eSpark-Backup/grantkros-coopmonitor/Deliverable/Main_Board/Renderings/2D_C_View.PNG

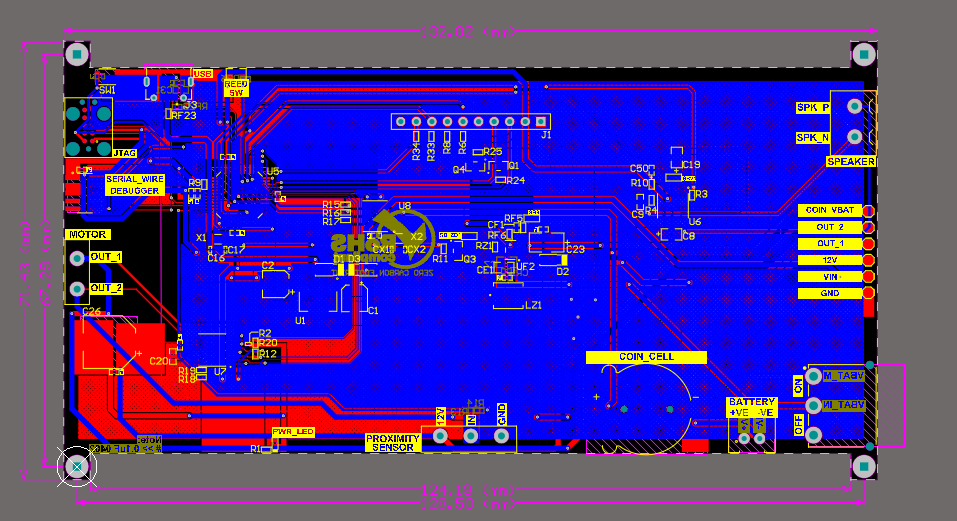
Deliverable/Main_Board/Renderings/2D_C_View.PNG
