eSpark-Backup/grantkros-coopmonitor/README.md

# GrantKros-CoopMonitor
To develop / modify existing hardware for a product that monitors and controls opening and closing of a Chicken Coop thus eliminating the need for manual operations. The product is battery powered and utilizes RTC (Real Time Clock) in order to keep track of time and open / close the door automatically at set time. The firmware Logic development is also scope of product.

# Hardware Development Document
https://docs.google.com/document/d/1zBJtBbxTIhBSu4QpVf2IS5n5_eFdffxUGF-tXFF0SV0/edit

# Firmware Development Document
https://docs.google.com/document/d/1wYKQdFfrymjJKDasLPa5_Pwm-jOFM6-b_R_Tf0VFCMQ/edit
