eSpark-Backup/grantkros-coopmonitor/Design-Files/Grant..PcbDoc.htm

Reporting Options

# File in Previous Format

Date | : | 3/16/2022
Time | : | 1:12:25 PM
Filename | : | D:\Github\GrantKros-CoopMonitor\Design-Files\Grant..PcbDoc

Version | Warning

This file was generated by an earlier version of the software
