eSpark-Backup/grantkros-coopmonitor/Deliverable/Interface_Board/Renderings/2D_Top_View.PNG

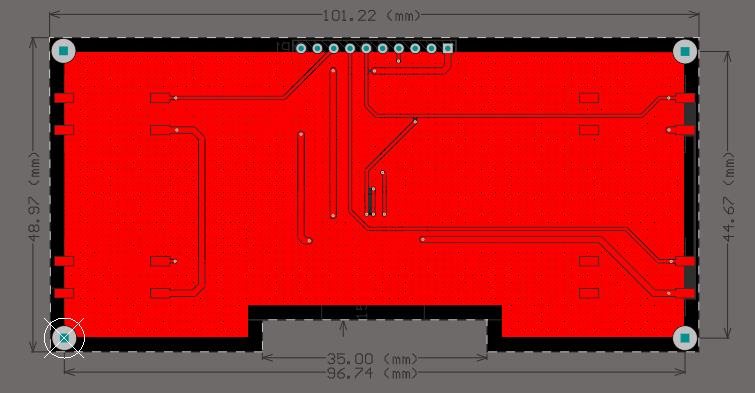
Deliverable/Interface_Board/Renderings/2D_Top_View.PNG
