eSpark-Backup/grantkros-coopmonitor/Deliverable/Interface_Board/Renderings/3D_Top_View.PNG

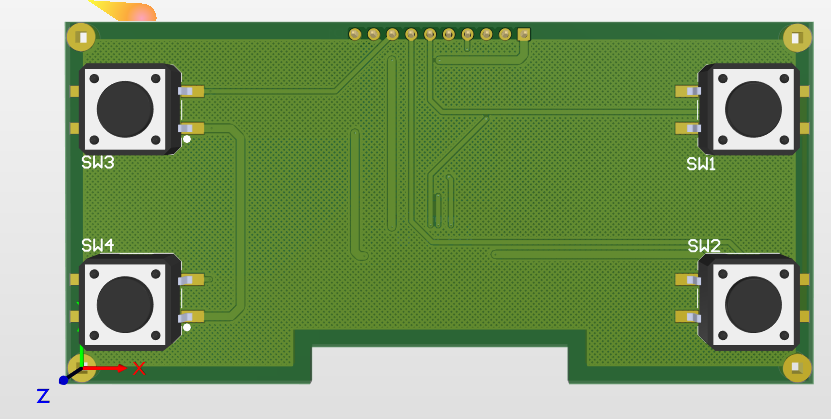
Deliverable/Interface_Board/Renderings/3D_Top_View.PNG
