eSpark-Backup/grantkros-coopmonitor/Deliverable/Interface_Board/Renderings/Isometric_View.PNG

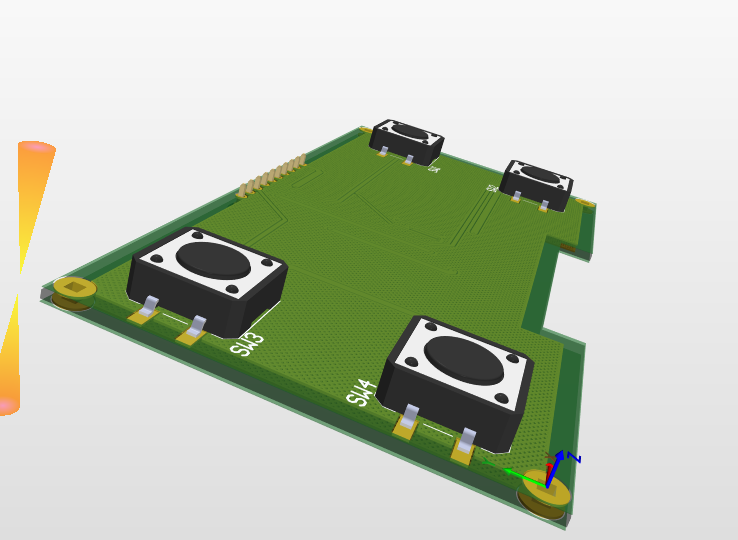
Deliverable/Interface_Board/Renderings/Isometric_View.PNG
