eSpark-Backup/grantkros-coopmonitor/Deliverable/Main_Board/Renderings/2D_Top_View.PNG

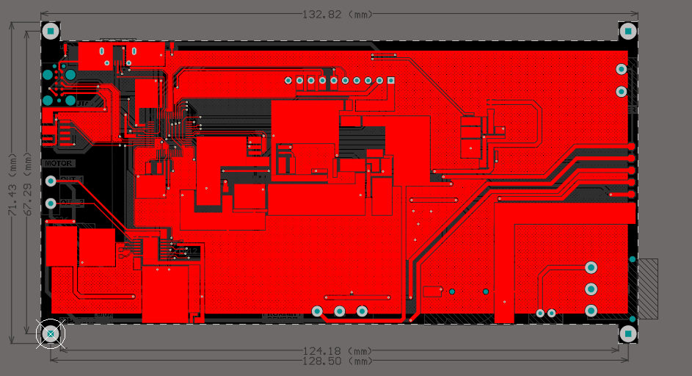
Deliverable/Main_Board/Renderings/2D_Top_View.PNG
