eSpark-Backup/grantkros-coopmonitor/Deliverable/Main_Board/Renderings/Isometric_View.PNG

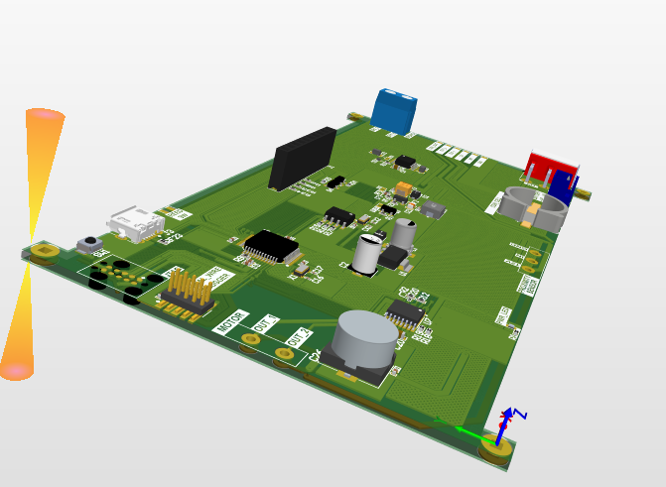
Deliverable/Main_Board/Renderings/Isometric_View.PNG
