eSpark-Backup/grantkros-coopmonitor/PCB Review/1.PNG

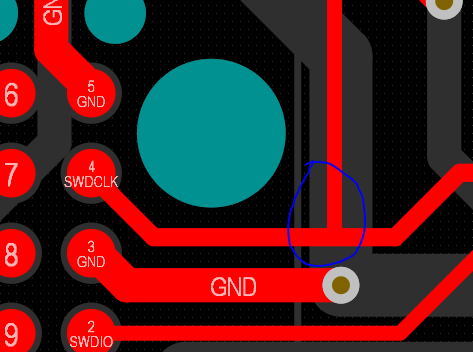
PCB Review/1.PNG
