eSpark-Backup/grantkros-coopmonitor/Deliverable/BOM/BOM - Grant LCSC.xlsx

Bill of Material (BOM) for Grant
S. No. | Comment Type | Description | Designator | Footprint (Package) | Manufacturer Part Number | LCSC Part Number | Manufacturer | Value | Quantity | Total Quantity | LCSC /MOQ | Link | Unit Price | Total Price | Remarks
1 | Capacitor | CAP CER 0.1UF 16V X7R 0402 | C1, C3, C10, C11, C12, C13, C14, C15, C18, C20, C24, C29, C30, C32, C36, CD, CF, CF1 | Cap0402 | CC0402KRX7R7BB104 | C60474 | Yageo | 0.1uF | 20 | 80 | 100 | LCSC (https://lcsc.com/product-detail/Multilayer-Ceramic-Capacitors-MLCC-SMD-SMT_YAGEO-CC0402KRX7R7BB104_C60474.html) | $0.002 | $0.24
2 |  | CAP CER 1UF 25V X5R 0402 | C2, C4 | Cap0402 | GRM155R61E105KA12D | C77009 | Murata | 1uF | 2 | 8 | 50 | LCSC (https://lcsc.com/product-detail/Multilayer-Ceramic-Capacitors-MLCC-SMD-SMT_muRata_GRM155R61E105KA12D_1uF-105-10-25V_C77009.html) | $0.007 | $0.35
3 |  | CAP CER 10000PF 25V X7R 0402 | C5, C27, CF6, CF7 | Cap0402 | CC0402KRX7R8BB103 | C327025 | Yageo | 10nF | 4 | 16 | 100 | LCSC (https://lcsc.com/product-detail/Multilayer-Ceramic-Capacitors-MLCC-SMD-SMT_YAGEO-CC0402KRX7R8BB103_C327025.html) | $0.002 | $0.22
4 |  | CAP CER 10UF 16V X5R 0603 | CF2 | Cap0603 | EMK107BBJ106MA-T | C90058 | Taiyo Yuden | 10uF | 1 | 4 | 10 | LCSC (https://lcsc.com/product-detail/Multilayer-Ceramic-Capacitors-MLCC-SMD-SMT_TAIYO-YUDEN_EMK107BBJ106MA-T_10uF-106-20-16V_C90058.html) | $0.050 | $0.50
5 |  | CAP CER 20PF 25V C0H 0201 | C16, C17, CX1, CX2 | Cap 0201 | GJM0336C1E200JB01D | C161300 | Murata | 20pF | 4 | 16 | 20 | LCSC (https://lcsc.com/product-detail/Multilayer-Ceramic-Capacitors-MLCC-SMD-SMT_Murata-Electronics-GJM0336C1E200JB01D_C161300.html) | $0.013 | $0.27
6 |  | CAP TANT POLY 100UF 16V 2917 | C19, C23 | Cap 2917 | 16TQC100MYF | C109085 | Panasonic | 100uF | 2 | 8 | 10 | LCSC (https://lcsc.com/product-detail/Tantalum-Capacitors_PANASONIC-16TQC100MYF_C109085.html) | $0.465 | $4.65
7 |  | 10pF ±5% 50V NP0 0402 | C21, C25 | Cap0402 | CC0402JRNPO9BN100 | C106199 | Yageo | 10pF | 2 | 8 | 100 | LCSC (https://lcsc.com/product-detail/Multilayer-Ceramic-Capacitors-MLCC-SMD-SMT_10pF-100-5-50V_C106199.html) | $0.002 | $0.22
8 |  | 33pF ±10% 25V NP0(C0G) 0402 Multilayer Ceramic Capacitors MLCC - SMD/SMT RoHS | C22, C26, C33, C34, C35 | Cap0402 | 0402N330K250CT | C387979 | Walsin Tech Corp | 33pF | 5 | 20 | 100 | LCSC (https://lcsc.com/product-detail/Multilayer-Ceramic-Capacitors-MLCC-SMD-SMT_Walsin-Tech-Corp-0402N330K250CT_C387979.html) | $0.003 | $0.25
9 |  | CAP CER 4.7UF 25V X5R 0603 | C31 | Cap0603 | CL10A475KA8NQNC | C69335 | Samsung | 4.7UF | 1 | 4 | 20 | LCSC (https://lcsc.com/product-detail/Multilayer-Ceramic-Capacitors-MLCC-SMD-SMT_Samsung-Electro-Mechanics-CL10A475KA8NQNC_C69335.html) | $0.027 | $0.54
10 |  | CAP CER 22UF 25V X5R 0805 | C3Z, C37, C40, CC, CE | Cap0805 | GRM21BR61E226ME44L | C86816 | Murata | 22uF | 5 | 20 | 25 | LCSC (https://lcsc.com/product-detail/Multilayer-Ceramic-Capacitors-MLCC-SMD-SMT_Murata-Electronics-GRM21BR61E226ME44L_C86816.html) | $0.095 | $2.37
11 |  | CAP TANT 4.7UF 20% 35V 1411 | C4Z, C38 | Cap 1411 | TC211B475M035Y | C128334 | Sunlord | 4.7UF | 2 | 8 | 10 | LCSC (https://lcsc.com/product-detail/Tantalum-Capacitors_Sunlord-TC211B475M035Y_C128334.html) | $0.133 | $1.33
12 |  | CAP TANT 220UF 20% 16V 2917 | CF3 | CAP2917 | T491X227M016AT | C117040 | KEMET | 220uF | 1 | 4 | 5 | LCSC (https://lcsc.com/product-detail/Tantalum-Capacitors_KEMET-T491X227M016AT_C117040.html) | $1.340 | $6.70
13 |  | CAP CER 2.2UF 16V X5R 0402 | CR1 | Cap0402 | CL05A225KO5NQNC | C170151 | Samsung | 2.2uF | 1 | 4 | 50 | LCSC (https://lcsc.com/product-detail/Multilayer-Ceramic-Capacitors-MLCC-SMD-SMT_SAMSUNG_CL05A225KO5NQNC_2-2uF-225-10-16V_C170151.html) | $0.012 | $0.58
14 |  | CAP CER 100nF 25V X7R 0402 | C6 | Cap0402 | CC0402KRX7R8BB104 | C105883 | Yageo | 100nF | 1 | 4 | 50 | LCSC (https://lcsc.com/product-detail/Multilayer-Ceramic-Capacitors-MLCC-SMD-SMT_100nF-104-10-25V_C105883.html) | $0.004 | $0.19
15 |  | CAP CER 220PF 50V C0G/NPO 0402 | CF17 | Cap0402 | CC0402JRNPO9BN221 | C107001 | Yageo | 220pF | 1 | 4 | 50 | LCSC (https://lcsc.com/product-detail/Multilayer-Ceramic-Capacitors-MLCC-SMD-SMT_YAGEO-CC0402JRNPO9BN221_C107001.html) | $0.005 | $0.23
16 | Diode | DIODE SCHOTTKY 30V 1A SOD123W | D1, D3, D3Z | SOD123W | PMEG3010ER,115 | C456106 | Nexperia | ----- | 3 | 12 | 13 | LCSC (https://lcsc.com/product-detail/Schottky-Barrier-Diodes-SBD_Nexperia-PMEG3010ER-115_C456106.html) | $0.113 | $1.47
17 |  | 5.1V 800mW 5uA @ 1V SOD-123FL Zener Diodes RoHS | D2 | Custom | BZD27C5V1P_R1_00001 | C313479 | PANJIT International | ----- | 1 | 4 | 10 | LCSC (https://lcsc.com/product-detail/Zener-Diodes_PANJIT-International-BZD27C5V1P-R1-00001_C313479.html) | $0.062 | $0.62
18 |  | TVS Diode Bidirectional 3.3V Standoff | D4 | Custom | ESD9B3.3ST5G-N | C316039 | Bourne Semicon | ----- | 1 | 4 | 20 | LCSC (https://lcsc.com/product-detail/TVS_Bourne-Semicon-Shenzhen-ESD9B3-3ST5G-N_C316039.html) | $0.018 | $0.37
19 |  | DIODE SCHOTTKY 40V 3A SMA | DF1 | Custom | B340A-13-F | C85098 | Diodes | ----- | 1 | 4 | 5 | LCSC (https://lcsc.com/product-detail/Schottky-Barrier-Diodes-SBD_DIODES_B340A-13-F_B340A-13-F_C85098.html) | $0.069 | $0.35
20 | LED | Red 615-635nm 0402 LED | LED1, LED2 | LED 0402 | 2SA0402S11A0JT01 | C233194 | Brightek Optoelectronics | ----- | 2 | 8 | 10 | LCSC (https://lcsc.com/product-detail/Light-Emitting-Diodes-LED_Brightek-Optoelectronics-2SA0402S11A0JT01_C233194.html) | $0.044 | $0.44
21 |  | Blue 465nm 0402 Light Emitting Diodes (LED) RoHS | LED3 | LED 0402 | TJ-S1005SW4TGLC6B-A5 | C273603 | TOGIALED | ----- | 1 | 4 | 10 | LCSC (https://lcsc.com/product-detail/Light-Emitting-Diodes-LED_TOGIALED-TJ-S1005SW4TGLC6B-A5_C273603.html) | $0.040 | $0.40
22 |  | Green 573nm 0402 Light Emitting Diodes (LED) RoHS | LED4, LEDF1 | LED 0402 | TJ-S1005SW4TGLC7K-A5 | C273601 | TOGIALED | ----- | 2 | 8 | 10 | LCSC (https://lcsc.com/product-detail/Light-Emitting-Diodes-LED_TOGIALED-TJ-S1005SW4TGLC7K-A5_C273601.html) | $0.040 | $0.40
23 | Mosfet | MOSFET P-CHAN 24V SOT23 | Q1 | SOT23-3 | DMP2045U-7 | C459541 | Diodes | ----- | 1 | 4 | 5 | LCSC (https://lcsc.com/product-detail/MOSFET_Diodes-Incorporated-DMP2045U-7_C459541.html) | $0.110 | $0.55
24 |  | MOSFET P-CH 20V 2.8A SOT-23 | Q2 | SOT23-3 | PMV65XP,215 | C75561 | Nexperia | ----- | 1 | 4 | 10 | LCSC (https://lcsc.com/product-detail/MOSFET_Nexperia-PMV65XP-215_C75561.html) | $0.053 | $0.53
25 |  | MOSFET N-CH 50V 200MA SOT-23 | Q4, Q5, Q6, QF3, QF4, QF7 | SOT23-3 | BSS138LT1G | C8490 | ON Semiconductor | ----- | 6 | 24 | 40 | LCSC (https://lcsc.com/product-detail/MOSFET_Leshan-Radio-LBSS138LT1G_C8490.html) | $0.018 | $0.74
26 |  | MOSFET N-CH 100V 100mA SOT23 | Q7 | SOT23-3 | ZVN3310FTA | C110533 | Diodes | ----- | 1 | 4 | 5 | LCSC (https://lcsc.com/product-detail/MOSFET_Diodes-Incorporated_ZVN3310FTA_Diodes-Incorporated-ZVN3310FTA_C110533.html) | $0.110 | $0.55
27 |  | MOSFET 2N-CH 60V 0.32A 6TSSOP | Q8 | SOT-363 | BSS138PS,115 | C193381 | Nexperia | ----- | 1 | 4 | 10 | LCSC (https://lcsc.com/product-detail/MOSFET_Nexperia-BSS138PS-115_C193381.html) | $0.063 | $0.63
28 |  | TRANS PNP 60V 3A SOT-223 | QF1 | SOT-223 | NZT660 | C274629 | ON Semiconductor | ----- | 1 | 4 | 5 | LCSC (https://lcsc.com/product-detail/Transistors-NPN-PNP_ON-Semiconductor-ON-NZT660_C274629.html) | $0.231 | $1.15
29 | Inductor | 10uH ±20% 1.6A 230mΩ SMD,4.75x4.2x2mm Inductors (SMD) RoHS | L1, LZ | Custom | MS0420-100M | C380158 | COILMX | ----- | 2 | 8 | 10 | LCSC (https://lcsc.com/product-detail/Inductors-SMD_COILMX-MS0420-100M_C380158.html) | $0.172 | $1.72
30 |  | 15uH ±20% 2.5A 56mΩ SMD,8.0x8.0mm Inductors (SMD) RoHS | L2 | Custom | SNR8040K-150M | C326353 | 3L COILS | ----- | 1 | 4 | 5 | LCSC (https://lcsc.com/product-detail/Inductors-SMD_3L-COILS-SNR8040K-150M_C326353.html) | $0.163 | $0.81
31 | Switch | SPDT 5A 120V On-On DIP Toggle Switches RoHS | S1 | Custom | SS-12D11L5 | C319010 | XKB Enterprise | ----- | 1 | 4 | 5 | LCSC (https://lcsc.com/product-detail/Toggle-Switches_XKB-Enterprise-SS-12D11L5_C319010.html) | $0.312 | $1.56
32 |  | SWITCH TACTILE SPST-NO 0.05A 12V | SW1 | Custom | B3U-1000P | C231329 | Omron | ----- | 1 | 4 | 5 | LCSC (https://lcsc.com/product-detail/Others_Omron-Electronics_B3U-1000P_Omron-Electronics-B3U-1000P_C231329.html) | $0.326 | $1.63
33 | Resistor | 470 ±5% 1/16W ±100ppm/°C 0402 Chip Resistor - Surface Mount RoHS | R1 | Res0402 | RTT02471JTH | C103058 | RALEC | 470R | 1 | 4 | 100 | LCSC (https://lcsc.com/product-detail/Chip-Resistor-Surface-Mount_RALEC-RTT02471JTH_C103058.html) | $0.002 | $0.18
34 |  | RES SMD 100K OHM 1% 1/5W 0402 | R2 | Res0402 | ERJPA2F1003X | C427253 | Panasonic | 100K | 1 | 4 | 10 | LCSC (https://lcsc.com/product-detail/Chip-Resistor-Surface-Mount_PANASONIC-ERJPA2F1003X_C427253.html) | $0.038 | $0.38
35 |  | RES SMD 2K OHM 1% 1/16W 0402 | R5 | Res0402 | RC0402FR-072KL | C60488 | Yageo | 2K | 1 | 4 | 100 | LCSC (https://lcsc.com/product-detail/Chip-Resistor-Surface-Mount_2KR-2001-1_C60488.html) | $0.001 | $0.11
36 |  | RES SMD 80.6K OHM 1% 1/16W 0402 | R6 | Res0402 | AC0402FR-0780K6L | C227238 | Yageo | 80.6K | 1 | 4 | 100 | LCSC (https://lcsc.com/product-detail/Chip-Resistor-Surface-Mount_YAGEO-AC0402FR-0780K6L_C227238.html) | $0.001 | $0.13
37 |  | RES SMD 30.9K OHM 1% 1/16W 0402 | R7 | Res0402 | AC0402FR-0730K9L | C226983 | Yageo | 30.9K | 1 | 4 | 100 | LCSC (https://lcsc.com/product-detail/Chip-Resistor-Surface-Mount_YAGEO-AC0402FR-0730K9L_C226983.html) | $0.002 | $0.17
38 |  | RES SMD 20K OHM 5% 1/16W 0402 | R8, R9, RP2 | Res0402 | RC0402JR-0720KL | C137902 | Yageo | 20K | 3 | 12 | 100 | LCSC (https://lcsc.com/product-detail/Chip-Resistor-Surface-Mount_20KR-203-5_C137902.html) | $0.002 | $0.19
39 |  | RES SMD 2.2K OHM 1% 1/16W 0402 | R10, R11, R31 | Res0402 | RC0402FR-072K2L | C114762 | Yageo | 2.2K | 3 | 12 | 100 | LCSC (https://lcsc.com/product-detail/Chip-Resistor-Surface-Mount_2-2KR-2201-1_C114762.html) | $0.001 | $0.11
40 |  | 4.7K ±5% 1/16W ±200ppm/°C 0402 Chip Resistor - Surface Mount RoHS | R12, R13, R14, R18, RF6, RF7, RF10, RF13 | Res0402 | CR0402JF0472G | C100658 | LIZ Elec | 4.7K | 8 | 32 | 50 | LCSC (https://lcsc.com/product-detail/Chip-Resistor-Surface-Mount_LIZ-Elec-CR0402JF0472G_C100658.html) | $0.003 | $0.15
41 |  | RES SMD 47K OHM 1% 1/16W 0402 | R16, R17, R19, RB1, RF8, RF11, RF14, RZ | Res0402 | RC0402FR-0747KL | C93943 | Yageo | 47K | 8 | 32 | 100 | LCSC (https://lcsc.com/product-detail/Chip-Resistor-Surface-Mount_YAGEO-RC0402FR-0747KL_C93943.html) | $0.002 | $0.24
42 |  | 15K ±5% 1/10W ±200ppm/℃ 0402 Chip Resistor - Surface Mount RoHS | R20 | Res0402 | RMC10-153JTH | C323744 | KAMAYA | 15K | 1 | 4 | 100 | LCSC (https://lcsc.com/product-detail/Chip-Resistor-Surface-Mount_KAMAYA-RMC10-153JTH_C323744.html) | $0.002 | $0.20
43 |  | 1.4M ±1% ±100ppm/°C 0603 Chip Resistor - Surface Mount RoHS | R21 | Res0603 | AC0603FR-071M4L | C227673 | Yageo | 1.4M | 1 | 4 | 100 | LCSC (https://lcsc.com/product-detail/Chip-Resistor-Surface-Mount_YAGEO-AC0603FR-071M4L_C227673.html) | $0.002 | $0.22
44 |  | RES SMD 71.5K OHM 1% 1/16W 0402 | R22 | Res0402 | AC0402FR-0771K5L | C227214 | Yageo | 71.5K | 1 | 4 | 100 | LCSC (https://lcsc.com/product-detail/Chip-Resistor-Surface-Mount_YAGEO-AC0402FR-0771K5L_C227214.html) | $0.001 | $0.14
45 |  | RES 10K OHM 5% 1/10W 0402 | R23, R24, R25, R26, RF5, RR1, RS1, RS2, RS3, RS4 | Res0402 | RK73B1ETTP103J | C159873 | KOA Speer | 10K | 10 | 40 | 100 | LCSC (https://lcsc.com/product-detail/Chip-Resistor-Surface-Mount_10KR-103-5_C159873.html) | $0.002 | $0.20
46 |  | RES SMD 133K OHM 1% 1/16W 0402 | R27 | Res0402 | RC0402FR-07133KL | C327374 | Yageo | 133K | 1 | 4 | 100 | LCSC (https://lcsc.com/product-detail/Chip-Resistor-Surface-Mount_YAGEO-RC0402FR-07133KL_C327374.html) | $0.001 | $0.11
47 |  | RES 49.9K OHM 1% 1/10W 0402 | R28 | Res0402 | RK73H1ETTP4992F | C173335 | KOA Speer | 49.9K | 1 | 4 | 100 | LCSC (https://lcsc.com/product-detail/Chip-Resistor-Surface-Mount_49-9KR-4992-1_C173335.html) | $0.002 | $0.25
48 |  | 0.068 ±1% 1/4W ±800ppm/°C 0805 Chip Resistor - Surface Mount RoHS | RF1 | Res0805 | 0805W4F680MT5E | C52472 | UNI-ROYAL(Uniroyal Elec) | 0.068R | 1 | 4 | 50 | LCSC (https://lcsc.com/product-detail/Chip-Resistor-Surface-Mount_UNI-ROYAL-Uniroyal-Elec-0805W4F680MT5E_C52472.html) | $0.009 | $0.46
49 |  | RES SMD 1K OHM 5% 1/10W 0402 | RF2 | Res0402 | ERJ-2GEJ102X | C105637 | Panasonic | 1K | 1 | 4 | 100 | LCSC (https://lcsc.com/product-detail/Chip-Resistor-Surface-Mount_1KR-102-5_C105637.html) | $0.001 | $0.10
50 |  | RES SMD 1M OHM 1% 1/16W 0402 | RF3, RF4 | Res0402 | RC0402FR-071ML | C138033 | Yageo | 1M | 2 | 8 | 100 | LCSC (https://lcsc.com/product-detail/Chip-Resistor-Surface-Mount_1MR-1004-1_C138033.html) | $0.001 | $0.11
51 |  | RES SMD 13.3K OHM 1% 1/16W 0402 | RF16 | Res0402 | RC0402FR-0713K3L | C274352 | Yageo | 13.3K | 1 | 4 | 100 | LCSC (https://lcsc.com/product-detail/Others_YAGEO-RC0402FR-0713K3L_C274352.html) | $0.001 | $0.13
52 |  | RES SMD 0 OHM JUMPER 1/16W 0402 | RF21, RF22, RF23, RF24 | Res0402 | RC0402JR-070RL | C60485 | Yageo | 0R | 4 | 16 | 100 | LCSC (https://lcsc.com/product-detail/Chip-Resistor-Surface-Mount_YAGEO-RC0402JR-070RL_C60485.html) | $0.001 | $0.07
53 |  | RES SMD 118K OHM 1% 1/16W 0402 | RF31 | Res0402 | 0402WGF1183TCE | C25748 | UNI-ROYAL(Uniroyal Elec) | 118K | 1 | 4 | 100 | LCSC (https://lcsc.com/product-detail/Chip-Resistor-Surface-Mount_UNI-ROYAL-Uniroyal-Elec-0402WGF1183TCE_C25748.html) | $0.001 | $0.08
54 |  | RES SMD 60.4K OHM 1% 1/16W 0402 | RP1 | Res0402 | RC0402FR-0760K4L | C327333 | Yageo | 60.4K | 1 | 4 | 100 | LCSC (https://lcsc.com/product-detail/Chip-Resistor-Surface-Mount_YAGEO-RC0402FR-0760K4L_C327333.html) | $0.001 | $0.10
55 |  | RES SMD 62K OHM 1% 1/16W 0402 | RP3 | Res0402 | AC0402FR-0762KL | C144742 | Yageo | 62K | 1 | 4 | 100 | LCSC (https://lcsc.com/product-detail/Chip-Resistor-Surface-Mount_62KR-6202-1_C144742.html) | $0.002 | $0.21
56 |  | 40.2K ±1% 1/16W ±100ppm/°C 0402 Chip Resistor - Surface Mount RoHS | R101, RP4 | Res0402 | RTT024022FTH | C103027 | RALEC | 40.2K | 2 | 8 | 100 | LCSC (https://lcsc.com/product-detail/Chip-Resistor-Surface-Mount_RALEC-RTT024022FTH_C103027.html) | $0.001 | $0.09
57 | IC | IC REG LINEAR 3.3V 500MA MICRO8 | U1 | MICRO8 | NCP3335ADM330R2G | C154793 | ON Semiconductor | ----- | 1 | 4 | 5 | LCSC (https://lcsc.com/product-detail/Linear-Voltage-Regulators_ON-Semiconductor-NCP3335ADM330R2G_C154793.html) | $0.970 | $4.85
58 |  | TVS DIODE 5V 6.8V 6UDFN | U2 | UDFN-6 | SP3014-02UTG | C207282 | Littlefuse | ----- | 1 | 4 | 5 | LCSC (https://lcsc.com/product-detail/Others_Littelfuse_SP3014-02UTG_Littelfuse-SP3014-02UTG_C207282.html) | $0.210 | $1.05
59 |  | IC VREF SHUNT 18V 0.5% SOT23 | U3 | SOT23-3 | TLV431BFTA | C189220 | Diodes Zetex | ----- | 1 | 4 | 5 | LCSC (https://lcsc.com/product-detail/Voltage-References_Diodes-Incorporated-TLV431BFTA_C189220.html) | $0.188 | $0.94
60 |  | IC COMPARATOR LP DUAL 8-SOIC | U4 | 8-SOIC | LM393DT | C32901 | STMicroelectronics | ----- | 1 | 4 | 10 | LCSC (https://lcsc.com/product-detail/Analog-Comparators_STMicroelectronics_LM393DT_LM393DT_C32901.html) | $0.058 | $0.58
61 |  | IC MCU 32BIT 256KB FLASH 48TQFP | U5 | TQFP-48 | SAMD21G18A-AUT | C78624 | Microchip | ----- | 1 | 4 | 4 | LCSC (https://lcsc.com/product-detail/ATMEL-AVR_Microchip-Tech-ATSAMD21G18A-AU_C78624.html) | $4.669 | $18.68 | out of stock
62 |  | UMTS/HSPA+ Module | U6 | Custom | UC200T |  | Quectel | ----- | 1 | 4 | 4 | ----- | ----- | ----- | Will be sourced from external supplier
63 |  | GLOBAL IOT EMBEDDED SIM CHIP | U8 | Custom | SIM-ST-MFF2 |  | Hologram | ----- | 1 | 4 | 4 | ----- | ----- | ----- | Will be sourced from external supplier
64 |  | Step-Up Positive Adjustable 1 2A 1.2MHz SOT-23-6 DC-DC Converters RoHS | U9 | SOT-23-6 | AX5523CA | C157694 | Axelite Tech | ----- | 1 | 4 | 5 | LCSC (https://lcsc.com/product-detail/Others_Axelite-Tech-AX5523CA_C157694.html) | $0.239 | $1.19
65 |  | IC MOTOR DRVR UNIPLR 8SO PWRPAD | U10 | 8SO | DRV8871DDAR | C75864 | Texas Instruments | ----- | 1 | 4 | 4 | LCSC (https://lcsc.com/product-detail/Motor-Drivers_Texas-Instruments_DRV8871DDAR_Texas-Instruments-Texas-Instruments-DRV8871DDAR_C75864.html) | $1.766 | $7.06
66 |  | IC RTC CLK/CALENDAR I2C 8-SOIC | U11 | 8-SOIC | MCP7940N-I/SN | C51106 | Microchip | ----- | 1 | 4 | 4 | LCSC (https://lcsc.com/product-detail/Real-time-Clocks_MICROCHIP_MCP7940N-I-SN_MCP7940N-I-SN_C51106.html) | $0.939 | $3.75
67 |  | IC LI-ION LDO CHARGE MGMT 8SOIC | UF1 | 8-SOIC | BQ2057WSNTR | C32756 | Texas Instruments | ----- | 1 | 4 | 4 | LCSC (https://lcsc.com/product-detail/PMIC-Battery-Management_Texas-Instruments_BQ2057WSNTR_Texas-Instruments-Texas-Instruments-BQ2057WSNTR_C32756.html) | $1.244 | $4.98
68 |  | IC REG BOOST ADJ 2A SOT23-5 | UF2 | SOT23-5 | LMR62014XMFX/NOPB | C468235 | Texas Instruments | ----- | 1 | 4 | 4 | LCSC (https://lcsc.com/product-detail/DC-DC-Converters_Texas-Instruments-Texas-Instruments-LMR62014XMFX-NOPB_C468235.html) | $0.585 | $2.34
69 |  | IC REG BUCK ADJUSTABLE 3A 8SOPWR | UF5 | 8SOPWR | TPS5430QDDARQ1 | C388178 | Texas Instruments | ----- | 1 | 4 | 4 | LCSC (https://lcsc.com/product-detail/DC-DC-Converters_Texas-Instruments_TPS5430QDDARQ1_Texas-Instruments-Texas-Instruments-TPS5430QDDARQ1_C388178.html) | $1.521 | $6.08
70 | Crystal | CRYSTAL 32.7680KHZ 12.5PF SMD | X3, X1 | Custom | NX3215SA-32.768K-STD-MUA-8 | C156245 | NDK | ----- | 2 | 8 | 10 | LCSC (https://lcsc.com/product-detail/SMD-Crystal-Resonators_Nihon-Dempa-Kogyo-NX3215SA-32-768KHZ-STD-MUA-8_C156245.html) | $0.184 | $1.84
71 | Connector | CONN U.FL RCPT STR 50 OHM SMD | J1 | Custom | U.FL-R-SMT-1(80) |  | Hirose | ----- | 1 | 4 | 5 | LCSC (https://lcsc.com/product-detail/RF-Connectors-Coaxial-Connectors_HRS-Hirose_U-FL-R-SMT-1-80_HRS-Hirose-HRS-U-FL-R-SMT-1-80_C88374.html) | ----- | ----- | Will be sourced from external supplier
72 |  | USB - Micro B Female USB 2 5 SMD USB Connectors RoHS | J3 | Custom | C10418 | C10418 | Jing Extension of the Electronic Co. | ----- | 1 | 4 | 5 | LCSC (https://lcsc.com/product-detail/USB-Connectors_Jing-Extension-of-the-Electronic-Co-C10418_C10418.html) | $0.060 | $0.30
73 |  | CONN HEADER SMD 10POS 1.27MM | J4 | Custom | 20021121-00010C4LF | C150517 | Amphenol ICC' | ----- | 1 | 4 | 4 | LCSC (https://lcsc.com/product-detail/Pin-Header-Female-Header_Amphenol-ICC-20021121-00010C4LF_C150517.html) | $0.743 | $2.97
74 |  | CBL PLUG-OF-NAILS 10-PIN W/LEGS | J5 | Custom | TC2050-IDC |  | Tag-Connect | ----- | 1 | 1 | 1 | ----- | ----- | ----- | Will be sourced from external supplier
75 |  | SMD Battery Holders, Clips & Contacts RoHS | J6 | Custom | CR1220-2 | C70381 | Q&J | ----- | 1 | 4 | 4 | LCSC (https://lcsc.com/product-detail/Battery-Holders-Clips-Contacts_Q-J-CR1220-2_C70381.html) | $0.200 | $0.80
76 |  | P=5.0mm Screw terminal RoHS | J7 | Custom | WJ301V-5.0-3P | C8483 | Ningbo Kangnex Elec | ----- | 1 | 4 | 5 | LCSC (https://lcsc.com/product-detail/Pluggable-System-Terminal-Block_Ningbo-Kangnex-Elec-WJ301V-5-0-3P_C8483.html) | $0.092 | $0.46
77 |  | P=5.0mm Screw terminal RoHS | J8 | Custom | WJ301V-5.0-2P | C8475 | Ningbo Kangnex Elec | ----- | 1 | 4 | 5 | LCSC (https://lcsc.com/product-detail/Pluggable-System-Terminal-Block_Ningbo-Kangnex-Elec-WJ301V-5-0-2P_C8475.html) | $0.062 | $0.31
78 |  | CONN PWR JACK 2.1X5.5MM SOLDER | J2 | Custom | DC-005-5A-2.5-SMT | C319133 | XKB Enterprise | ----- | 1 | 4 | 4 | LCSC (https://lcsc.com/product-detail/Power-Connectors_XKB-Enterprise-DC-005-5A-2-5-SMT_C319133.html) | $0.175 | $0.70
79 |  | CONN HEADER VERT 2POS 2.54MM | P1 | Custom | Header 1x2 | C390678 | Wurth Electronics | ----- | 1 | 4 | 50 | LCSC (https://lcsc.com/product-detail/Pin-Header-Female-Header_PINREX-210-91-02GB01_C390678.html) | $0.007 | $0.35
80 |  | Test Point ON | P2, P3, P12, P13, P14, P15, P16 | TEST POINT | TEST POINT |  | ----- | ----- | 7 | 28 | ----- | ----- | ----- | ----- | DO NOT MOUNT
81 |  | Solder Bridge ON | SB1, SB2, SB4, SB5, SB6, SB11, SB11x, SB12, SB13, SB14, SB15, SB16, SB17, SB18, SB19, SB20, SB_AD, SB_ZD | Solder Bridge | Solder Bridge |  | ----- | ----- | 18 | 72 | ----- | ----- | ----- | ----- | DO NOT MOUNT
82 |  | 2 PIN JST Connector Mating Part | - |  |  |  | ----- |  | 1 | 4 |  |  |  |  | Will be sourced from external supplier
83 |  | 2 PIN JST Connector | P17 |  |  |  | ----- |  | 1 | 4 |  |  |  |  | Will be sourced from external supplier
 |  |  |  |  |  |  |  |  | Total Component Cost |  |  |  |  | $95.92
 |  |  |  |  |  |  |  |  | Custom Charges |  |  |  |  | $35
 |  | Notes: |  |  |  |  |  |  | Shipping Charges |  |  |  |  | $70
 |  | 1- The costing is done for Four (4) boards. All components will be calculated with multiplication factor Four (4). |  |  |  |  |  |  | Total |  |  |  |  | $200.920291
 |  | 2- Supplier costing and custom charges are added in the final cost.
