eSpark-Backup/grantkros-coopmonitor/Deliverable/Interface_Board/BOM/(5 Boards)Digikey-Interface-Board-BOM.xlsx

Bill of Material (BOM) for Grant Interface Board
S. No. | Components | Description | Designator | Footprint (Package) | Manufacturer Part Number | Manufacturer | Alternate | Value | Quantity (Per Board) | Quantity 5 | Link | Unit Cost(5) | Total Cost(5) | Remarks
1 | Capacitor | CAP CER 0.1UF 16V X7R 0402 | C1, C2, C3, C4, C35 | Cap 0402 | CC0402KRX7R7BB104 | Yageo | ------- | 0.1uF | 5 | 25 | Digikey (https://www.digikey.com/en/products/detail/yageo/CC0402KRX7R7BB104/2103076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) | $0.0290 | $0.7250
2 |  | CAP CER 1UF 25V X5R 0402 | C28, C32 | Cap 0402 | GRM155R61E105KA12D | Murata | ------- | 1uF | 2 | 10 | Digikey (https://www.digikey.com/en/products/detail/murata-electronics/GRM155R61E105KA12D/4905139) | $0.0800 | $0.8000
3 |  | CAP CER 2.2UF 16V X5R 0402 | C33 | Cap 0402 | EMK105ABJ225KV-F | Taiyo Yuden | ------- | 2.2uF | 1 | 5 | Digikey (https://www.digikey.com/en/products/detail/taiyo-yuden/EMK105ABJ225KV-F/7403764) | $0.1560 | $0.7800
4 |  | CAP CER 4.7UF 25V X5R 0603 | C34 | Cap 0603 | CL10A475KA8NQNC | Samsung | ------- | 4.7uF | 1 | 5 | Digikey (https://www.digikey.com/en/products/detail/samsung-electro-mechanics/CL10A475KA8NQNC/3887558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) | $0.3800 | $1.9000
5 | Switch | No NO 50mA 12mm 100mΩ 200000 260gf 12V -30℃~+85℃ 12mm 5mm Black Round Button Brick nogging SPST SMD Tactile Switches ROHS | SW1, SW2, SW3, SW4 | Custom | TS-1103S-C-C | XKB | ------- | ------- | 4 | 20 | Digikey (https://www.digikey.com/en/products/detail/w%C3%BCrth-elektronik/430162043826/9950802) | $0.4860 | $9.7200
6 | Resistor | 4.7K ±5% 1/16W ±200ppm/°C 0402 Chip Resistor - Surface Mount RoHS | R21, R22, R27 | Res0402 | ~~CR0402JF0472G~~ | LIZ Elec | RC0402FR-074K7L | 4.7K | 3 | 15 | Digikey (https://www.digikey.com/en/products/detail/yageo/RC0402FR-074K7L/2827563) | $0.0160 | $0.2400
7 |  | ±1% 1/10W Thick Film Resistors 75V ±100ppm/℃ -55℃~+155℃ 910kΩ 0603 Chip Resistor - Surface Mount ROHS | R23 | Res0603 | ~~0603WAF9103T5E~~ | UNI-ROYAL | RC0603JR-07910KL | 910K | 1 | 5 | Digikey (https://www.digikey.com/en/products/detail/yageo/RC0603JR-07910KL/726839) | $0.1000 | $0.5000
8 | Connector | CONN HEADER VERT 10POS 2.54MM | P1 | Custom | M20-9991045 | Harwin | ------- | ------- | 1 | 5 | Digikey (https://www.digikey.com/en/products/detail/harwin-inc/M20-9991045/3727809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) | $0.4600 | $2.3000
9 |  | FPC Connector 0.5mm pitch 24pin 30pin TOP&bottom conduction Zif Smt Lcd/epaper Fpc Ffc Connector | J1 | Custom | 8.02A0.024200 | ------- | ------- | ------- | 1 | 5 | Custom Supplier | $1.1500 | $5.7500
 |  |  |  |  |  | Total Component Cost |  |  |  |  |  |  | $22.7150
 |  |  |  |  |  | Single Board Cost |  |  |  |  |  |  | $4.5430
