eSpark-Backup/grantkros-coopmonitor/Deliverable/Interface_Board/BOM/LCSC_BOM.xlsx

Bill of Material (BOM) for Grant
S. No. | Comment Type | Description | Designator | Footprint (Package) | Manufacturer Part Number | Manufacturer | LCSC Part Number | Alternate | Value | Unit Quantity | Quantity(5) | Quantity(50) | Quantity(100) | MOQ(5) | MOQ(50) | MOQ(100) | Link | Unit Price(5) | Total Price | Unit Price(50) | Total Price | Unit Price(100) | Total Price | Remarks
1 | Capacitor | CAP ALUM 6.8UF 20% 25V SMD | C1 | Custom | EEEHB1E6R8R | Panasonic | C336258 | -------- | 6.8uF | 1 | 5 | 50 | 100 | 10 | 60 | 110 | LCSC (https://lcsc.com/product-detail/Aluminum-Electrolytic-Capacitors-SMD_PANASONIC-EEEHB1E6R8R_C336258.html) | $0.0713 | $0.7130 | $0.0602 | $3.6120 | $0.0509 | $5.5990
2 |  | CAP ALUM 10uF 25V SMD | C2 | Custom | RVT1E100M0405 | ROQANG | C72484 | -------- | 10uF | 1 | 5 | 50 | 100 | 20 | 60 | 120 | LCSC (https://lcsc.com/product-detail/Aluminum-Electrolytic-Capacitors-SMD_ROQANG-RVT1E100M0405_C72484.html) | $0.0388 | $0.7760 | $0.0388 | $2.3280 | $0.0388 | $4.6560
3 |  | CAP CER 0.1UF 50V X7R 0402 | C6, C10, C11, C12, C13, C14, C15, C18, C21, C24, C29, C30, CF2,C22, C25, C27, C35 | Cap 0402 | ~~CC0402KRX7R7BB104~~ | Yageo | C361198 | C1005X7R1H104KT000F | 0.1uF | 17 | 85 | 850 | 1700 | 100 | 900 | 1750 | LCSC (https://lcsc.com/product-detail/Multilayer-Ceramic-Capacitors-MLCC-SMD-SMT_TDK-C1005X7R1H104KT000F_C361198.html) | $0.0187 | $1.8700 | $0.0160 | $14.4000 | $0.0140 | $24.5000 | Ye part change kia ha voltage rating ki waja se design me 16V ka part use ho raha ha or 'C22, C25, C27, C35 ye designator merge kiye han humne iska footprint 0603 ha ye design me b change krne han hume
4 |  | CAP CER 22UF 25V X5R 0805 | C7, CE1 | Cap0805 | GRM21BR61E226ME44L | Murata | C86816 | -------- | 22uF | 2 | 10 | 100 | 200 | 15 | 110 | 210 | LCSC (https://lcsc.com/product-detail/Multilayer-Ceramic-Capacitors-MLCC-SMD-SMT_Murata-Electronics-GRM21BR61E226ME44L_C86816.html) | $0.0889 | $1.3335 | $0.0746 | $8.2060 | $0.0629 | $13.2090
5 |  | 1uF 10V ±20% 0805 Tantalum Capacitors ROHS | C8, C19 | Cap0805 | TCP1A105M8R | ROHM | C1952948 | -------- | 1UF | 2 | 10 | 100 | 200 | 15 | 110 | 210 | LCSC (https://lcsc.com/product-detail/Tantalum-Capacitors_ROHM-Semicon-TCP1A105M8R_C1952948.html) | $0.2525 | $3.7875 | $0.1828 | $20.1080 | $0.1828 | $38.3880
6 |  | CAP CER 25PF 50V C0G/NPO 0603 | C9 | Cap 0603 | CC0603JRNPO9BN250 | YAGEO | C282067 | -------- | 25pF | 1 | 5 | 50 | 100 | 50 | 100 | 150 | LCSC (https://lcsc.com/product-detail/Multilayer-Ceramic-Capacitors-MLCC-SMD-SMT_YAGEO-CC0603JRNPO9BN250_C282067.html) | $0.0058 | $0.2900 | $0.0058 | $0.5800 | $0.0058 | $0.8700
7 |  | CAP CER 20PF 25V C0H 0201 | C16, C17, CX1, CX2 | Cap 0201 | ~~GJM0336C1E200JB01D~~ | Murata | C426116 | GJM0335C1E200GB01D | 20pF | 4 | 20 | 200 | 400 | 50 | 250 | 450 | LCSC (https://lcsc.com/product-detail/Multilayer-Ceramic-Capacitors-MLCC-SMD-SMT_Murata-Electronics-GJM0335C1E200GB01D_C426116.html) | $0.0193 | $0.9650 | $0.0193 | $4.8250 | $0.0163 | $7.3350
8 |  | CAP CER 0.022UF 100V X7R 0603 | C20 | Cap 0603 | ~~CGA3E2X7R2A223K080AA~~ | TDK | C313105 | CC0603KRX7R0BB223 | 22nF | 1 | 5 | 50 | 100 | 50 | 100 | 150 | LCSC (https://lcsc.com/product-detail/Multilayer-Ceramic-Capacitors-MLCC-SMD-SMT_YAGEO-CC0603KRX7R0BB223_C313105.html) | $0.0103 | $0.5150 | $0.0103 | $1.0300 | $0.0103 | $1.5450
9 |  | CAP TANT 4.7UF 10% 35V 1411 | C23 | Cap 1411 | TAJB475K035RNJ | Kyocera AVX | C7206 | -------- | 4.7UF | 1 | 5 | 50 | 100 | 7 | 60 | 110 | LCSC (https://lcsc.com/product-detail/Tantalum-Capacitors_AVX-TAJB475K035RNJ_C7206.html) | $0.2453 | $1.7171 | $0.1695 | $10.1700 | $0.1433 | $15.7630
10 |  | CAP ALUM 100UF 20% 25V SMD | C26 | Custom | ~~UWX1E101MCL1GB~~ | Nichicon | C134725 | VE-101M1ETR-0806 | 100uF | 1 | 5 | 50 | 100 | 20 | 150 | 300 | LCSC (https://lcsc.com/product-detail/Aluminum-Electrolytic-Capacitors-SMD_Lelon-VE-101M1ETR-0806_C134725.html) | $0.1245 | $2.4900 | $0.0879 | $13.1850 | $0.1033 | $30.9900 | footprint is slightly different
11 |  | CAP CER 1UF 25V X5R 0402 | C28, C32 | Cap 0402 | GRM155R61E105KA12D | Murata | C77009 | -------- | 1uF | 2 | 10 | 100 | 200 | 50 | 150 | 250 | LCSC (https://lcsc.com/product-detail/Multilayer-Ceramic-Capacitors-MLCC-SMD-SMT_Murata-Electronics-GRM155R61E105KA12D_C77009.html) | $0.0076 | $0.3800 | $0.0076 | $1.1400 | $0.0076 | $1.9000
12 |  | CAP CER 4.7UF 25V X5R 0603 | C31, C34 | Cap 0603 | CL10A475KA8NQNC | Samsung | C69335 | -------- | 4.7uF | 2 | 10 | 100 | 200 | 20 | 120 | 220 | LCSC (https://lcsc.com/product-detail/Multilayer-Ceramic-Capacitors-MLCC-SMD-SMT_Samsung-Electro-Mechanics-CL10A475KA8NQNC_C69335.html) | $0.0212 | $0.4240 | $0.0212 | $2.5440 | $0.0174 | $3.8280
13 |  | CAP CER 2.2UF 16V X5R 0402 | C33, CR1 | Cap 0402 | EMK105ABJ225KV-F | Taiyo Yuden | C385887 | -------- | 2.2uF | 2 | 10 | 100 | 200 | 50 | 150 | 250 | LCSC (https://lcsc.com/product-detail/Multilayer-Ceramic-Capacitors-MLCC-SMD-SMT_Taiyo-Yuden-EMK105ABJ225KV-F_C385887.html) | $0.0099 | $0.4950 | $0.0099 | $1.4850 | $0.0099 | $2.4750
14 |  | CAP TANT 0.33 uF 20 V ±20% 0402 | C50 | Cap 0402 | TCTU1D334M8R | Rohm | C209647 | -------- | 330nF | 1 | 5 | 50 | 100 | 7 | 60 | 110 | LCSC (https://lcsc.com/product-detail/Tantalum-Capacitors_ROHM-Semicon-TCTU1D334M8R_C209647.html) | $0.1906 | $1.3342 | $0.1366 | $8.1960 | $0.1178 | $12.9580
15 |  | CAP CER 220PF 50V C0G/NPO 0402 | CF1 | Cap 0402 | CC0402JRNPO9BN221 | Yageo | C107001 | -------- | 220pF | 1 | 5 | 50 | 100 | 100 | 100 | 200 | LCSC (https://lcsc.com/product-detail/Multilayer-Ceramic-Capacitors-MLCC-SMD-SMT_YAGEO-CC0402JRNPO9BN221_C107001.html) | $0.0039 | $0.3900 | $0.0039 | $0.3900 | $0.0039 | $0.7800
 | Diode | DIODE SCHOTTKY 30V 2A PMDU | D2 | SOD123F | RB060M-30TR | Rohm Semiconductor | C559324 | -------- | ---- | 1 | 5 | 50 | 100 | 7 | 55 | 105 | LCSC (https://lcsc.com/product-detail/Schottky-Barrier-Diodes-SBD_ROHM-Semicon-RB060M-30TR_C559324.html) | $0.1951 | $1.3657 | $0.1401 | $7.7055 | $0.1784 | $18.7320
16 |  | DIODE SCHOTTKY 30V 1A SOD123W | D1, D3 | SOD123W | ~~PMEG3010ER,115~~ | Nexperia | C146292 | CRS01(TE85L,Q,M) | ---- | 2 | 10 | 100 | 200 | 20 | 170 | 320 | LCSC (https://lcsc.com/product-detail/Schottky-Barrier-Diodes-SBD_TOSHIBA-CRS01-TE85L-Q-M_C146292.html) | $0.1712 | $3.4240 | $0.1290 | $21.9300 | $0.1290 | $41.2800 | footprint is different
17 | LED | Red 625nm 0402 Light Emitting Diodes (LED) RoHS | LED1, LED2 | LED 0402 | TJ-S1005SW4TGLC2R-A5 | TOGIALED | C273598 | -------- | ---- | 2 | 10 | 100 | 200 | 20 | 110 | 210 | LCSC (https://lcsc.com/product-detail/Light-Emitting-Diodes-LED_TOGIALED-TJ-S1005SW4TGLC2R-A5_C273598.html) | $0.0498 | $0.9960 | $0.0412 | $4.5320 | $0.0412 | $8.6520
18 | Mosfet | 20V 1.6A 500mW 115mΩ@4.5V,1.6A 1.5V@250μA P Channel SOT-23 MOSFETs ROHS | Q1 | SOT23-3 | FDN338P | UMW | C347511 | -------- | ---- | 1 | 5 | 50 | 100 | 10 | 60 | 110 | LCSC (https://lcsc.com/product-detail/MOSFETs_UMW-Youtai-Semiconductor-Co-Ltd-FDN338P_C347511.html) | $0.0564 | $0.5640 | $0.0564 | $3.3840 | $0.0458 | $5.0380
19 |  | MOSFET P-CH 20V 2.8A SOT-23 | Q2 | SOT23-3 | PMV65XP,215 | Nexperia | C75561 | -------- | ---- | 1 | 5 | 50 | 100 | 7 | 60 | 110 | LCSC (https://lcsc.com/product-detail/MOSFETs_Nexperia-PMV65XP-215_C75561.html) | $0.1870 | $1.3090 | $0.1306 | $7.8360 | $0.1109 | $12.1990
20 |  | MOSFET N-CH 100V .1A SOT23-3 | Q3 | SOT23-3 | ZVN3310FTA | Diodes Zetex | C110533 | -------- | ---- | 1 | 5 | 50 | 100 | 7 | 60 | 110 | LCSC (https://lcsc.com/product-detail/MOSFETs_Diodes-Incorporated-ZVN3310FTA_C110533.html) | $0.2015 | $1.4105 | $0.1373 | $8.2380 | $0.1150 | $12.6500
21 |  | SOT-23 MOSFETs ROHS | Q4 | SOT23-3 | FDN335N | UMW | C347512 | -------- | ---- | 1 | 5 | 50 | 100 | 10 | 60 | 110 | LCSC (https://lcsc.com/product-detail/MOSFETs_UMW-Youtai-Semiconductor-Co-Ltd-FDN335N_C347512.html) | $0.0555 | $0.5550 | $0.0555 | $3.3300 | $0.0451 | $4.9610
22 |  | TRANS PNP 60V 3A SOT223 | QF1 | SOT223 | NZT660A | ON Semiconductor / Fairchild | -------- | -------- | ---- | 1 | 5 | 50 | 100 | 7 | 60 | 110 | Utsource (https://www.utsource.net/itm/p/11294386.html) | $0.6950 | $4.8651 | $0.6950 | $41.7012 | $0.5560 | $61.1611
23 | Switch | SPDT 5A 120V On-On DIP Toggle Switches RoHS | S1 | Custom | SS-12D11L5 | XKB Enterprise | C319010 | -------- | ---- | 1 | 5 | 50 | 100 | 7 | 60 | 110 | LCSC (https://lcsc.com/product-detail/Slide-Switches_XKB-Connectivity-SS-12D11L5_C319010.html) | $0.3778 | $2.6446 | $0.2558 | $15.3480 | $0.2093 | $23.0230
24 |  | SWITCH TACTILE SPST-NO 0.05A 12V | SW1 | Custom | B3U-1000P | Omron | C231329 | -------- | ---- | 1 | 5 | 50 | 100 | 7 | 60 | 110 | LCSC (https://lcsc.com/product-detail/Tactile-Switches_Omron-Electronics-B3U-1000P_C231329.html) | $0.8223 | $5.7561 | $0.5951 | $35.7060 | $0.5176 | $56.9360
25 | Inductor | 10uH ±20% 1.6A 230mΩ SMD,4.75x4.2x2mm Inductors (SMD) RoHS | LZ1 | Custom | MS0420-100M | COILMX | C380158 | -------- | ---- | 1 | 5 | 50 | 100 | 7 | 55 | 110 | LCSC (https://lcsc.com/product-detail/Power-Inductors_COILMX-MS0420-100M_C380158.html) | $0.3391 | $2.3737 | $0.2395 | $13.1725 | $0.2050 | $22.5500
26 | Crystal | CRYSTAL 32.7680KHZ 12.5PF SMD | X1, X2 | Custom | NX3215SA-32.768K-STD-MUA-8 | NDK | -------- | -------- | ---- | 2 | 10 | 100 | 200 | 55 | 130 | 250 | winsource (https://www.win-source.net/crystals-nx3215sa-32.768k-std-mua-8.html) | $0.9290 | $51.0950 | $0.7740 | $100.6200 | $0.7520 | $188.0000
27 | Resistor | 470 ±5% 1/16W ±100ppm/°C 0402 Chip Resistor - Surface Mount RoHS | R1 | Res0402 | RTT02471JTH | RALEC | C103058 | -------- | 470R | 1 | 5 | 50 | 100 | 100 | 100 | 200 | LCSC (https://lcsc.com/product-detail/Chip-Resistor-Surface-Mount_RALEC-RTT02471JTH_C103058.html) | $0.0007 | $0.0700 | $0.0007 | $0.0700 | $0.0007 | $0.1400
28 |  | RES SMD 1.5K OHM 1% 1/20W 0201 | R2 | Res-0201 | ~~RMCF0201FT1K50~~ | Stackpole Electronics | C100153 | CR0201JH0152G | 1.5K | 1 | 5 | 50 | 100 | 100 | 100 | 200 | LCSC (https://lcsc.com/product-detail/Chip-Resistor-Surface-Mount_LIZ-Elec-CR0201JH0152G_C100153.html) | $0.0010 | $0.1000 | $0.0010 | $0.1000 | $0.0010 | $0.2000
29 |  | RES SMD 20K OHM 5% 1/16W 0402 | R3, R4, R8, R9, R10, R20, RP2 | Res0402 | RC0402JR-0720KL | Yageo | C137902 | -------- | 20K | 7 | 35 | 350 | 700 | 100 | 400 | 800 | LCSC (https://lcsc.com/product-detail/Chip-Resistor-Surface-Mount_YAGEO-RC0402JR-0720KL_C137902.html) | $0.0023 | $0.2300 | $0.0023 | $0.9200 | $0.0023 | $1.8400
30 |  | RES SMD 2K OHM 1% 1/16W 0402 | R5 | Res0402 | RC0402FR-072KL | Yageo | C60488 | -------- | 2K | 1 | 5 | 50 | 100 | 100 | 100 | 200 | LCSC (https://lcsc.com/product-detail/Chip-Resistor-Surface-Mount_YAGEO-RC0402FR-072KL_C60488.html) | $0.0008 | $0.0800 | $0.0008 | $0.0800 | $0.0008 | $0.1600
31 |  | RES SMD 80.6K OHM 1% 1/16W 0402 | R6 | Res0402 | AC0402FR-0780K6L | Yageo | C227238 | -------- | 80.6K | 1 | 5 | 50 | 100 | 100 | 100 | 200 | LCSC (https://lcsc.com/product-detail/Chip-Resistor-Surface-Mount_YAGEO-AC0402FR-0780K6L_C227238.html) | $0.0011 | $0.1100 | $0.0011 | $0.1100 | $0.0011 | $0.2200
32 |  | RES SMD 30.9K OHM 1% 1/16W 0402 | R7 | Res0402 | AC0402FR-0730K9L | Yageo | C226983 | -------- | 30.9K | 1 | 5 | 50 | 100 | 100 | 100 | 200 | LCSC (https://lcsc.com/product-detail/Chip-Resistor-Surface-Mount_YAGEO-AC0402FR-0730K9L_C226983.html) | $0.0013 | $0.1300 | $0.0013 | $0.1300 | $0.0013 | $0.2600
33 |  | RES 10K OHM 5% 1/10W 0402 | R11, R12, R15, R16, R17 | Res0402 | RK73B1ETTP103J | KOA Speer | C140214 | RC-02W103JT | 10K | 5 | 25 | 250 | 500 | 100 | 300 | 600 | LCSC (https://lcsc.com/product-detail/Chip-Resistor-Surface-Mount_FH-Guangdong-Fenghua-Advanced-Tech-RC-02W103JT_C140214.html) | $0.0005 | $0.0500 | $0.0005 | $0.1500 | $0.0005 | $0.3000
34 |  | RES SMD 133K OHM 1% 1/16W 0402 | R13 | Res0402 | RC0402FR-07133KL | Yageo | C327374 | -------- | 133K | 1 | 5 | 50 | 100 | 100 | 100 | 200 | LCSC (https://lcsc.com/product-detail/Chip-Resistor-Surface-Mount_YAGEO-RC0402FR-07133KL_C327374.html) | $0.0009 | $0.0900 | $0.0009 | $0.0900 | $0.0009 | $0.1800
35 |  | RES 49.9K OHM 1% 1/10W 0402 | R14 | Res0402 | ~~RK73H1ETTP4992F~~ | KOA Speer | C2692736 | PTFR0402B49K9P9 | 49.9K | 1 | 5 | 50 | 100 | 10 | 60 | 110 | LCSC (https://lcsc.com/product-detail/Chip-Resistor-Surface-Mount_Resistor-Today-PTFR0402B49K9P9_C2692736.html) | $0.0560 | $0.5600 | $0.0560 | $3.3600 | $0.0463 | $5.0930
36 |  | RES SMD 0 OHM JUMPER 1/16W 0402 | R18, R19, RF22, RF23 | Res0402 | RC0402JR-070RL | Yageo | C60485 | -------- | 0R | 4 | 20 | 200 | 400 | 100 | 300 | 500 | LCSC (https://lcsc.com/product-detail/Chip-Resistor-Surface-Mount_YAGEO-RC0402JR-070RL_C60485.html) | $0.0007 | $0.0700 | $0.0007 | $0.2100 | $0.0007 | $0.3500
37 |  | 4.7K ±5% 1/16W ±200ppm/°C 0402 Chip Resistor - Surface Mount RoHS | R21, R22, R27 | Res0402 | CR0402JF0472G | LIZ Elec | C100658 | -------- | 4.7K | 3 | 15 | 150 | 300 | 100 | 200 | 400 | LCSC (https://lcsc.com/product-detail/Chip-Resistor-Surface-Mount_LIZ-Elec-CR0402JF0472G_C100658.html) | $0.0009 | $0.0900 | $0.0009 | $0.1800 | $0.0009 | $0.3600
38 |  | ±1% 1/10W Thick Film Resistors 75V ±100ppm/℃ -55℃~+155℃ 910kΩ 0603 Chip Resistor - Surface Mount ROHS | R23 | Res0603 | 0603WAF9103T5E | UNI-ROYAL | C23263 | -------- | 910K | 1 | 5 | 50 | 100 | 100 | 100 | 200 | LCSC (https://lcsc.com/product-detail/Chip-Resistor-Surface-Mount_UNI-ROYAL-Uniroyal-Elec-0603WAF9103T5E_C23263.html) | $0.0017 | $0.1700 | $0.0017 | $0.1700 | $0.0017 | $0.3400
39 |  | RES SMD 47K OHM 1% 1/16W 0402 | R24, R25, RZ1 | Res0402 | RC0402FR-0747KL | Yageo | C93943 | -------- | 47K | 3 | 15 | 150 | 300 | 100 | 200 | 400 | LCSC (https://lcsc.com/product-detail/Chip-Resistor-Surface-Mount_YAGEO-RC0402FR-0747KL_C93943.html) | $0.0032 | $0.3200 | $0.0032 | $0.6400 | $0.0032 | $1.2800
40 |  | RES SMD 1K OHM 5% 1/10W 0402 | R26, RF2 | Res0402 | ~~ERJ-2GEJ102X~~ | Panasonic | C2759467 | HP02WAJ0102TCE | 1K | 2 | 10 | 100 | 200 | 100 | 200 | 300 | LCSC (https://lcsc.com/product-detail/Chip-Resistor-Surface-Mount_UNI-ROYAL-Uniroyal-Elec-HP02WAJ0102TCE_C2759467.html) | $0.0044 | $0.4400 | $0.0044 | $0.8800 | $0.0044 | $1.3200
41 |  | 0.068 ±1% 1/4W ±800ppm/°C 0805 Chip Resistor - Surface Mount RoHS | RF1 | RES 0805 | ~~0805W4F680MT5E~~ | UNI-ROYAL(Uniroyal Elec) | C270861 | CS05W4F680MT5E | 0.068R | 1 | 5 | 50 | 100 | 20 | 60 | 120 | LCSC (https://lcsc.com/product-detail/Current-Sense-Resistors-Shunt-Resistors_UNI-ROYAL-Uniroyal-Elec-CS05W4F680MT5E_C270861.html) | $0.0281 | $0.5620 | $0.0281 | $1.6860 | $0.0232 | $2.7840 | Temp coefficient is change
42 |  | RES SMD 1M OHM 1% 1/16W 0402 | RF3, RF4 | Res0402 | RC0402FR-071ML | Yageo | C138033 | -------- | 1M | 2 | 10 | 100 | 200 | 100 | 200 | 300 | LCSC (https://lcsc.com/product-detail/Chip-Resistor-Surface-Mount_YAGEO-RC0402FR-071ML_C138033.html) | $0.0008 | $0.0800 | $0.0008 | $0.1600 | $0.0008 | $0.2400
43 |  | RES SMD 118K OHM 1% 1/16W 0402 | RF5 | Res0402 | AC0402FR-07118KL | Yageo | C144804 | -------- | 118K | 1 | 5 | 50 | 100 | 100 | 100 | 200 | LCSC (https://lcsc.com/product-detail/Chip-Resistor-Surface-Mount_YAGEO-AC0402FR-07118KL_C144804.html) | $0.0012 | $0.1200 | $0.0012 | $0.1200 | $0.0012 | $0.2400
44 |  | RES SMD 13.3K OHM 1% 1/16W 0402 | RF6 | Res0402 | RC0402FR-0713K3L | Yageo | C274352 | -------- | 13.3K | 1 | 5 | 50 | 100 | 100 | 100 | 200 | LCSC (https://lcsc.com/product-detail/Chip-Resistor-Surface-Mount_YAGEO-RC0402FR-0713K3L_C274352.html) | $0.0009 | $0.0900 | $0.0009 | $0.0900 | $0.0009 | $0.1800
45 |  | RES SMD 60.4K OHM 1% 1/16W 0402 | RP1 | Res0402 | RC0402FR-0760K4L | Yageo | C327333 | -------- | 60.4K | 1 | 5 | 50 | 100 | 100 | 100 | 200 | LCSC (https://lcsc.com/product-detail/Chip-Resistor-Surface-Mount_YAGEO-RC0402FR-0760K4L_C327333.html) | $0.0009 | $0.0900 | $0.0009 | $0.0900 | $0.0009 | $0.1800
46 |  | RES SMD 62K OHM 1% 1/16W 0402 | RP3 | Res0402 | AC0402FR-0762KL | Yageo | C144742 | -------- | 62K | 1 | 5 | 50 | 100 | 100 | 100 | 200 | LCSC (https://lcsc.com/product-detail/Chip-Resistor-Surface-Mount_YAGEO-AC0402FR-0762KL_C144742.html) | $0.0012 | $0.1200 | $0.0012 | $0.1200 | $0.0012 | $0.2400
47 |  | 40.2K ±1% 1/16W ±100ppm/°C 0402 Chip Resistor - Surface Mount RoHS | RP4 | Res0402 | RTT024022FTH | RALEC | C103027 | -------- | 40.2K | 1 | 5 | 50 | 100 | 100 | 100 | 200 | LCSC (https://lcsc.com/product-detail/Chip-Resistor-Surface-Mount_RALEC-RTT024022FTH_C103027.html) | $0.0011 | $0.1100 | $0.0011 | $0.1100 | $0.0011 | $0.2200
48 | ICs | IC REG LDO 3.3V 1A SOT223 | U1 | SOT223 | SPX3940AM3-L-3-3/TR | Exar | C48252 | -------- | ---- | 1 | 5 | 50 | 100 | 7 | 53 | 105 | LCSC (https://lcsc.com/product-detail/Linear-Voltage-Regulators-LDO_MaxLinear-SPX3940AM3-L-3-3-TR_C48252.html) | $0.6005 | $4.2035 | $0.4076 | $21.6028 | $0.3391 | $35.6055
49 |  | TVS DIODE 5V 6.8V 6UDFN | U2 | 6UDFN | SP3014-02UTG | Littelfuse |  | -------- | ---- | 1 | 5 | 50 | 100 | 135 | 135 | 135 | winsource (https://www.win-source.net/littelfuse-inc.-sp3014-02utg.html) | $0.3800 | $51.3000 | $0.3800 | $51.3000 | $0.3800 | $51.3000 | in stock=1 at LCSC
50 |  | IC VREF SHUNT 18V 0.5% SOT23 | U3 | SOT23-3 | TLV431BFTA | Diodes Zetex |  | -------- | ---- | 1 | 5 | 50 | 100 | 10 | 55 | 120 | Aliexpress (https://pt.aliexpress.com/item/1005002675489873.html?pdp_pi=-) | $0.7900 | $7.9000 | $0.7900 | $43.4500 | $0.7900 | $94.8000
51 |  | IC COMPARATOR LP DUAL 8-SOIC | U4 | 8-SOIC | LM393DT | STMicroelectronics | C32901 | -------- | ---- | 1 | 5 | 50 | 100 | 10 | 53 | 105 | LCSC (https://lcsc.com/product-detail/Comparators_STMicroelectronics-LM393DT_C32901.html) | $0.1265 | $1.2650 | $0.1076 | $5.7028 | $0.1076 | $11.2980
52 |  | IC MCU 32BIT 256KB FLASH 48TQFP | U5 | 48TQFP | SAMD21G18A-AUT | Microchip |  | -------- | ---- | 1 | 5 | 50 | 100 |  |  |  |  |  | $0.0000 |  | $0.0000 |  | $0.0000 | Part not Available
53 |  | IC AMP CLASS AB MONO 1W 8SOIC | U6 | SOIC-8 | LM4890MX/NOPB | Texas Instruments | C117476 | -------- | ---- | 1 | 5 | 50 | 100 | 7 | 53 | 105 | LCSC (https://lcsc.com/product-detail/Audio-Power-OpAmps_Texas-Instruments-LM4890MX-NOPB_C117476.html) | $1.5292 | $10.7044 | $1.0514 | $55.7242 | $0.8855 | $92.9775
54 |  | IC MOTOR DRIVER DC 5.5V 16HTSSOP | U7 | 16HTSSOP | DRV8876PWPR | Texas Instruments |  | -------- | ---- | 1 | 5 | 50 | 100 | 10 | 60 | 120 | Aliexpress (https://pt.aliexpress.com/item/1005002673440755.html?pdp_pi=-) | $1.1500 | $11.5000 | $1.1500 | $69.0000 | $1.1500 | $138.0000
55 |  | IC RTC CLK/CALENDAR I2C 8-SOIC | U8 | SOIC-8 | MCP7940N-I/SN | Microchip | C51106 | -------- | ---- | 1 | 5 | 50 | 100 | 7 | 53 | 105 | LCSC (https://lcsc.com/product-detail/Real-time-Clocks-RTC_Microchip-Tech-MCP7940N-I-SN_C51106.html) | $10.4212 | $72.9484 | $9.5141 | $504.2473 | $9.3302 | $979.6710
56 |  | IC LI-ION LDO CHARGE MGMT 8SOIC | UF1 | SOIC-8 | BQ2057WSNTR | Texas Instruments | C32756 | -------- | ---- | 1 | 5 | 50 | 100 | 7 | 53 | 105 | LCSC (https://lcsc.com/product-detail/Battery-Management-ICs_Texas-Instruments-BQ2057WSNTR_C32756.html) | $3.9348 | $27.5436 | $2.6887 | $142.5011 | $2.2559 | $236.8695
57 |  | IC REG BOOST ADJ 2A SOT23-5 | UF2 | SOT23-5 | LMR62014XMF/NOPB | TI National Semiconductor | C55182 | -------- | ---- | 1 | 5 | 50 | 100 | 7 | 53 | 105 | LCSC (https://lcsc.com/product-detail/DC-DC-Converters_Texas-Instruments-LMR62014XMF-NOPB_C55182.html) | $0.8422 | $5.8954 | $0.5753 | $30.4909 | $0.4833 | $50.7465
58 | Connector | FPC Connector 0.5mm pitch 24pin 30pin TOP&bottom conduction Zif Smt Lcd/epaper Fpc Ffc Connector | J1 | Custom | 8.02A0.024200 | Custom |  | -------- | ---- | 1 | 5 | 50 | 100 | 10 | 60 | 120 | Alibaba (https://www.alibaba.com/product-detail/FPC-Connector-0-5mm-pitch-24pin_1600228276659.html) | $0.1500 | $1.5000 | $0.1500 | $9.0000 | $0.1500 | $18.0000
59 |  | DC Power Receptacle Jack 2.5A 2.5mm 6.5mm SMD Power Connectors RoHS | J2 | Custom | DC-005-5A-2.5-SMT | XKB Enterprise | C319133 | -------- | ---- | 1 | 5 | 50 | 100 | 7 | 53 | 105 | LCSC (https://lcsc.com/product-detail/AC-DC-Power-Connectors_XKB-Connectivity-DC-005-5A-2-5-SMT_C319133.html) | $0.2235 | $1.5645 | $0.1488 | $7.8864 | $0.1206 | $12.6630
60 |  | USB - Micro B Female USB 2 5 SMD USB Connectors RoHS | J3 | Custom | 920-E52A2021S10100 | Jing Extension of the Electronic | C10418 | -------- | ---- | 1 | 5 | 50 | 100 | 10 | 55 | 105 | LCSC (https://lcsc.com/product-detail/USB-Connectors_Jing-Extension-of-the-Electronic-Co-920-E52A2021S10100_C10418.html) | $0.0780 | $0.7800 | $0.0658 | $3.6190 | $0.0658 | $6.9090
61 |  | CONN HEADER SMD 10POS 1.27MM | J4 | Custom | 20021121-00010C4LF | Amphenol FCI | C150517 | -------- | ---- | 1 | 5 | 50 | 100 | 7 | 53 | 105 | LCSC (https://lcsc.com/product-detail/Pin-Headers_Amphenol-ICC-20021121-00010C4LF_C150517.html) | $0.9053 | $6.3371 | $0.6438 | $34.1214 | $0.4319 | $45.3495
62 |  | SMD Battery Holders, Clips & Contacts RoHS | J6 | Custom | CR1220-2 | Q&J | C70381 | -------- | ---- | 1 | 5 | 50 | 100 | 7 | 53 | 105 | LCSC (https://lcsc.com/product-detail/Battery-Connectors_Q-J-CR1220-2_C70381.html) | $0.3562 | $2.4934 | $0.2766 | $14.6598 | $0.2490 | $26.1450
63 |  | P=5.0mm Screw terminal RoHS | J7 | Custom | WJ301V-5.0-3P | Ningbo Kangnex Elec | C8483 | -------- | ---- | 1 | 5 | 50 | 100 | 10 | 55 | 105 | LCSC (https://lcsc.com/product-detail/Screw-terminal_Ningbo-Kangnex-Elec-WJ301V-5-0-3P_C8483.html) | $0.1358 | $1.3580 | $0.1106 | $6.0830 | $0.1106 | $11.6130
64 |  | P=5.0mm Screw terminal RoHS | J8, J#1 | Custom | WJ301V-5.0-2P | Ningbo Kangnex Elec | C8475 | -------- | ---- | 2 | 10 | 100 | 200 | 10 | 105 | 205 | LCSC (https://lcsc.com/product-detail/Screw-terminal_Ningbo-Kangnex-Elec-WJ301V-5-0-2P_C8475.html) | $0.0906 | $0.9060 | $0.0738 | $7.7490 | $0.0738 | $15.1290
65 |  | 2 PIN JST Connector | P17 | Custom | 2 Pin JST Connector | BOOMELE | C66603 | EH-2A | ---- | 1 | 5 | 50 | 100 | 50 | 100 | 150 | LCSC (https://lcsc.com/product-detail/Wire-To-Board-Wire-To-Wire-Connector_BOOMELE-Boom-Precision-Elec-EH-2A_C66603.html) | $0.0111 | $0.5550 | $0.0111 | $1.1100 | $0.0111 | $1.6650
66 |  | ~~CBL PLUG-OF-NAILS 10-PIN W/LEGS~~ | ~~J5~~ | ~~Custom~~ | ~~TC2050-IDC~~ | ~~Tag-Connect~~ | ~~-------------~~ | ~~-------------~~ | ~~----~~ | ~~1~~ | ~~5~~ | ~~50~~ | ~~100~~ |  |  |  | ~~-------------~~ |  | ~~-------------~~ |  | ~~-------------~~ |  | ~~-------------~~ | ~~DO NOT Mount~~
67 |  | ~~Wire Connecting Pad~~ | ~~P1~~ | ~~Custom~~ | ~~SMD PAD~~ | ~~-------------~~ | ~~-------------~~ | ~~-------------~~ | ~~----~~ | ~~1~~ | ~~5~~ | ~~50~~ | ~~100~~ |  |  |  | ~~-------------~~ |  | ~~-------------~~ |  | ~~-------------~~ |  | ~~-------------~~ | ~~DO NOT Mount~~
68 |  | ~~Solder Bridge ON~~ | ~~SB2, SB3, SB14, SB15, SB16, SB17, SB18, SB19, SB20,SB21, SB_ZD1~~ | ~~Custom~~ | ~~Solder Bridge~~ | ~~-------------~~ | ~~-------------~~ | ~~-------------~~ | ~~----~~ | ~~11~~ | ~~55~~ | ~~550~~ | ~~1100~~ |  |  |  | ~~-------------~~ |  | ~~-------------~~ |  | ~~-------------~~ |  | ~~-------------~~ | ~~DO NOT Mount~~
69 |  | ~~Test Point ON~~ | ~~P2, P12, P13, P14, P15, P16~~ | ~~Custom~~ | ~~TEST POINT~~ | ~~-------------~~ | ~~-------------~~ | ~~-------------~~ | ~~----~~ | ~~6~~ | ~~30~~ | ~~300~~ | ~~600~~ |  |  |  | ~~-------------~~ |  | ~~-------------~~ |  | ~~-------------~~ |  | ~~-------------~~ | ~~DO NOT Mount~~
70 | Peripheral | LS-SG555 37MM Dc Gear Motor | ------- | Custom | LS-SG555 | Ningbo Leison Motor | ------- | ------- | --- | 1 | 5 | 50 | 100 | ----- | ----- | ----- | Custom Supplier (https://www.nbleisonmotor.com/LS-SG555-37MM-Dc-Gear-Motor-pd6046204.html) | $14.0000 | $70.0000 | $14.0000 | $700.0000 | $14.0000 | $1400.0000 | Delivery time: 15 days after got the payment
 |  |  |  |  |  |  |  |  |  | Total Component Cost |  |  |  |  |  |  |  |  | $376.2753 |  | $2073.4159 |  | $3864.8466
 |  |  |  |  |  |  |  |  |  | Single Board Cost |  |  |  |  |  |  |  |  | $75.2551 |  | $41.4683 |  | $38.6485
 |  |  |  |  |  |  |  |  |  | Motor Shipping Cost |  |  |  |  |  |  |  | Pakistan | $88.0000 |  | $88.0000 |  | $88.0000
 |  |  |  |  |  |  |  |  |  |  |  |  |  |  |  |  |  | Total Cost | $163.2551 |  | $129.4683 |  | $126.6485
