eSpark-Backup/grantkros-coopmonitor/Deliverable/Main_Board/BOM/(5 Board)Digikey_Main_Board-BOM.xlsx

Bill of Material (BOM) for Grant Main Board
S. No. | Components | Description | Designator | Footprint (Package) | Manufacturer Part Number | Manufacturer | Alternate | Value | Quantity (Per Board) | Quantity 5 | Link | Unit Cost(5) | Total Cost(5) | Remarks
1 | Capacitor | CAP ALUM 6.8UF 20% 25V SMD | C1 | Custom | EEEHB1E6R8R | Panasonic | -------- | 6.8uF | 1 | 5 | Digikey (https://www.digikey.com/en/products/detail/panasonic-electronic-components/EEE-HB1E6R8R/817513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) | $0.43 | $2.1500
2 |  | CAP ALUM 10uF 25V SMD | C2 | Custom | ~~RVT1E100M0405~~ | ROQANG | 25SEV10M4X5.5 | 10uF | 1 | 5 | Digikey (https://www.digikey.com/en/products/detail/rubycon/25SEV10M4X5-5/3568461) | $0.47 | $2.3500
3 |  | CAP CER 0.1UF 50V X7R 0402 | C11, C12, C13, C14, C15, C18, C21, C22, C24, C25, C27, C29, C30, CF2 | Cap 0402 | C1005X7R1H104K050BB | TDK Corporation | -------- | 0.1uF | 14 | 70 | Digikey (https://www.digikey.com/en/products/detail/yageo/CC0402KRX7R7BB104/2103076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) | $0.02 | $1.1060
4 |  | CAP CER 22UF 25V X5R 0805 | C7, CE1 | Cap0805 | GRM21BR61E226ME44L | Murata | -------- | 22uF | 2 | 10 | Digikey (https://www.digikey.com/en/products/detail/murata-electronics/GRM21BR61E226ME44L/4905535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) | $0.3020 | $3.0200
5 |  | 1uF 10V ±20% 0805 Tantalum Capacitors ROHS | C8, C19 | Custom | TCP1A105M8R | ROHM | -------- | 1UF | 2 | 10 | Digikey (https://www.digikey.com/en/products/detail/rohm-semiconductor/TCP1A105M8R/923650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) | $0.3780 | $3.7800
6 |  | CAP CER 25PF 50V C0G/NPO 0603 | C9 | Cap 0603 | CC0603JRNPO9BN250 | YAGEO | -------- | 25pF | 1 | 5 | Digikey (https://www.digikey.com/en/products/detail/yageo/CC0603JRNPO9BN250/5883609) | $0.1100 | $0.5500
7 |  | CAP CER 20PF 25V C0H 0201 | C16, C17, CX1, CX2 | Cap 0201 | ~~GJM0336C1E200JB01D~~ | Murata | CC0201JRNPO8BN200 | 20pF | 4 | 20 | Digikey (https://www.digikey.com/en/products/detail/yageo/CC0201JRNPO8BN200/5883132) | $0.0260 | $0.5200
8 |  | CAP CER 0.022UF 100V X7R 0603 | C20 | Cap 0603 | CGA3E2X7R2A223K080AA | TDK | -------- | 22nF | 1 | 5 | Digikey (https://www.digikey.com/en/products/detail/tdk-corporation/CGA3E2X7R2A223K080AA/2443292) | $0.1100 | $0.5500
9 |  | CAP TANT 4.7UF 10% 35V 1411 | C23 | B Case | TAJB475K035RNJ | Kyocera AVX | -------- | 4.7UF | 1 | 5 | Mouser (https://eu.mouser.com/ProductDetail/Kyocera-AVX/TAJB475K035RNJ?qs=mgX5NEyWO4TjTiyDuj3Okg%3D%3D) | $0.4400 | $2.2000
10 |  | CAP ALUM 100UF 20% 25V SMD | C26 | Custom | UWX1E101MCL1GB | Nichicon | -------- | 100uF | 1 | 5 | Arrow (https://www.arrow.com/en/products/uwx1e101mcl1gb/nichicon) | $0.64 | $3.2055
11 |  | CAP CER 4.7UF 25V X5R 0603 | C31 | Cap 0603 | CL10A475KA8NQNC | Samsung | -------- | 4.7uF | 1 | 5 | Digikey (https://www.digikey.com/en/products/detail/samsung-electro-mechanics/CL10A475KA8NQNC/3887558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) | $0.2590 | $1.2950
12 |  | CAP CER 2.2UF 16V X5R 0402 | CR1 | Cap 0402 | EMK105ABJ225KV-F | Taiyo Yuden | -------- | 2.2uF | 1 | 5 | Digikey (https://www.digikey.com/en/products/detail/taiyo-yuden/EMK105ABJ225KV-F/7403764) | $0.1560 | $0.7800
13 |  | CAP TANT 0.33 uF 20 V ±20% 0402 | C50 | Cap 0402 | TCTU1D334M8R | Rohm | -------- | 330nF | 1 | 5 | Digikey (https://www.digikey.com/en/products/detail/rohm-semiconductor/TCTU1D334M8R/4340359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) | $0.5200 | $2.6000
14 |  | CAP CER 220PF 50V C0G/NPO 0402 | CF1 | Cap 0402 | CC0402JRNPO9BN221 | Yageo | ------- | 220pF | 1 | 5 | Digikey (https://www.digikey.com/en/products/detail/yageo/CC0402JRNPO9BN221/2833581) | $0.1000 | $0.5000
15 | Diode | DIODE SCHOTTKY 30V 2A PMDU | D2 | SOD123F | RB060M-30TR | Rohm Semiconductor | ------- | -------- | 1 | 5 | Quest (https://www.questcomp.com/part/rb060m-30tr/rohm-co-ltd/332009458/1620554) | $0.5000 | $2.5000
16 |  | DIODE SCHOTTKY 30V 1A SOD123W | D1, D3 | SOD123W | PMEG3010ER,115 | Nexperia | ------ | --- | 2 | 10 | Mouser (https://eu.mouser.com/ProductDetail/Nexperia/PMEG3010ER115?qs=LMSg3oBIm%2FjofezKw7ztsw%3D%3D) | $0.3220 | $3.2200
17 | LED | Red 625nm 0402 Light Emitting Diodes (LED) RoHS | LED1 | LED 0402 | ~~TJ-S1005SW4TGLC2R-A5~~ | TOGIALED | VLMS1500-GS08 | --- | 1 | 5 | Digikey (https://www.digikey.com/en/products/detail/vishay-semiconductor-opto-division/VLMS1500-GS08/3504681) | $0.3220 | $1.6100
18 | Mosfet | MOSFET P-CH 20V 1.6A SUPERSOT3 | Q1 | SOT23-3 | FDN338P | UMW | -------- | --- | 1 | 5 | Digikey (https://www.digikey.com/en/products/detail/onsemi/FDN338P/458848) | $0.5200 | $2.6000
19 |  | MOSFET N-CH 100V .1A SOT23-3 | Q3 | SOT23-3 | ZVN3310FTA | Diodes Zetex | -------- | --- | 1 | 5 | Digikey (https://www.digikey.com/en/products/detail/diodes-incorporated/ZVN3310FTA/92648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) | $0.6700 | $3.3500
20 |  | SOT-23 MOSFETs ROHS | Q4 | SOT23-3 | FDN335N | UMW | -------- | --- | 1 | 5 | Digikey (https://www.digikey.com/en/products/detail/onsemi/FDN335N/965301?s=N4IgTCBcDaIGIBEByBmFBWJIC6BfIA) | $0.5500 | $2.7500
21 | Switch | SPDT 5A 120V On-On DIP Toggle Switches RoHS | S1 | Custom | SS-12D11L5 | XKB Enterprise | -------- | --- | 1 | 5 | Custom Supplier (https://www.digikey.com/en/products/detail/nkk-switches/MS12ASG30/1058151) | $1.5000 | $7.5000
22 |  | SWITCH TACTILE SPST-NO 0.05A 12V | SW1 | Custom | B3U-1000P | Omron | -------- | --- | 1 | 5 | Digikey (https://www.digikey.com/en/products/detail/omron-electronics-inc-emc-div/B3U-1000P/1534338) | $1.0100 | $5.0500
23 | Inductor | 10uH ±20% 1.6A 230mΩ SMD,4.75x4.2x2mm Inductors (SMD) RoHS | LZ1 | Custom | ~~MS0420-100M~~ | COILMX | BMRA00040420100MA1 | --- | 1 | 5 | Digikey (https://www.digikey.com/en/products/detail/chilisin-electronics/BMRA00040420100MA1/12141016) | $0.6800 | $3.4000
24 | Crystal | CRYSTAL 32.7680KHZ 12.5PF SMD | X1, X2 | Custom | NX3215SA-32.768K-STD-MUA-8 | NDK | -------- | --- | 2 | 10 | Digikey (https://www.digikey.com/en/products/detail/ndk-america-inc/NX3215SA-32-768K-STD-MUA-8/2261469) | $0.6540 | $6.5400
25 | Resistor | RES 470 OHM 5% 1/16W 0402 | R1 | Res0402 | ~~RTT02471JTH~~ | RALEC | RMCF0402JT470R | 470R | 1 | 5 | Digikey (https://www.digikey.com/en/products/detail/stackpole-electronics-inc/RMCF0402JT470R/1712461) | $0.1000 | $0.5000
26 |  | RES SMD 1.5K OHM 1% 1/20W 0201 | R2 | Res-0201 | RMCF0201FT1K50 | Stackpole Electronics | -------- | 1.5K | 1 | 5 | Digikey (https://www.digikey.com/en/products/detail/stackpole-electronics-inc/RMCF0201FT1K50/1761885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) | $0.1000 | $0.5000
27 |  | RES SMD 20K OHM 5% 1/16W 0402 | R3, R4, R9, R10, R20 | Res0402 | RC0402JR-0720KL | Yageo | -------- | 20K | 5 | 25 | Digikey (https://www.digikey.com/en/products/detail/yageo/RC0402JR-0720KL/2827648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) | $0.0130 | $0.3250
28 |  | RES 10K OHM 5% 1/10W 0402 | R6, R8, R11, R12, R15, R16, R17, R33, R34 | Res0402 | ~~RK73B1ETTP103J~~ | KOA Speer | ESR01MZPJ103 | 10K | 9 | 45 | Digikey (https://www.digikey.com/en/products/detail/rohm-semiconductor/ESR01MZPJ103/4053677) | $0.2230 | $10.0350
29 |  | RES SMD 133K OHM 1% 1/16W 0402 | R13 | Res0402 | RC0402FR-07133KL | Yageo | -------- | 133K | 1 | 5 | Mouser (https://eu.mouser.com/ProductDetail/YAGEO/RC0402FR-07133KL?qs=UOUeRUa%252B8WmCOdu%2F2H3z4Q%3D%3D) | $0.1010 | $0.5050
30 |  | RES 49.9K OHM 1% 1/10W 0402 | R14 | Res0402 | ~~RK73H1ETTP4992F~~ | KOA Speer | RMCF0402FT49K9 | 49.9K | 1 | 5 | Digikey (https://www.digikey.com/en/products/detail/stackpole-electronics-inc/RMCF0402FT49K9/1942927) | $0.1000 | $0.5000
31 |  | RES SMD 0 OHM JUMPER 1/16W 0402 | R18, R19, RF22, RF23 | Res0402 | ~~RC0402JR-070RL~~ | Yageo | RC0402FR-070RL | 0R | 4 | 20 | Digikey (https://www.digikey.com/en/products/detail/yageo/RC0402FR-070RL/2827888) | $0.0130 | $0.2600
32 |  | RES SMD 47K OHM 1% 1/16W 0402 | R24, R25, RZ1 | Res0402 | RC0402FR-0747KL | Yageo | -------- | 47K | 3 | 15 | Digikey (https://www.digikey.com/en/products/detail/yageo/RC0402FR-0747KL/726616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) | $0.0160 | $0.2400
33 |  | RES SMD 1K OHM 5% 1/10W 0402 | R26 | Res0402 | ~~ERJ-2GEJ102X~~ | Panasonic | RC0402JR-071KL | 1K | 1 | 5 | Digikey (https://www.digikey.com/en/products/detail/yageo/RC0402JR-071KL/729355) | $0.1000 | $0.5000
34 |  | RES SMD 118K OHM 1% 1/16W 0402 | RF5 | Res0402 | AC0402FR-07118KL | Yageo | -------- | 118K | 1 | 5 | Digikey (https://www.digikey.com/en/products/detail/yageo/AC0402FR-07118KL/5895039) | $0.1000 | $0.5000
35 |  | RES SMD 13.3K OHM 1% 1/16W 0402 | RF6 | Res0402 | RC0402FR-0713K3L | Yageo | -------- | 13.3K | 1 | 5 | Digikey (https://www.digikey.com/en/products/detail/yageo/RC0402FR-0713K3L/5280834) | $0.1000 | $0.5000
36 | IC | IC REG LDO 3.3V 1A SOT223 | U1 | SOT223 | SPX3940AM3-L-3-3/TR | Exar | -------- | --- | 1 | 5 | Digikey (https://www.digikey.com/en/products/detail/maxlinear-inc/SPX3940AM3-L-3-3-TR/2472424) | $1.2000 | $6.0000
37 |  | IC MCU 32BIT 256KB FLASH 48TQFP | U5 | 48TQFP | SAMD21G18A-AUT | Microchip | -------- | --- | 1 | 5 | Digikey (https://www.digikey.com/en/products/detail/ATSAMD21G18A-AUT/ATSAMD21G18A-AUTDKR-ND/4878891?curr=usd) | $4.2300 | $21.1500
38 |  | IC AMP CLASS AB MONO 1W 8SOIC | U6 | SOIC-8 | LM4890MX/NOPB | Texas Instruments | -------- | --- | 1 | 5 | Arrow (https://www.arrow.com/en/products/lm4890mxnopb/texas-instruments?region=nac) | $1.3006 | $6.5030
39 |  | IC MOTOR DRIVER DC 5.5V 16HTSSOP | U7 | 16HTSSOP | DRV8876PWPR | Texas Instruments | -------- | --- | 1 | 5 | Digikey (https://www.digikey.com/en/products/detail/texas-instruments/DRV8876PWPR/10270191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) | $2.4000 | $12.0000
40 |  | IC RTC CLK/CALENDAR I2C 8-SOIC | U8 | 8-SOIC | MCP7940N-I/SN | Microchip | -------- | --- | 1 | 5 | Digikey (https://www.digikey.com/en/products/detail/microchip-technology/MCP7940N-I-SN/2651354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) | $0.8600 | $4.3000
41 |  | IC REG BOOST ADJ 2A SOT23-5 | UF2 | SOT23-5 | ~~LMR62014XMF/NOPB~~ | TI National Semiconductor | LMR62014XMFE/NOPB | --- | 1 | 5 | Digikey (https://www.digikey.com/en/products/detail/texas-instruments/LMR62014XMFE-NOPB/2754196) | $1.1500 | $5.7500
42 | Connector | 2.54mm Straight 1x10P 10 1 Plugin,P=2.54mm Female Headers ROHS | J1 | Custom | ~~C35445~~ | BOOMELE | PPTC051LFBN-RC | --- | 1 | 5 | Digikey (https://www.digikey.com/en/products/detail/sullins-connector-solutions/PPTC051LFBN-RC/807239) | $0.4700 | $2.3500
43 |  | USB - Micro B Female USB 2 5 SMD USB Connectors RoHS | J3 | Custom | ~~C10418~~ | Jing Extension of the Electronic | MCR-B-S-RA-SMT-CS5A-NF-T/R | --- | 1 | 5 | Digikey (https://www.digikey.com/en/products/detail/adam-tech/MCR-B-S-RA-SMT-CS5A-NF-T-R/9832094) | $0.3500 | $1.7500
44 |  | CONN HEADER SMD 10POS 1.27MM | J4 | Custom | 20021121-00010C4LF | Amphenol FCI | -------- | --- | 1 | 5 | Digikey (https://www.digikey.com/en/products/detail/amphenol-icc-fci/20021121-00010C4LF/2209057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) | $0.9600 | $4.8000
45 |  | 2 PIN JST Connector | P17 | Custom | ~~2 Pin JST Connector~~ | Custom | B2B-XH-A(LF)(SN) | --- | 1 | 5 | Digikey (https://www.digikey.com/en/products/detail/jst-sales-america-inc/B2B-XH-A-LF-SN/1651045) | $0.1500 | $0.7500
46 |  | SMD Battery Holders, Clips & Contacts RoHS | J6 | Custom | ~~CR1220-2~~ | Q&J | CH25 | --- | 1 | 5 | Digikey (https://www.digikey.com/en/products/detail/premium-batteries/CH25/13896129) | $0.4500 | $2.2500
47 |  | P=5.0mm Screw terminal RoHS | J7 | Custom | ~~WJ301V-5.0-3P~~ | Ningbo Kangnex Elec | 1715260000 | --- | 1 | 5 | Digikey (https://www.digikey.com/en/products/detail/weidm%C3%BCller/1715260000/269760) | $2.1300 | $10.6500
48 |  | P=5.0mm Screw terminal RoHS | J8, J#1 | Custom | ~~WJ301V-5.0-2P~~ | Ningbo Kangnex Elec | 1711725 | --- | 2 | 10 | Digikey (https://www.digikey.com/en/products/detail/phoenix-contact/1711725/260395) | $2.1120 | $21.1200
49 |  | ~~Wire Connecting Pad~~ | ~~P1~~ | ~~Custom~~ | ~~SMD PAD~~ | ~~Custom~~ | ~~--------~~ | ~~---~~ | ~~1~~ | ~~5~~ | ~~---~~ | ~~---~~ | ~~---~~
50 |  | ~~Test Point ON~~ | ~~P2, P12, P13, P14, P15, P16~~ | ~~Custom~~ | ~~TEST POINT~~ | ~~Custom~~ | ~~--------~~ | ~~---~~ | ~~6~~ | ~~30~~ | ~~---~~ | ~~---~~ | ~~---~~
51 |  | ~~CBL PLUG-OF-NAILS 10-PIN W/LEGS~~ | ~~J5~~ | ~~Custom~~ | ~~TC2050-IDC~~ | ~~Tag-Connect~~ |  | ~~---~~ | ~~1~~ | ~~5~~ | ~~---~~ | ~~---~~ | ~~---~~
52 |  | ~~Solder Bridge ON~~ | ~~SB3, SB21, SB_ZD1~~ | ~~Custom~~ | ~~Solder Bridge~~ | ~~Custom~~ | ~~--------~~ | ~~---~~ | ~~9~~ | ~~45~~ | ~~---~~ | ~~---~~ | ~~---~~
53 | Peripheral | LS-SG555 37MM Dc Gear Motor | ------- | Custom | LS-SG555 | Ningbo Leison Motor | ------- | ------- | 1 | 5 | Custom Supplier | $14.0000 | $70.0000
54 |  | Alkaline cell | ------- | Custom | AA LR6 | Energizer | ------- | ------- | 3 | 15 | Custom Supplier | $3.35 | $50.2500
55 |  | 128x64 green pixels OLED display | ------- | Custom | GDON242-2864KSWUG01-C24 | GooDisplay | ------- | ------- | 1 | 5 | Custom Supplier | $9.80 | $49.0000
56 |  | Capacitive proximity switch | ------- | Custom | CR18-8DN | ------- | LJC18A3-B-Z/BX | ------- | 1 | 5 | Custom Supplier | $4.58 | $22.9000 | IP65 rating
57 |  | Normally open reed switch | ------- | Custom | Adafruit | Adafruit | ------- | ------- | 1 | 5 | Adafruit (https://www.adafruit.com/product/375) | $3.950 | $19.7500
 |  |  |  |  |  |  |  | Total Component Cost |  |  |  |  | $388.76
 |  |  |  |  |  |  |  | Single Board Cost |  |  |  |  | $77.75
 |  |  |  |  |  |  |  | Motor Shipping Cost |  |  |  |  | $88.0000
