eSpark-Backup/grantkros-coopmonitor/Library-Files/Step Files/bcihp0730_asm.stp

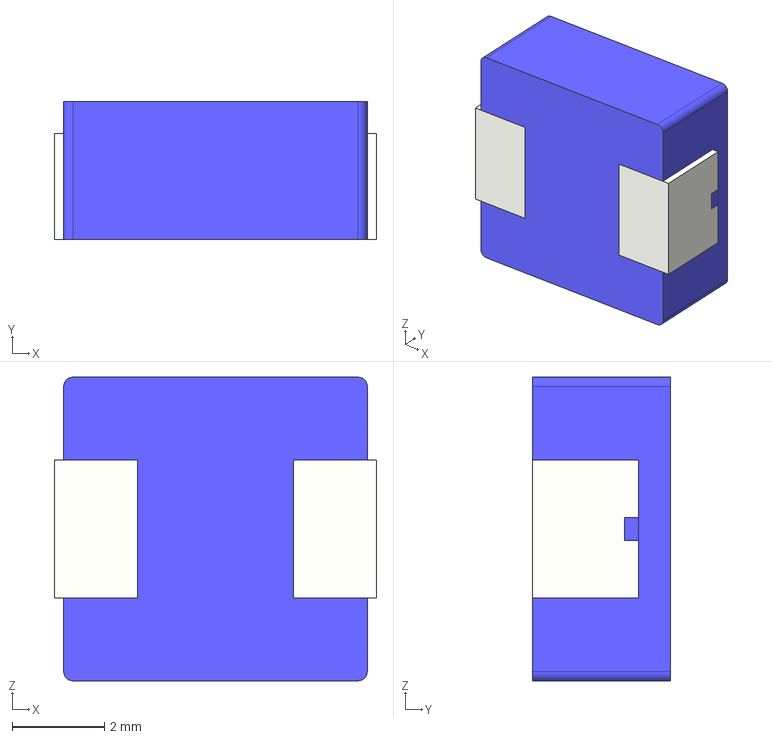
[picture p14: CAD file, 2022-01-30]
Library-Files/Step Files/bcihp0730_asm.stp
7.00 x 3.00 x 6.60 mm
BASE
PIN x 2
