eSpark-Backup/grantkros-coopmonitor/Deliverable/Interface_Board/Supporting_Files/Interface_PCB.step

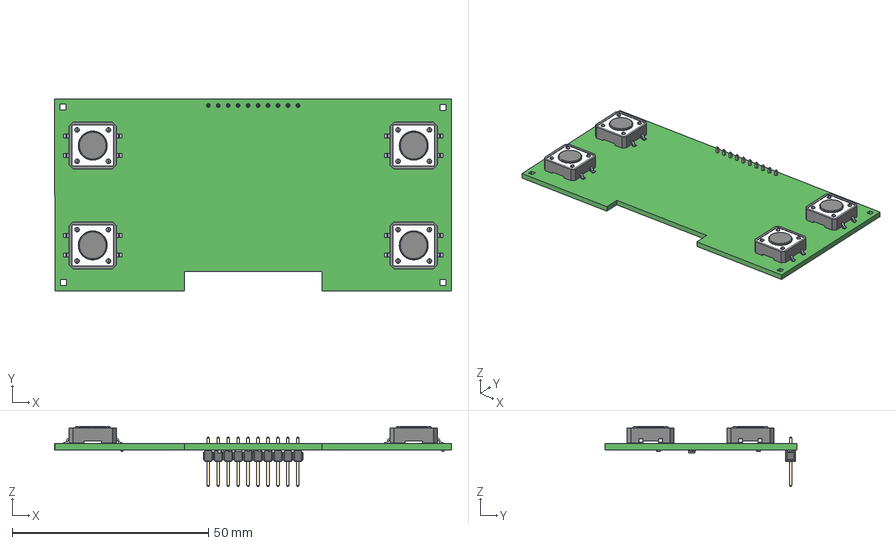
[picture p15: CAD file, 2022-05-25]
Deliverable/Interface_Board/Supporting_Files/Interface_PCB.step
101.2 x 49.0 x 15.4 mm
User_Library-Button_B3FS-4002P x 4
User_Library-RES_1005-0402 x 3
User_Library-RESC1608X05N
holder
pin x 10
User_Library-Capacitor_0402 x 8
User_Library-CAPC1608X09
