eSpark-Backup/grantkros-coopmonitor/Deliverable/Main_Board/Supporting_Files/Grantv3.step

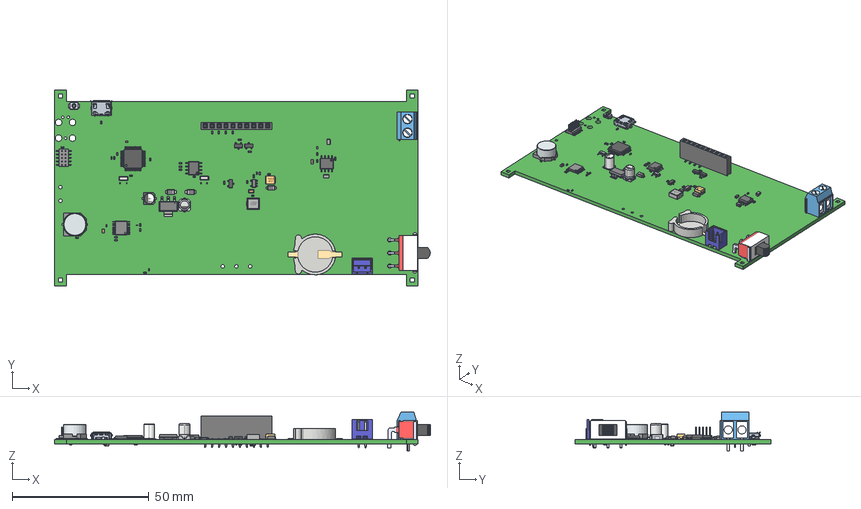
[picture p16: CAD file, 2022-05-25]
Deliverable/Main_Board/Supporting_Files/Grantv3.step
137.3 x 71.6 x 14.2 mm
10118194c
Base
Pin1Fillet
Pin2Fillet
User_Library-RES_1005-0402 x 27
User_Library-0201(0603M)_Res
CircuitWorks-SOT-23 x 3
DRV8876PWPR
User_Library-SOT-23-5-1
User_Library-Capacitor_0402 x 16
User_Library-CAPC1608X09 x 3
User_Library-AVX_BCASE
User_Library-SMD_Ceramic_Capacitors_0201_(0603)_AB x 4
COILMX_MS0420-4R7M
qj_cr1220-2
User_Library-RM127_10pin_Header
User_Library-SOD123W x 2
User_Library-NDK_NX3215SA x 2
User_Library-SOIC-8-1 x 2
User_Library-TQFP-48_pins_TQFP_pin_TQFP_022x07_1 x 48
User_Library-TQFP-48_body_10x1_TQFP_7x7_1
SOT-223-3_VAR-AA
User_Library-OMRON_B3U1000P
User_Library-1103M2S3ABE2
User_Library-PW10-XX-M_blue
User_Library-LED-0402
User_Library-0805_SMD_Capacitor x 2
TCseriesPcase_step_RGB6710886 x 2
User_Library-4x5_4
EEEHB1E6R8R
2-pin
User_Library-SOD123F
TCTseriesUcase_step_RGB6710886
