eSpark-Backup/grantkros-coopmonitor/Library-Files/Step Files/mcs0630.stp

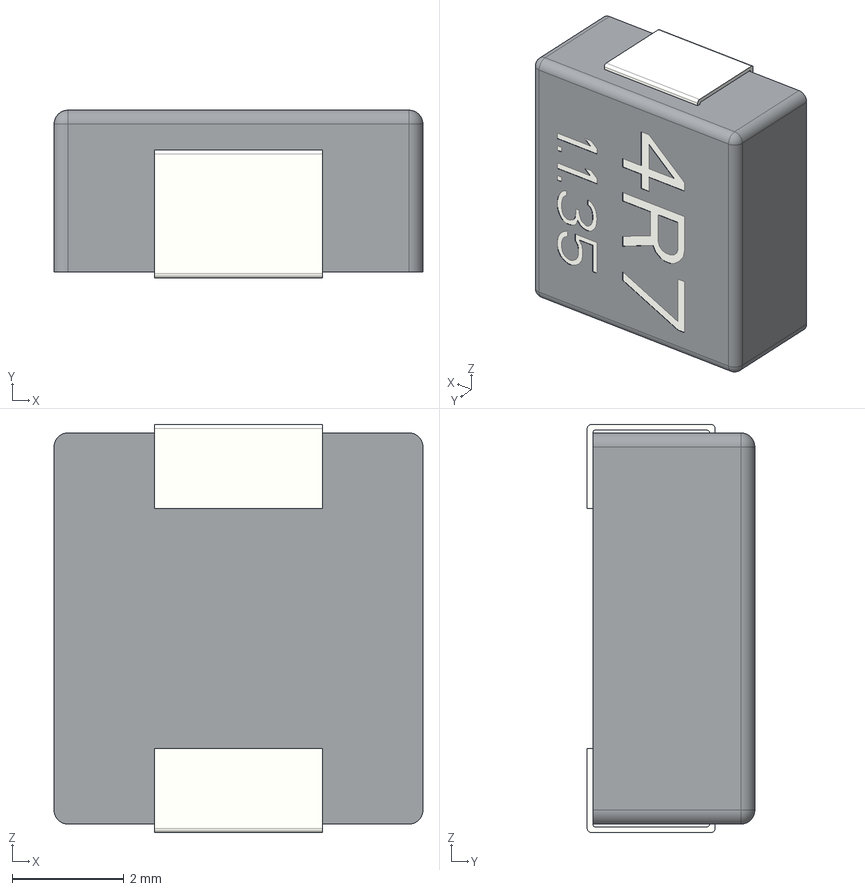
[picture p17: CAD file, 2022-01-30]
Library-Files/Step Files/mcs0630.stp
6.60 x 3.00 x 7.30 mm
