eSpark-Backup/grantkros-coopmonitor/Library-Files/Step Files/User Library-1103M2S3ABE2.step

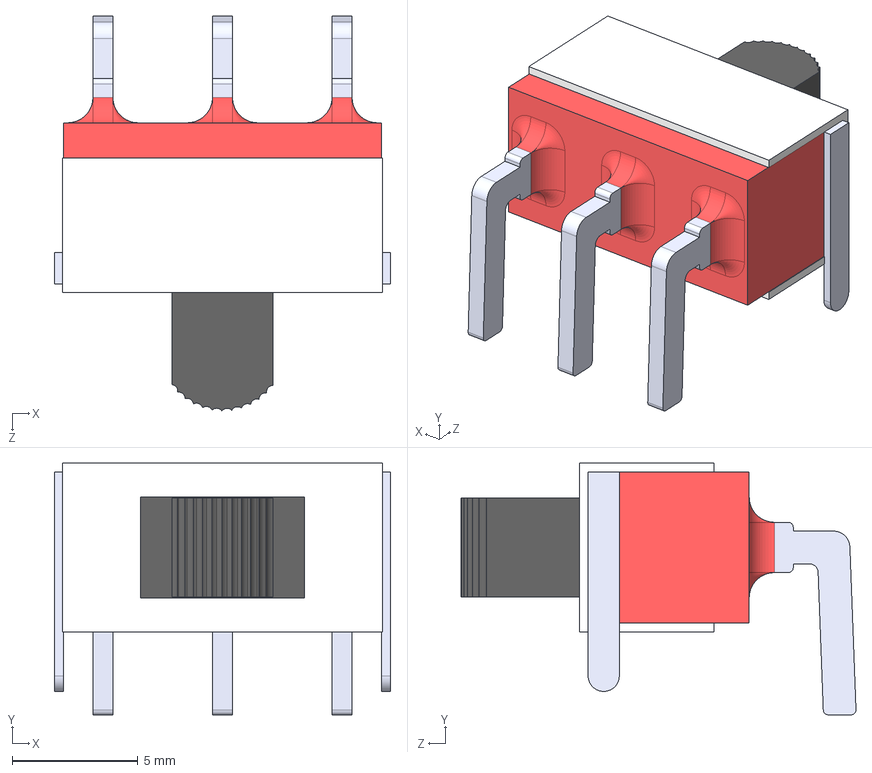
[picture p18: CAD file, 2022-01-30]
Library-Files/Step Files/User Library-1103M2S3ABE2.step
13.4 x 10.0 x 15.7 mm
