eSpark-Backup/grantkros-coopmonitor/Library-Files/Step Files/User Library-RM127_10pin_Header.step

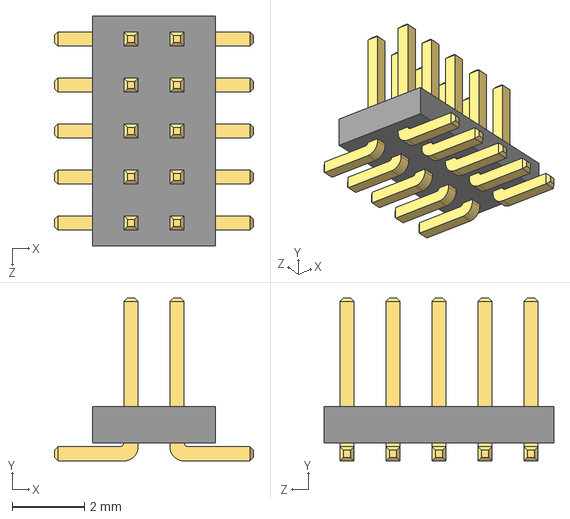
[picture p19: CAD file, 2022-01-30]
Library-Files/Step Files/User Library-RM127_10pin_Header.step
5.50 x 4.50 x 6.35 mm
