eSpark-Backup/grantkros-coopmonitor/Library-Files/Step Files/CUI-PJ-002A-SMT.step

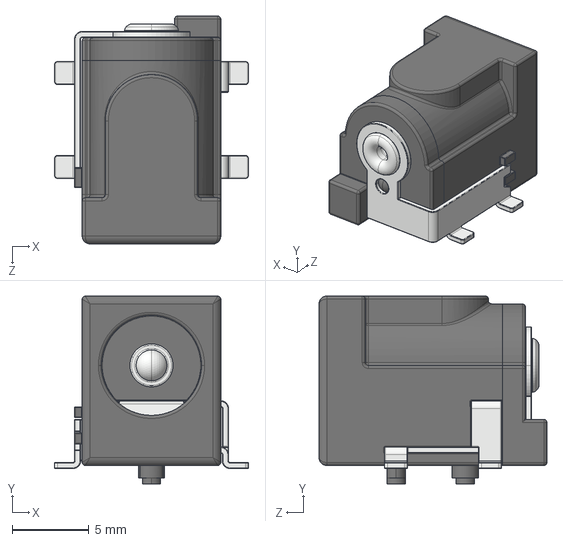
[picture p20: CAD file, 2022-01-30]
Library-Files/Step Files/CUI-PJ-002A-SMT.step
12.6 x 12.2 x 14.8 mm
