eSpark-Backup/grantkros-coopmonitor/Library-Files/Step Files/User Library-MSOP-8 MSOP-8L.step

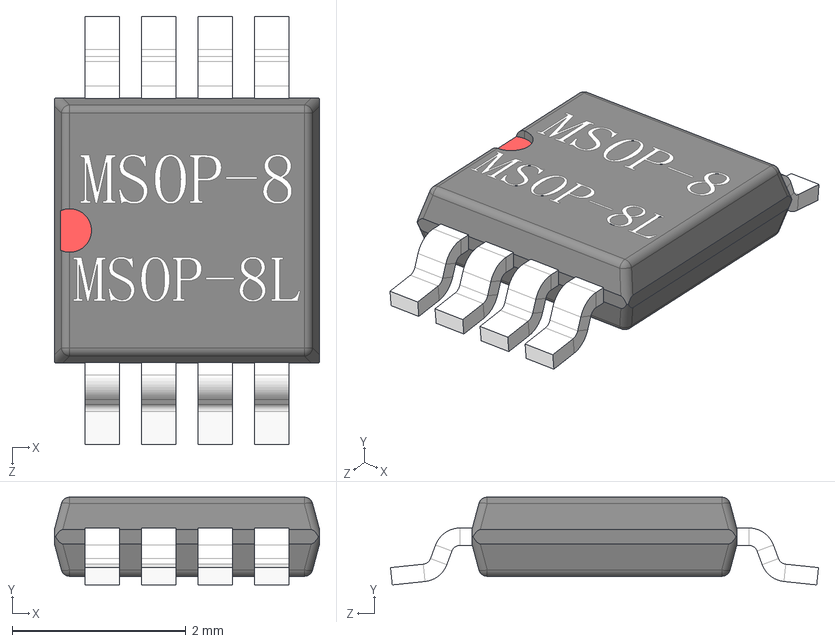
[picture p21: CAD file, 2022-01-30]
Library-Files/Step Files/User Library-MSOP-8 MSOP-8L.step
3.05 x 1.01 x 4.92 mm
