eSpark-Backup/grantkros-coopmonitor/Library-Files/Step Files/switch.stp

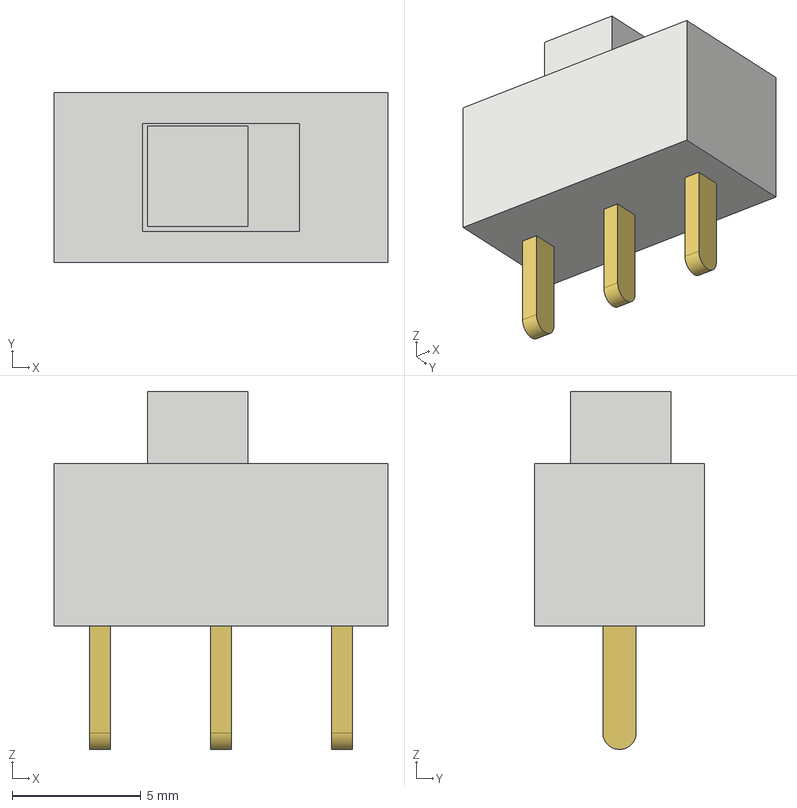
[picture p22: CAD file, 2022-01-30]
Library-Files/Step Files/switch.stp
12.9 x 6.60 x 13.9 mm
