eSpark-Backup/grantkros-coopmonitor/Library-Files/Step Files/User Library-SOP-4-1.step

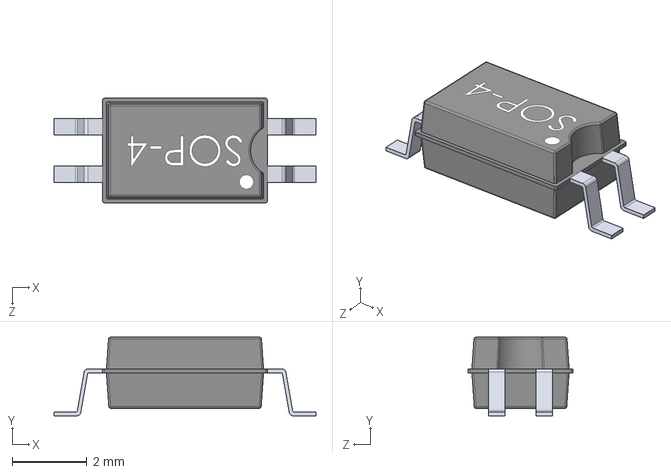
[picture p23: CAD file, 2022-01-30]
Library-Files/Step Files/User Library-SOP-4-1.step
7.00 x 2.10 x 2.80 mm
