eSpark-Backup/grantkros-coopmonitor/Library-Files/Step Files/User Library-SOD-882D.step

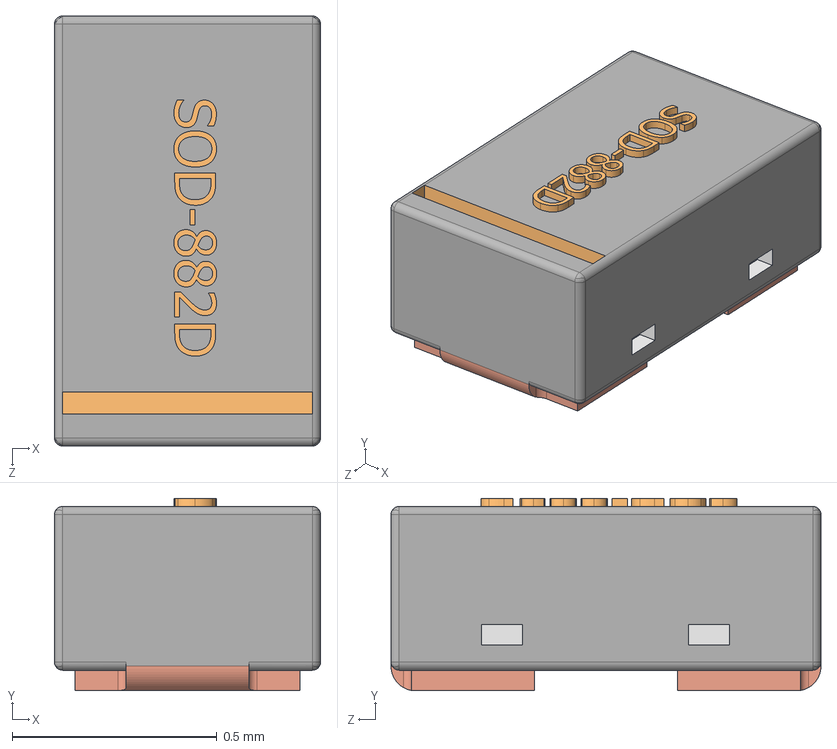
[picture p24: CAD file, 2022-01-30]
Library-Files/Step Files/User Library-SOD-882D.step
0.65 x 0.47 x 1.05 mm
