eSpark-Backup/grantkros-coopmonitor/Library-Files/Step Files/User Library-DO-214AD.step

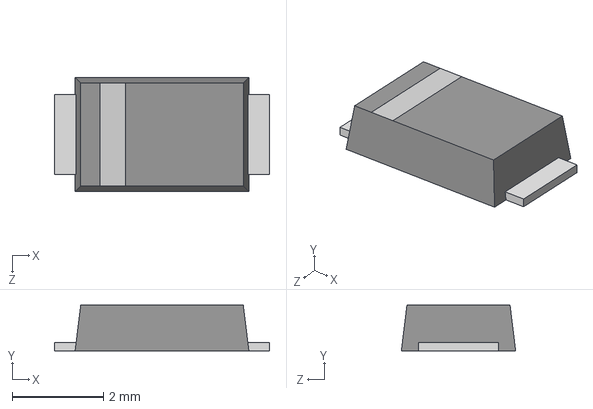
[picture p25: CAD file, 2022-01-30]
Library-Files/Step Files/User Library-DO-214AD.step
4.70 x 1.00 x 2.50 mm
