eSpark-Backup/grantkros-coopmonitor/Library-Files/Step Files/User Library-SOT363-2.step

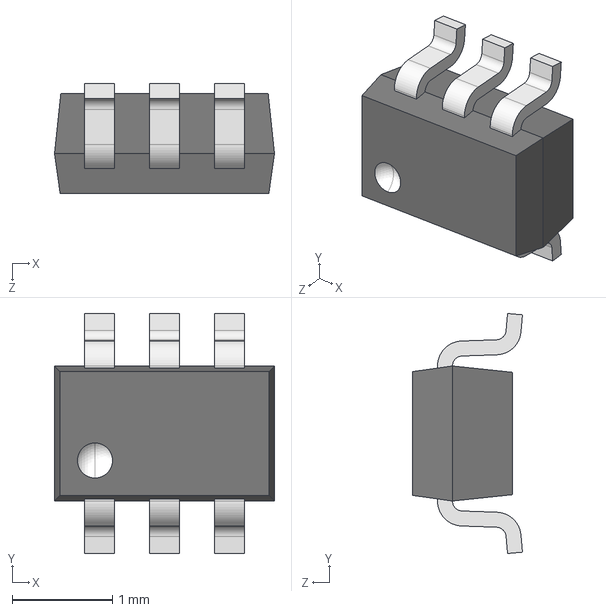
[picture p26: CAD file, 2022-01-30]
Library-Files/Step Files/User Library-SOT363-2.step
2.20 x 2.40 x 1.10 mm
