eSpark-Backup/grantkros-coopmonitor/Library-Files/Step Files/SIM-ST-MFF2--3DModel-STEP-56544.STEP

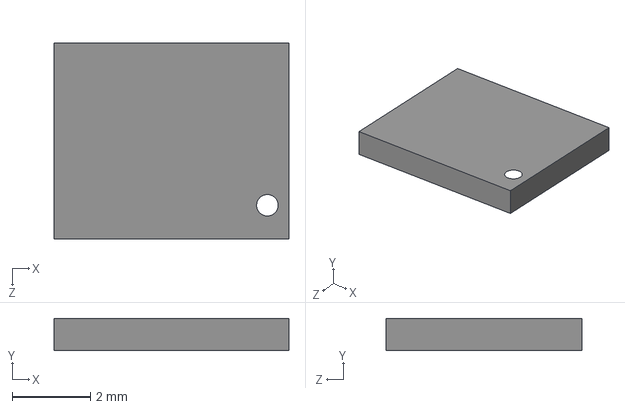
[picture p27: CAD file, 2022-01-30]
Library-Files/Step Files/SIM-ST-MFF2--3DModel-STEP-56544.STEP
6.00 x 0.82 x 5.00 mm
