eSpark-Backup/grantkros-coopmonitor/Library-Files/Step Files/tps63020_asm.stp

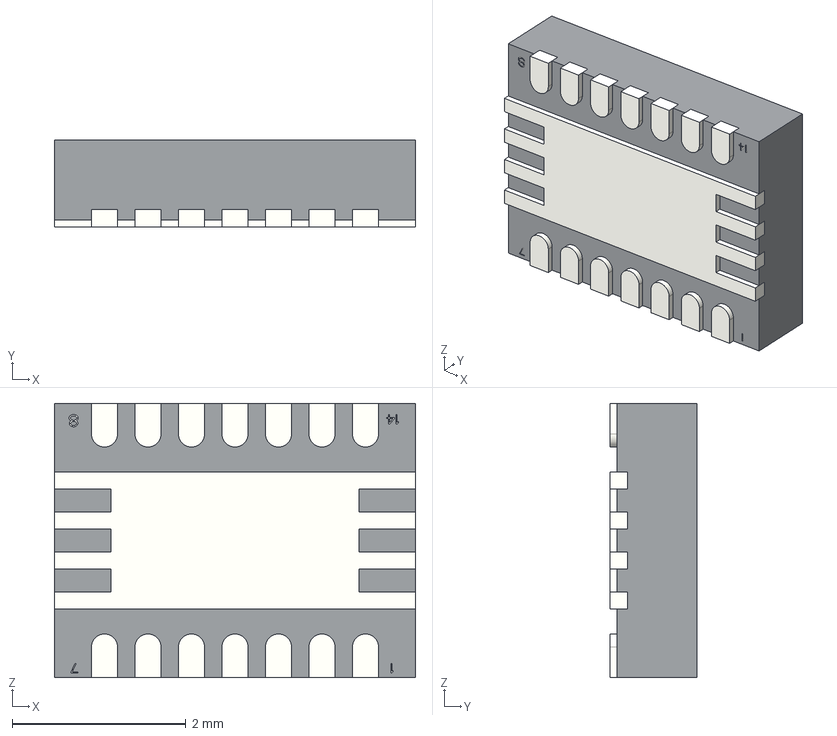
[picture p28: CAD file, 2022-01-30]
Library-Files/Step Files/tps63020_asm.stp
4.15 x 1.00 x 3.15 mm
BASE
PIN x 14
PIN2
