eSpark-Backup/grantkros-coopmonitor/Library-Files/Step Files/LMR14050SDDAR--3DModel-STEP-56544.STEP

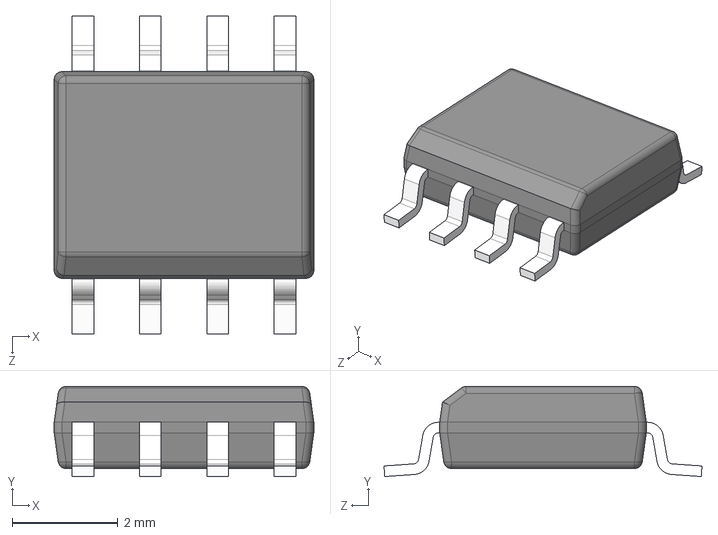
[picture p29: CAD file, 2022-01-30]
Library-Files/Step Files/LMR14050SDDAR--3DModel-STEP-56544.STEP
4.90 x 1.70 x 6.00 mm
