eSpark-Backup/grantkros-coopmonitor/Library-Files/Step Files/10118194c.stp

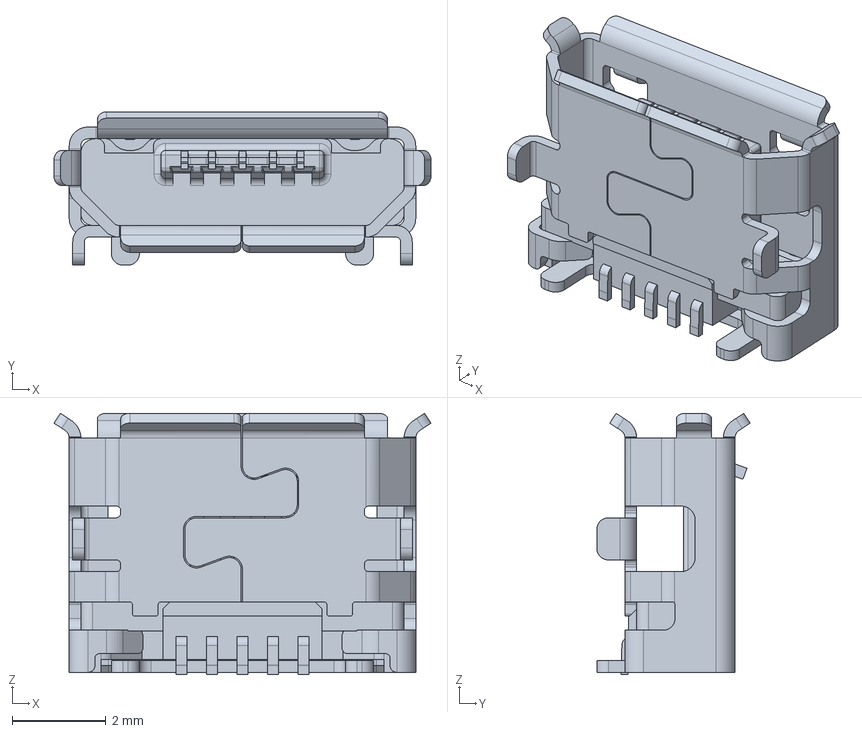
[picture p30: CAD file, 2022-01-30]
Library-Files/Step Files/10118194c.stp
8.05 x 3.27 x 5.58 mm
