eSpark-Backup/grantkros-coopmonitor/(list of files, cad)

Other CAD files:
Deliverable/Interface_Board/Supporting_Files/Interface_PCB.DWG
Deliverable/Main_Board/Supporting_Files/Grantv3.DWG
