eSpark-Backup/grantkros-coopmonitor/Design-Files/Grantiot.pdf

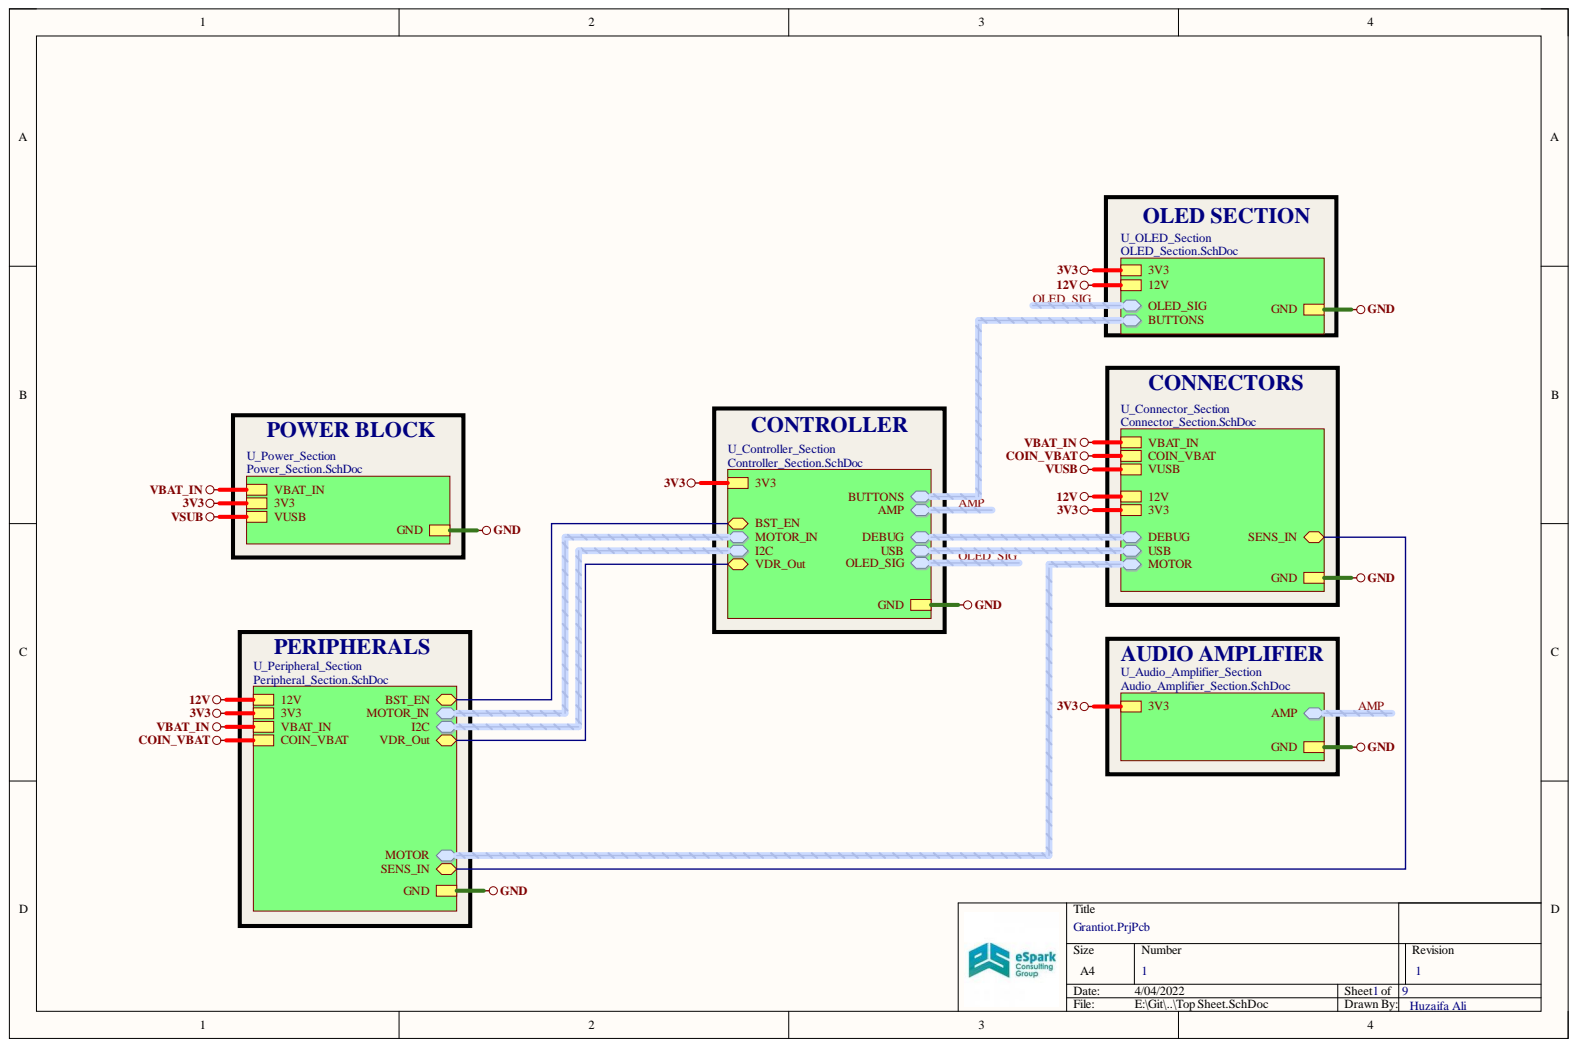
[picture p31: page 1]

GND

DEBUG SENS_IN

I2C USB VDR_Out OLED_SIG | USB MOTOR

Title Grantiot.PrjPcb

Size A4 | Number 1 | Revision 1

Date: 4/04/2022 | Sheet of 1 | 9
File: E:\Git\..\Top Sheet.SchDoc | Drawn By: | Huzaifa Ali

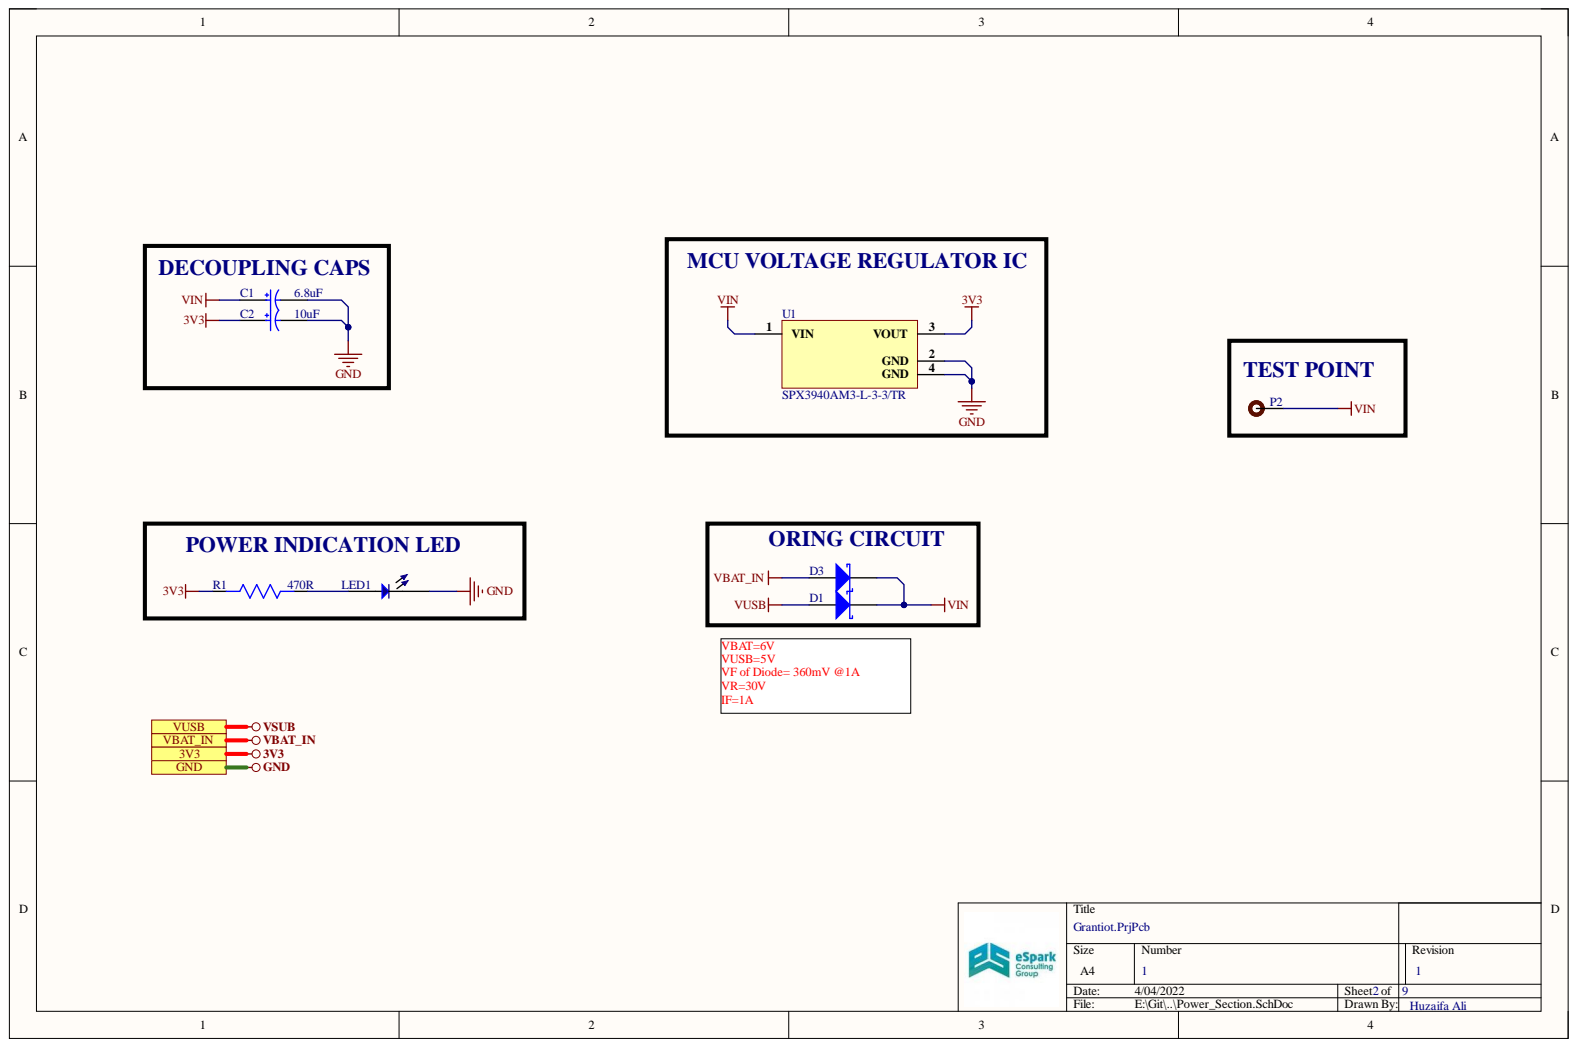
[picture p32: page 2]

Title Grantiot.PrjPcb

Size A4 | Number 1 | Revision 1

Date: 4/04/2022 | Sheet of 2 | 9
File: E:\Git\..\Power_Section.SchDoc | Drawn By: | Huzaifa Ali

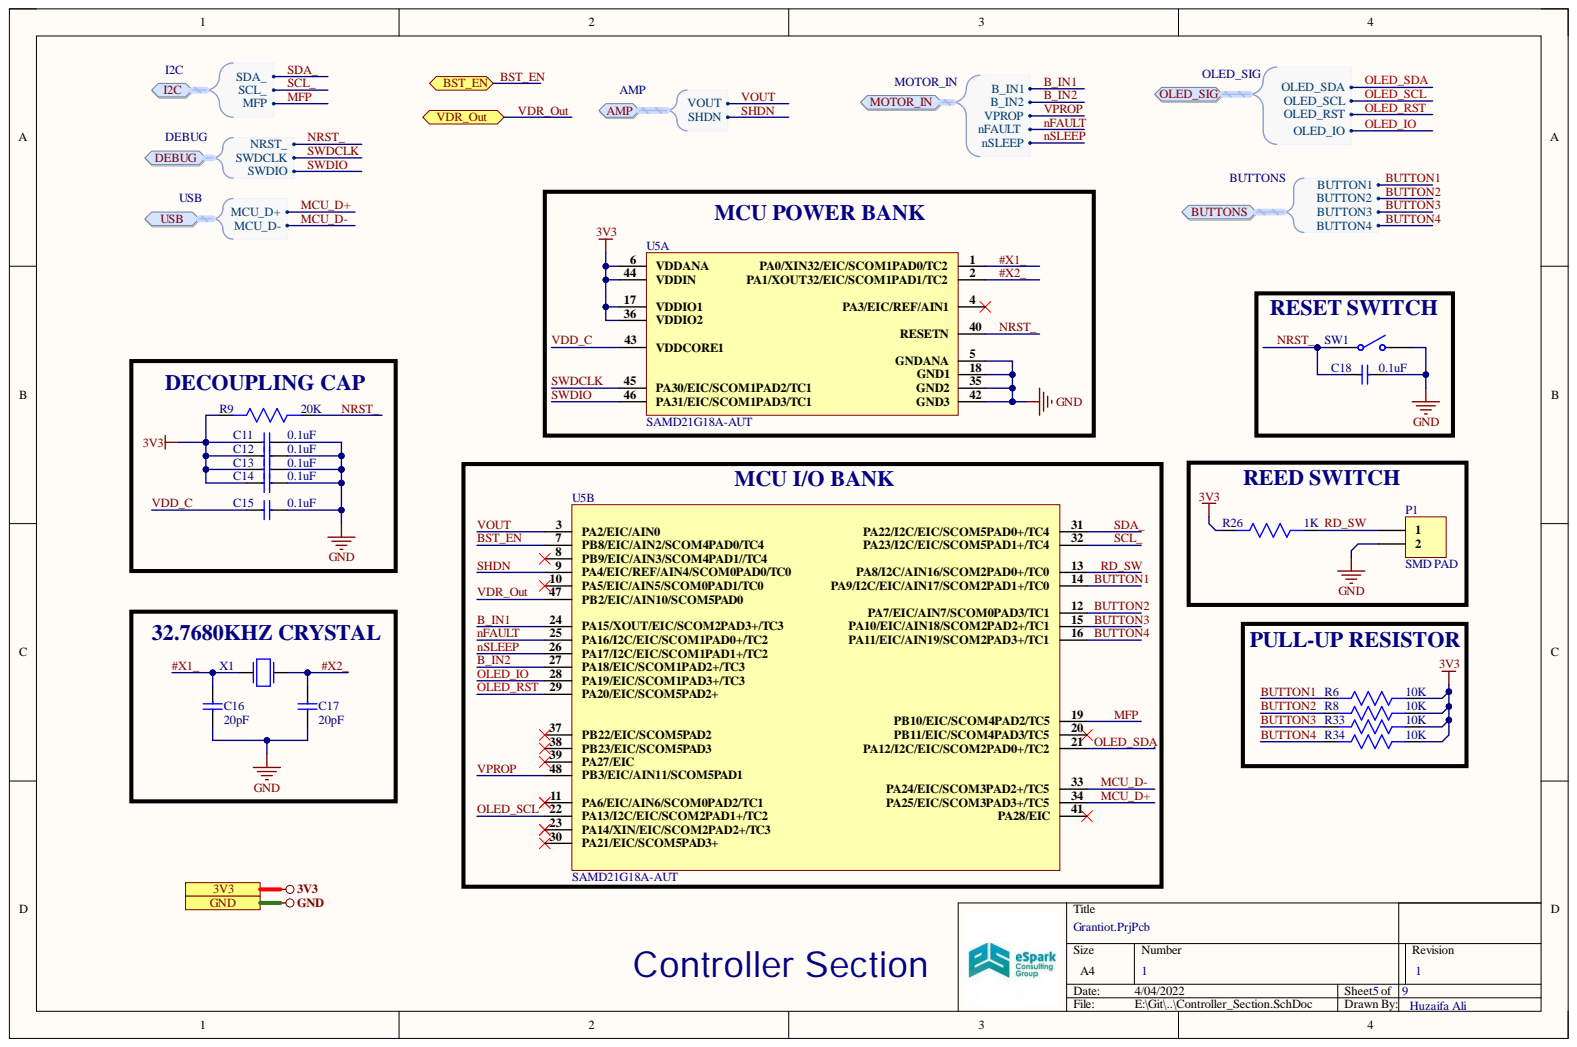
[picture p33: page 3]

C12 | 0.1uF
C13 | 0.1uF

Title Grantiot.PrjPcb

Size A4 | Number 1 | Revision 1

Date: 4/04/2022 | Sheet of 5 | 9
File: E:\Git\..\Controller_Section.SchDoc | Drawn By: | Huzaifa Ali

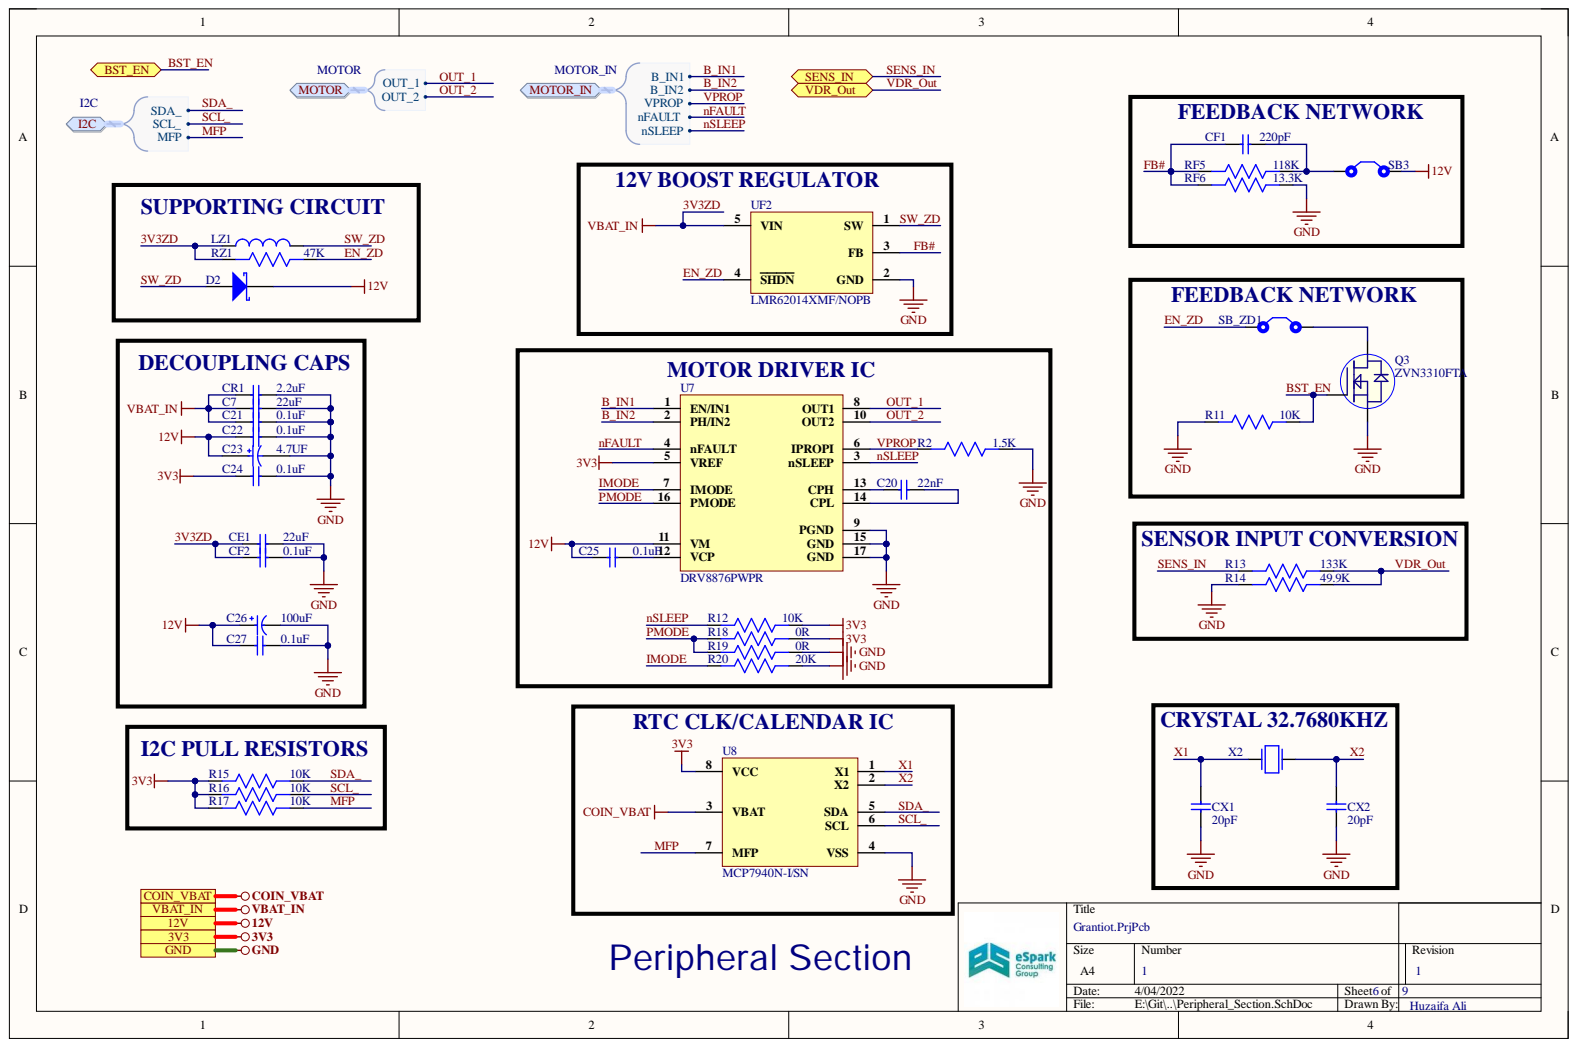
[picture p34: page 4]

RTC CLK/CALENDAR IC

Title Grantiot.PrjPcb

Size A4 | Number 1 | Revision 1

Date: 4/04/2022 | Sheet of 6 | 9
File: E:\Git\..\Peripheral_Section.SchDoc | Drawn By: | Huzaifa Ali

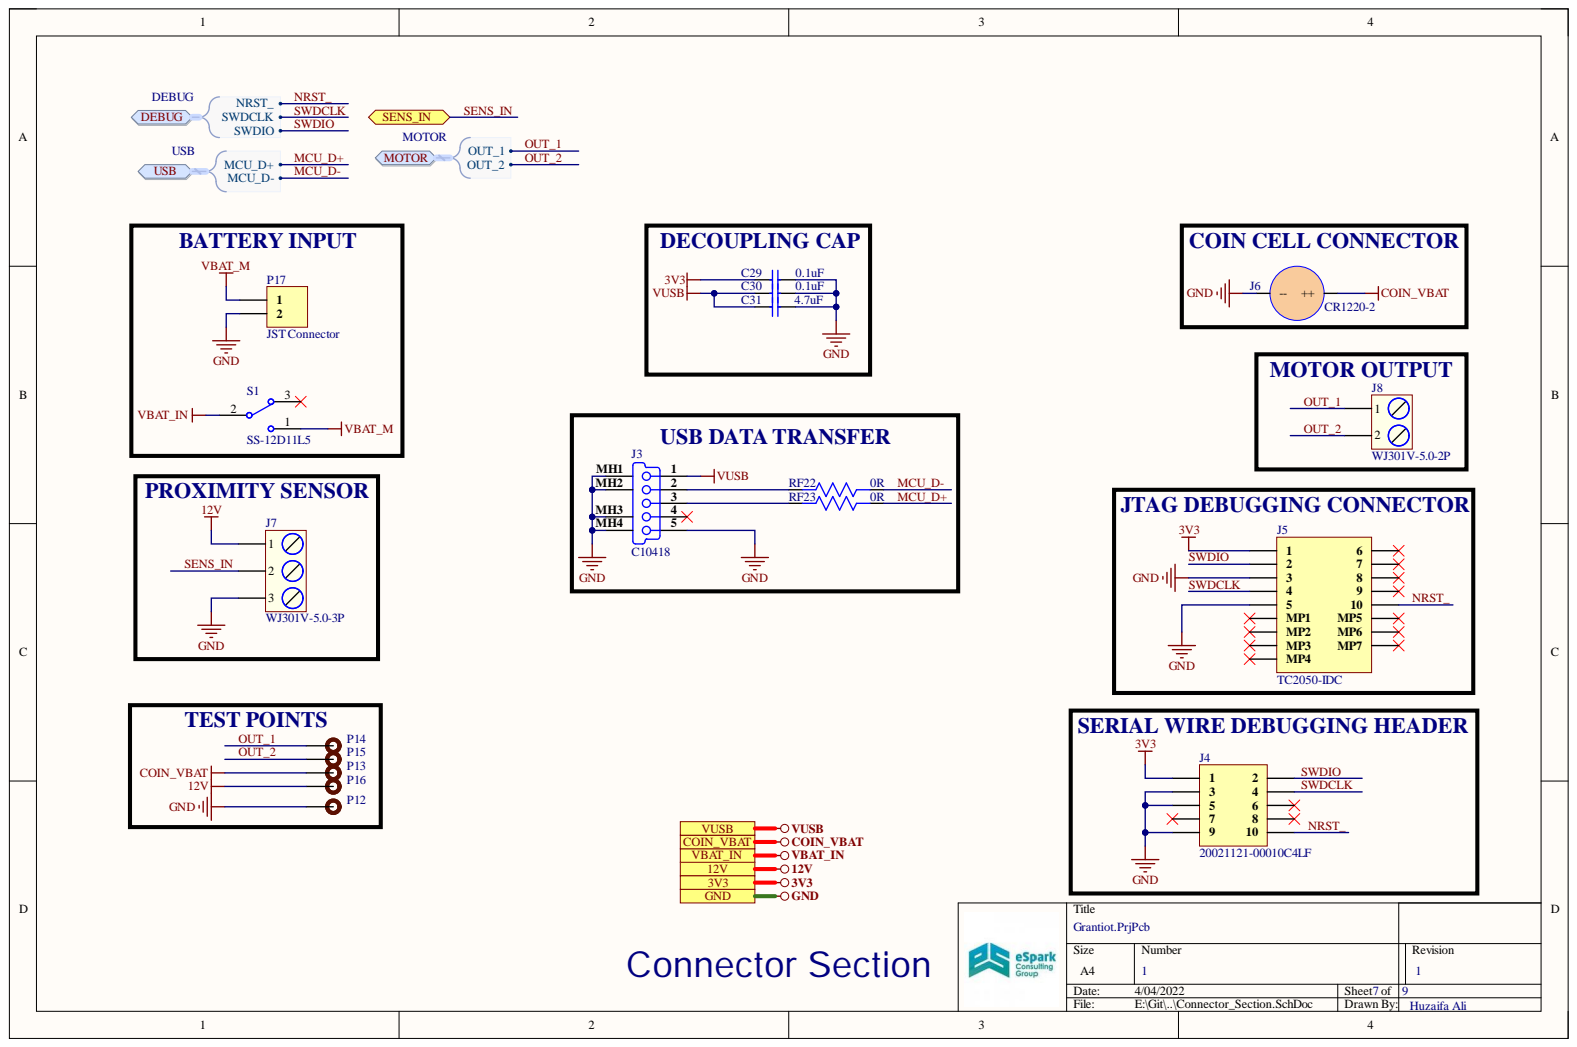
[picture p35: page 5]

SERIAL WIRE DEBUGGING HEADER

Title Grantiot.PrjPcb

Size A4 | Number 1 | Revision 1

Date: 4/04/2022 | Sheet of 7 | 9
File: E:\Git\..\Connector_Section.SchDoc | Drawn By: | Huzaifa Ali

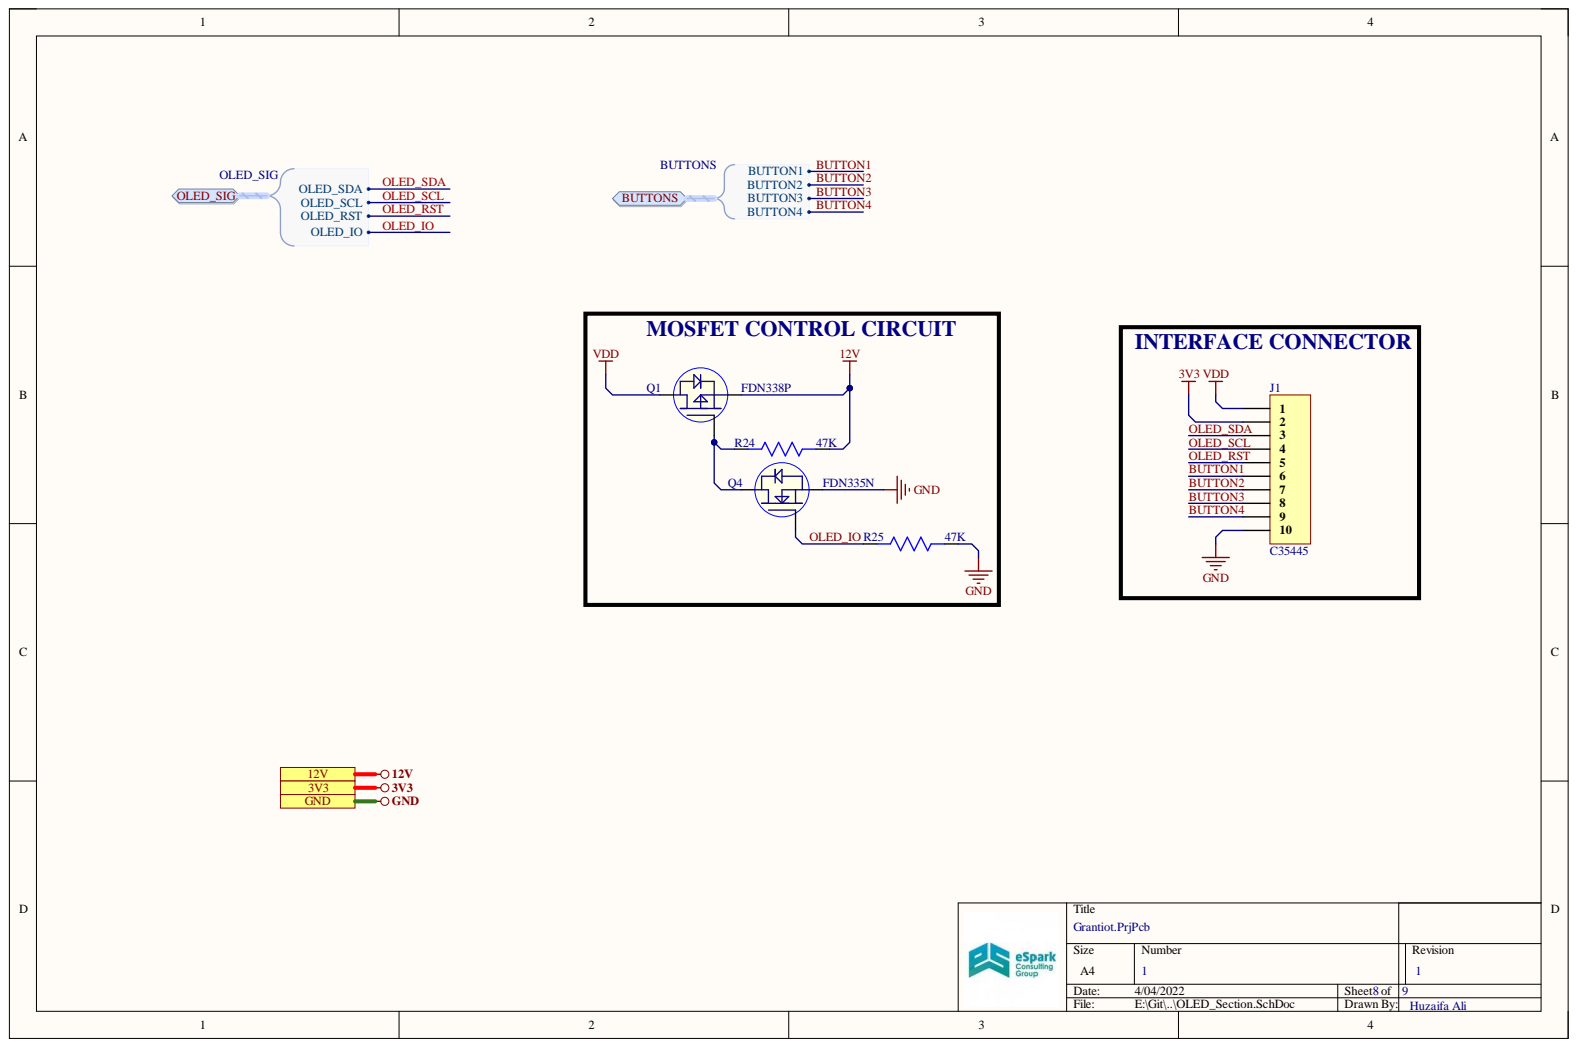
[picture p36: page 6]

Title Grantiot.PrjPcb

Size A4 | Number 1 | Revision 1

Date: 4/04/2022 | Sheet of 8 | 9
File: E:\Git\..\OLED_Section.SchDoc | Drawn By: | Huzaifa Ali

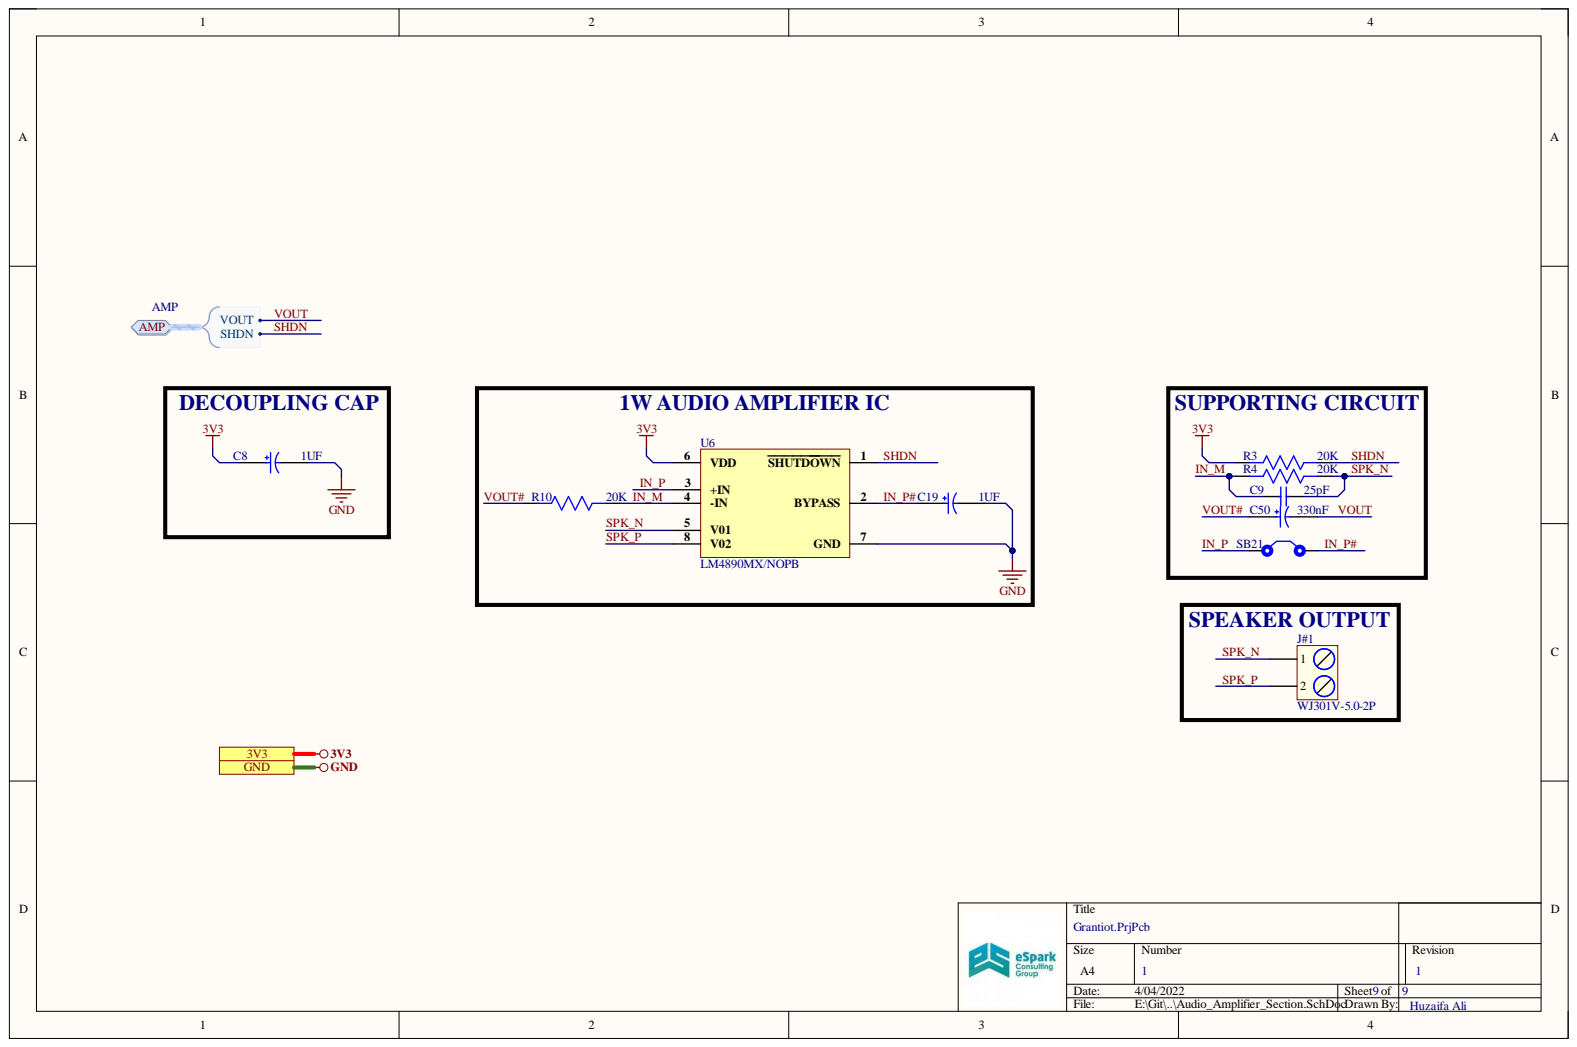
[picture p37: page 7]

Title Grantiot.PrjPcb

Size A4 | Number 1 | Revision 1

Date: 4/04/2022 | Sheet of 9 | 9
File: E:\Git\..\Audio_Amplifier_Section.SchDocDrawn By: | | Huzaifa Ali

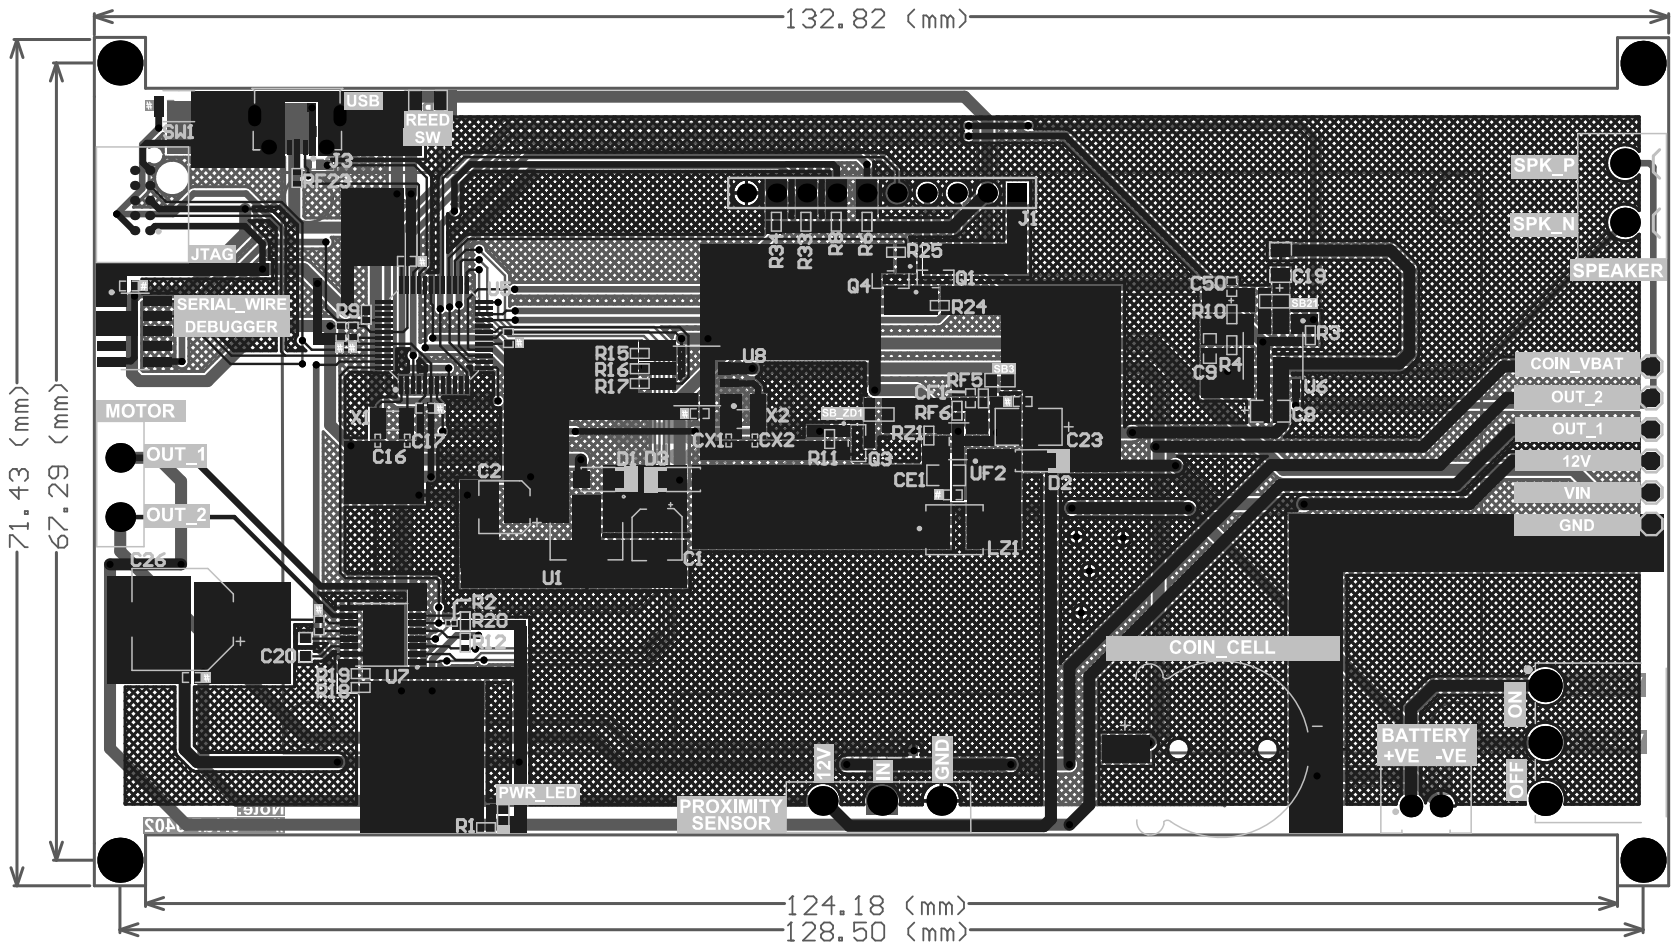
[picture p38: page 8]
