eSpark-Backup/grantkros-coopmonitor/Deliverable/Interface_Board/Schematics/Assembly_Drawing.pdf

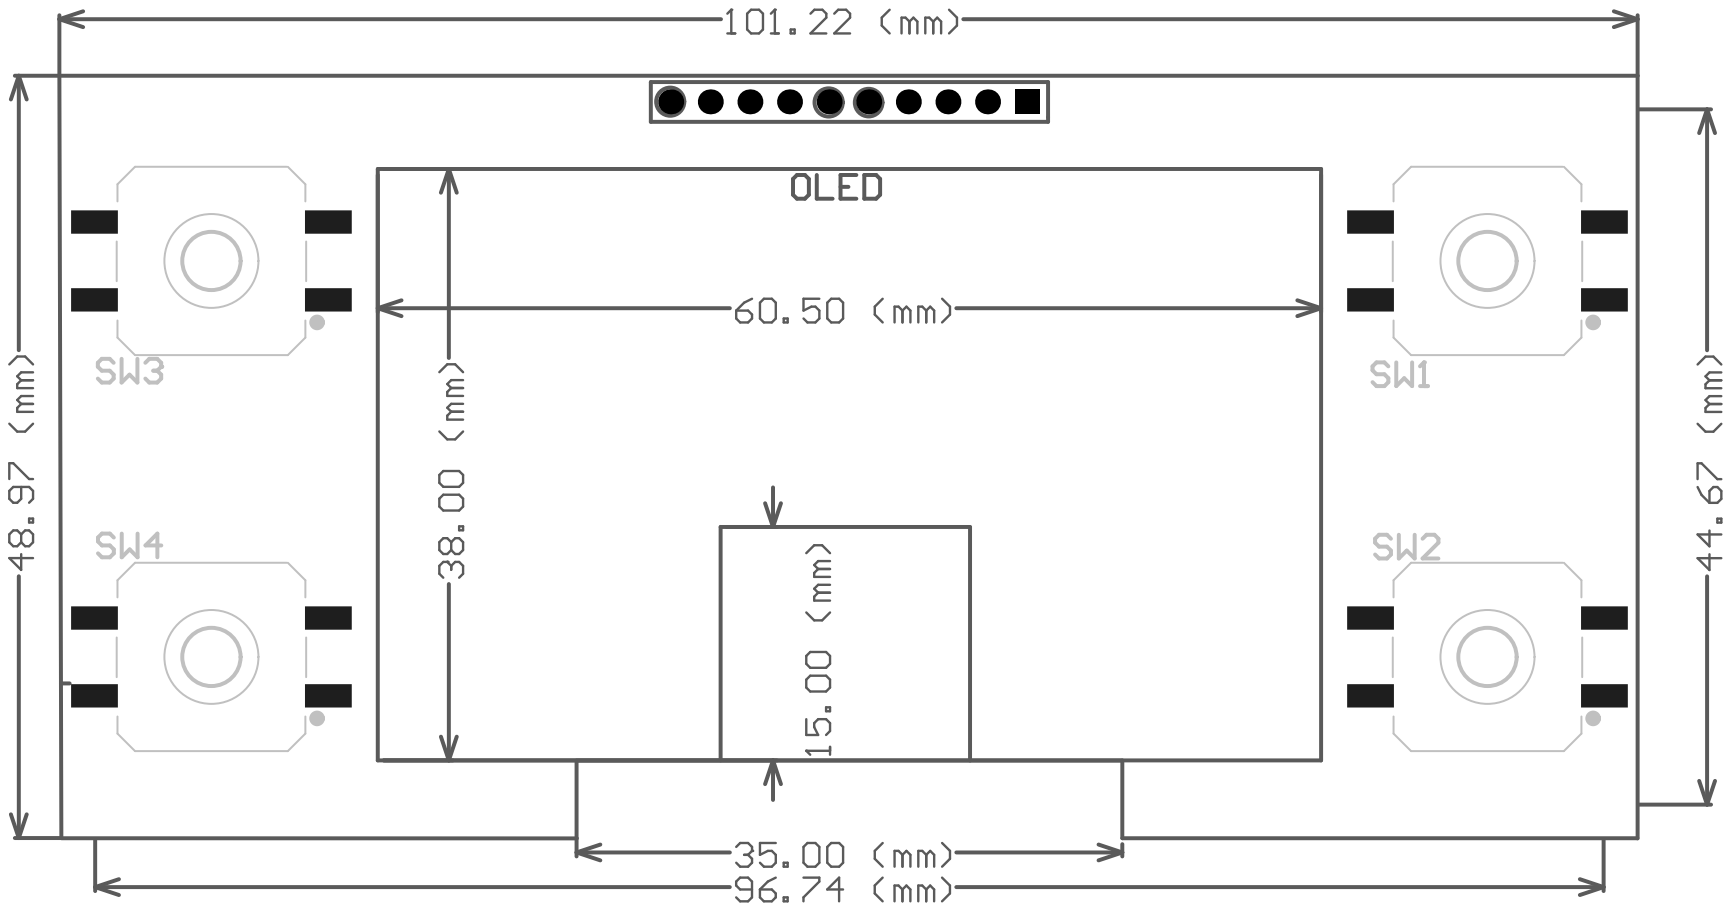
[picture p39: page 1]

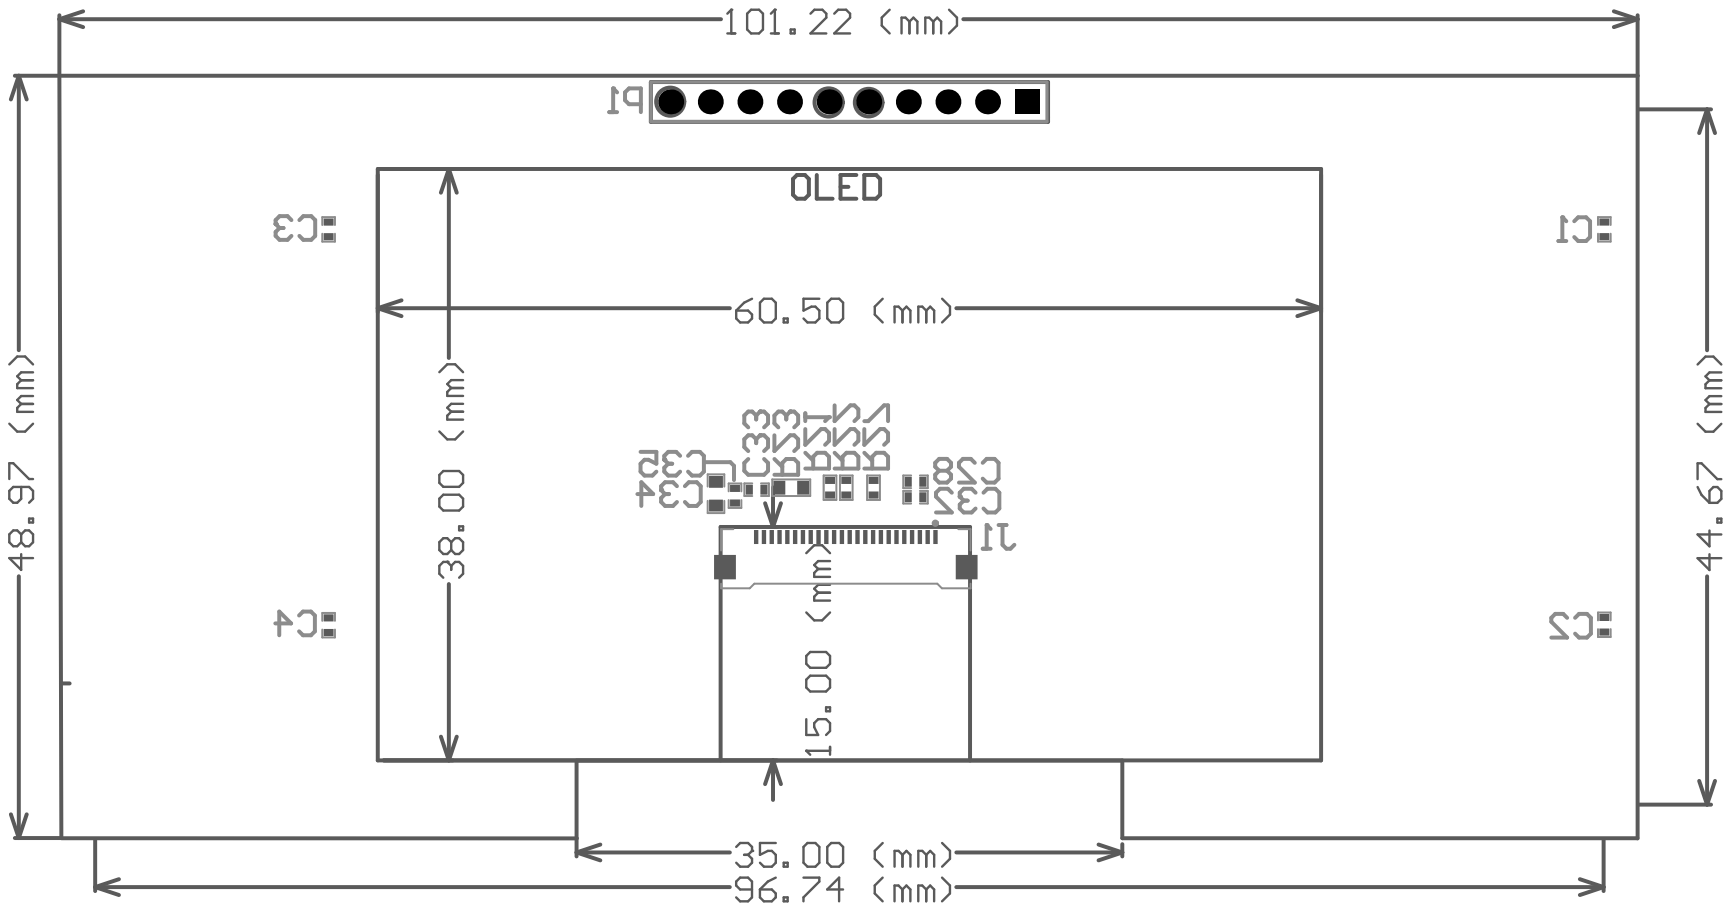
[picture p40: page 2]
