eSpark-Backup/grantkros-coopmonitor/Deliverable/Interface_Board/Schematics/Interface_PCB.pdf

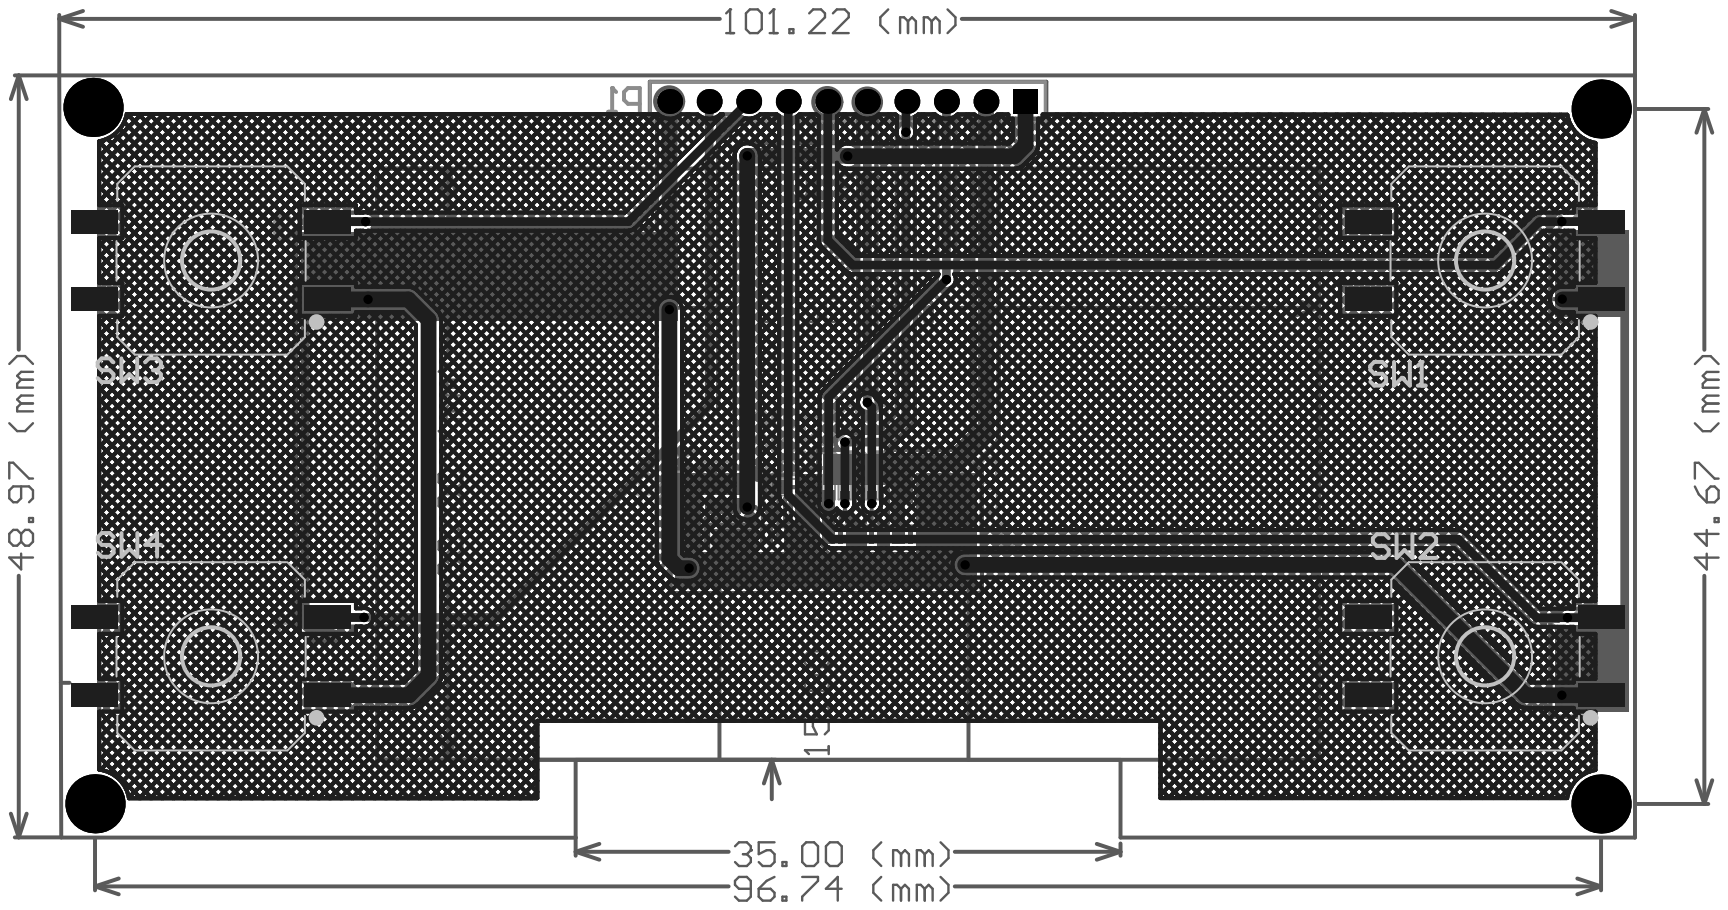
[picture p41: page 1]
