eSpark-Backup/grantkros-coopmonitor/Deliverable/Main_Board/Schematics/Assembly_Drawing.pdf

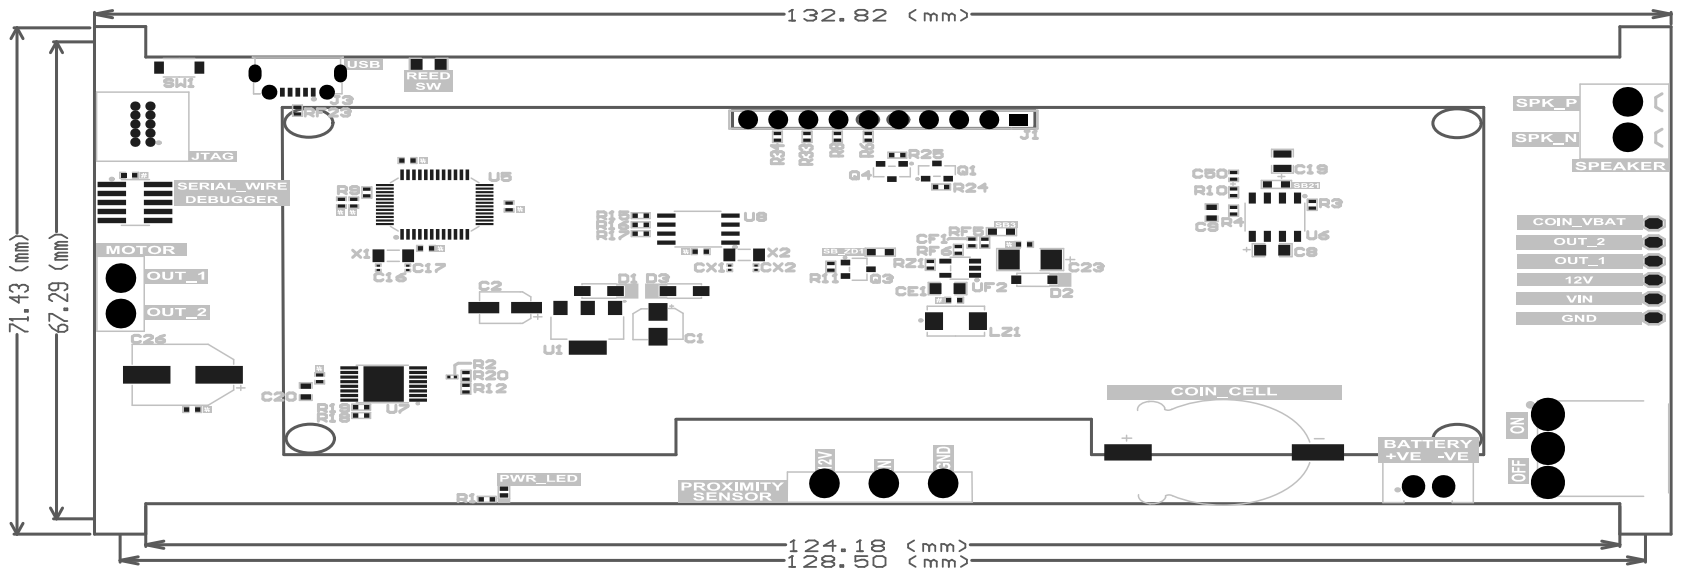
[picture p42: page 1]

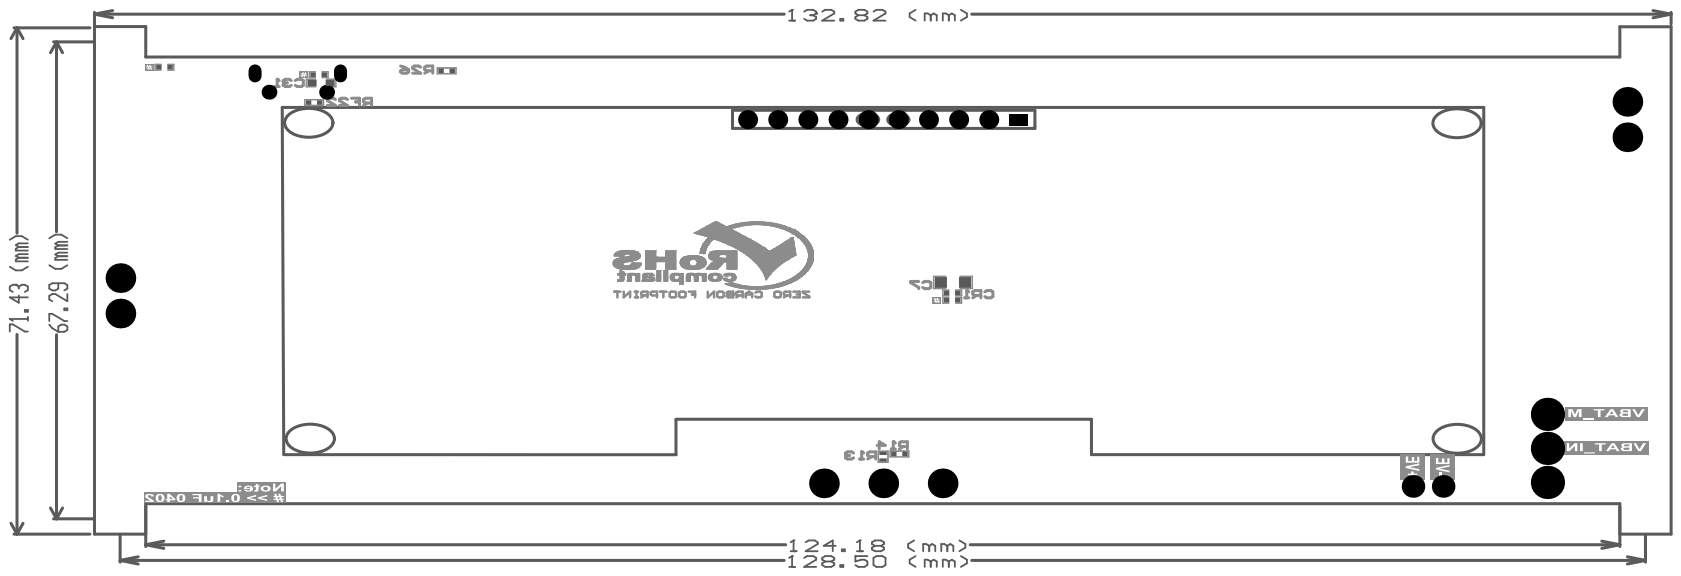
[picture p43: page 2]
