eSpark-Backup/grantkros-coopmonitor/(list of files, drawings)

Other design files:
Design-Files/3G Modem_Section.SchDoc
Design-Files/Audio_Amplifier_Section.SchDoc
Design-Files/Connector_Section.SchDoc
Design-Files/Controller_Section.SchDoc
Design-Files/Grantiot.PrjPcb
Design-Files/Grantv3.PcbDoc
Design-Files/OLED_Section.SchDoc
Design-Files/Peripheral_Section.SchDoc
Design-Files/Power_Section.SchDoc
Design-Files/Top Sheet.SchDoc
Interface-Board/Button_Section.SchDoc
Interface-Board/Connector_Section.SchDoc
Interface-Board/Interface-Board.PrjPcb
Interface-Board/Interface_PCB.PcbDoc
Interface-Board/OLED_Section.SchDoc
Interface-Board/Top_Sheet.SchDoc
Library-Files/Grant_..PcbLib
Library-Files/Grant_..SchLib
