eSpark-Backup/grantkros-coopmonitor/Test-Codes/Custom Board/OLED_I2C_Scanner/OLED_I2C_Scanner.ino

#define Serial SerialUSB
 
#include <Wire.h>
#include "wiring_private.h"
TwoWire myWire(&sercom2, 22, 38);
//#define Wire myWire
void setup() {
  myWire.begin();
  pinPeripheral(22, PIO_SERCOM);
  pinPeripheral(38, PIO_SERCOM);
  Serial.begin(9600);
  while (!Serial); // Leonardo: wait for serial monitor
  Serial.println("\nI2C Scanner");
}

void loop() {
  int nDevices = 0;

  Serial.println("Scanning...");

  for (byte address = 1; address < 127; ++address) {
    // The i2c_scanner uses the return value of
    // the Write.endTransmisstion to see if
    // a device did acknowledge to the address.
    myWire.beginTransmission(address);
    byte error = myWire.endTransmission();

    if (error == 0) {
      Serial.print("I2C device found at address 0x");
      if (address < 16) {
        Serial.print("0");
      }
      Serial.print(address, HEX);
      Serial.println("  !");

      ++nDevices;
    } else if (error == 4) {
      Serial.print("Unknown error at address 0x");
      if (address < 16) {
        Serial.print("0");
      }
      Serial.println(address, HEX);
    }
  }
  if (nDevices == 0) {
    Serial.println("No I2C devices found\n");
  } else {
    Serial.println("done\n");
  }
  delay(5000); // Wait 5 seconds for next scan
}
