eSpark-Backup/grantkros-coopmonitor/(commit log)

2022-01-30 Design Files (Hardware) of Chicken Feeder Project
    [10118194c.stp, 3G Modem_Section.SchDoc, BOM - Grant LCSC.xlsx, Battery_Management_Section.SchDoc, CUI-PJ-002A-SMT.step, Connector_Section.SchDoc, Controller_Section.SchDoc, Grant..PcbDoc]
2022-01-31 #2 Pause @UroojNav ap continue kr len
    [Battery_Management_Section.SchDoc, Connector_Section.SchDoc, Controller_Section.SchDoc, Grantiot.PrjPcb, Grantv3.PcbDoc, Peripheral_Section.SchDoc, Power_Section.SchDoc, Top Sheet.SchDoc]
2022-01-31 Connector section formated. Some harness added.
    [Connector_Section.SchDoc, Controller_Section.SchDoc, Grantiot.PrjPcb, Peripheral_Section.SchDoc, Power_Section.SchDoc]
2022-02-01 Peripheral section and Harnesses added
    [Controller_Section.SchDoc, Peripheral_Section.SchDoc]
2022-02-02 Issue #1 completed. schematic restructured and compile errors removed.
    [Battery_Management_Section.SchDoc, Connector_Section.SchDoc, Controller_Section.SchDoc, Peripheral_Section.SchDoc, Power_Section.SchDoc, Top Sheet.SchDoc]
2022-02-03 Changes done as per issue #4
    [Connector_Section.SchDoc, Controller_Section.SchDoc, Power_Section.SchDoc]
2022-02-03 0.1uF cap added #4
    [Peripheral_Section.SchDoc]
2022-02-04 Text and borders added to top sheet blocks.
    [Top Sheet.SchDoc]
2022-02-05 #7 Completed
    [Grant_..PcbLib, Grant_..SchLib]
2022-02-05 Audio amplifier added. #8
    [Audio_Amplifier_Section.SchDoc, Controller_Section.SchDoc, Grant_..SchLib, Grantiot.PrjPcb, Peripheral_Section.SchDoc, Top Sheet.SchDoc]
2022-02-07 #7 TCTU1D334M8R Is part ka footprint change hua ha
    [Grant_..PcbLib, Grant_..SchLib]
2022-02-07 #10 Remaining
    [Grant_..PcbLib, Grant_..SchLib]
2022-02-08 #10 Pause
    [Grant_..PcbLib, Grant_..SchLib]
2022-02-08 #10 Completed
    [Battery_Management_Section.SchDoc, Connector_Section.SchDoc, Controller_Section.SchDoc, Grant_..PcbLib, Grant_..SchLib, Peripheral_Section.SchDoc, Power_Section.SchDoc]
2022-02-08 #11 Completed
    [Audio_Amplifier_Section.SchDoc, Battery_Management_Section.SchDoc, Connector_Section.SchDoc, Controller_Section.SchDoc, Grant_..PcbLib, Grant_..SchLib, Grantiot.PrjPcb, Peripheral_Section.SchDoc]
2022-02-09 issue #14, #13, #1 completed
    [Audio_Amplifier_Section.SchDoc, Battery_Management_Section.SchDoc, Connector_Section.SchDoc, Controller_Section.SchDoc, Grantiot.PrjPcb, Peripheral_Section.SchDoc, Power_Section.SchDoc, Top Sheet.SchDoc]
2022-02-09 #16 Completed
    [Grant_..PcbLib, Grant_..SchLib]
2022-02-09 BCD and 7 segments added (completion pending until further notice) #12
    [7_Segment_Section.SchDoc, Grant_..SchLib, Grantiot.PrjPcb]
2022-02-11 Compile mask added on 7 segment section. PCB updated.
    [7_Segment_Section.SchDoc, Grantv3.PcbDoc, Top Sheet.SchDoc]
2022-02-11 Changes done acc #17
    [Audio_Amplifier_Section.SchDoc, Battery_Management_Section.SchDoc, Connector_Section.SchDoc, Controller_Section.SchDoc, Grant_..PcbLib, Grant_..SchLib, Grantiot.PrjPcb, Grantv3.PcbDoc]
2022-02-13 changes done acc #17 #18
    [Grantv3.PcbDoc]
2022-02-25 #21 Completed
    [Grant_..PcbLib, Grant_..SchLib]
2022-02-25 Motor driver replaced #20. Rpull and caps for OLED added issue #19
    [7_Segment_Section.SchDoc, Controller_Section.SchDoc, Grant_..SchLib, Grantiot.PrjPcb, OLED_Section.SchDoc, Peripheral_Section.SchDoc, Top Sheet.SchDoc]
2022-02-25 #22 Completed
    [Grant_..PcbLib, Grant_..SchLib]
2022-02-26 OLED Control Circuit added.
    [Connector_Section.SchDoc, Controller_Section.SchDoc, OLED_Section.SchDoc]
2022-02-26 completed issue #25 and #26.
    [Grant_..PcbLib, Grant_..SchLib, Peripheral_Section.SchDoc, Power_Section.SchDoc]
2022-02-26 #25 Review Completed.
    [Grant_..PcbLib, Grant_..SchLib]
2022-02-28 #22 Completed.
    [Grant_..PcbLib, Grant_..SchLib]
2022-02-28 PCB Parts Placement acc #17 (incomplete)
    [Grantiot.PrjPcb, Grantv3.PcbDoc, OLED_Section.SchDoc]
2022-02-28 Reed switch and OLED connector added #19 #29
    [Controller_Section.SchDoc, Grantv3.PcbDoc, OLED_Section.SchDoc]
2022-02-28 PCB Parts Placement Acc #17
    [Audio_Amplifier_Section.SchDoc, Battery_Management_Section.SchDoc, Connector_Section.SchDoc, Controller_Section.SchDoc, Grantv3.PcbDoc, OLED_Section.SchDoc, Peripheral_Section.SchDoc, Power_Section.SchDoc]
2022-03-01 PCB Routing #18
    [Grantv3.PcbDoc, OLED_Section.SchDoc]
2022-03-02 PCB Routing #18 (completed)
    [Grantiot.PrjPcb, Grantv3.PcbDoc, Power_Section.SchDoc]
2022-03-03 LCSC BOM(incomplete) #32
    [Grantv3.PcbDoc, LCSC_BOM.xlsx]
2022-03-03 #33 Remianing
    [Digikey_BOM_Grant.xlsx]
2022-03-03 Minor Changes in PCB after Review. Refer #31 for details.
    [Grantiot.PrjPcb, Grantv3.PcbDoc]
2022-03-04 #33 Completed
    [Digikey_BOM_Grant.xlsx]
2022-03-04 LCSC BOM #32
    [LCSC_BOM.xlsx]
2022-03-04 Changes done acc to review #31
    [Grantv3.PcbDoc]
2022-03-04 #33 Capacitor changes completed
    [Digikey_BOM_Grant.xlsx]
2022-03-05 12V to LCD corrected.
2022-03-05 #35 Remaining
    [Grantiot-Altium-Generated.xlsx, LCSC_BOM.xlsx]
2022-03-07 #35 Completed
    [Digikey_BOM_Grant.xlsx, LCSC_BOM.xlsx]
2022-03-08 D2 replaced acc #38 and PCB Updated
    [Audio_Amplifier_Section.SchDoc, Battery_Management_Section.SchDoc, Connector_Section.SchDoc, Controller_Section.SchDoc, Grant_..PcbLib, Grant_..SchLib, Grantv3.PcbDoc, OLED_Section.SchDoc]
2022-03-08 Changes done acc #39
    [Audio_Amplifier_Section.SchDoc, Battery_Management_Section.SchDoc, Connector_Section.SchDoc, Controller_Section.SchDoc, Grantiot.PrjPcb, Grantv3.PcbDoc, OLED_Section.SchDoc, Peripheral_Section.SchDoc]
2022-03-08 BOM updated acc #40
    [Digikey_BOM_Grant.xlsx, LCSC_BOM.xlsx]
2022-03-08 audio section revised.
    [Audio_Amplifier_Section.SchDoc, Connector_Section.SchDoc, OLED_Section.SchDoc, Peripheral_Section.SchDoc]
2022-03-08 #35 (LS-SG555126000-30K) ye item Add kr dia ha BOM me
    [Digikey_BOM_Grant.xlsx, LCSC_BOM.xlsx]
2022-03-09 Deliverables Generated #42
    [Audio_Amplifier_Section.SchDoc, Controller_Section.SchDoc, Digikey_BOM_Grant.xlsx, Grantiot.PrjPcb, Grantv3.DWG, Grantv3.DXF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]
2022-03-10 Changes done acc #44 , #43
    [Audio_Amplifier_Section.SchDoc, Battery_Management_Section.SchDoc, Battery_Monitoring_Section.SchDoc, Connector_Section.SchDoc, Controller_Section.SchDoc, Grant_..PcbLib, Grant_..SchLib, Grantiot.PrjPcb]
2022-03-10 CAD Files for Project pushed
2022-03-10 #49 Completed
    [Button_Section.SchDoc, Connector_Section.SchDoc, Interface-Board.PrjPcb, Interface_PCB.PcbDoc, OLED_Section.SchDoc]
2022-03-10 issue #45 $46 completed. #51 pending.
    [Battery_Management_Section.SchDoc, Connector_Section.SchDoc, Controller_Section.SchDoc, Grant_..SchLib, OLED_Section.SchDoc, Peripheral_Section.SchDoc, Top Sheet.SchDoc]
2022-03-10 #49 #48 Completed
    [Button_Section.SchDoc, Connector_Section.SchDoc, Digikey_BOM_Grant.xlsx, Grant_..PcbLib, Grant_..SchLib, Interface-Board.PrjPcb, OLED_Section.SchDoc, Top_Sheet.SchDoc]
2022-03-11 Main and interface boards corrected and updated. #51 #49
    [Battery_Management_Section.SchDoc, Button_Section.SchDoc, Connector_Section.SchDoc, Controller_Section.SchDoc, Grantiot.PrjPcb, Grantv3.PcbDoc, Interface-Board.PrjPcb, Interface_PCB.PcbDoc]
2022-03-11 changes acc to #52 (some routes still remaining )
    [Grantv3.PcbDoc]
2022-03-12 Parts Placement of interface Board #52
    [Grantv3.PcbDoc, Interface_PCB.PcbDoc, OLED_Section.SchDoc]
2022-03-14 routing completed #57
    [Grantv3.PcbDoc, Interface_PCB.PcbDoc]
2022-03-14 Parts Placement completed #58
    [Battery_Monitoring_Section.SchDoc, Grantv3.PcbDoc, Interface_PCB.PcbDoc]
2022-03-15 Routing of Main_Board #60 (incomplete)
    [Audio_Amplifier_Section.SchDoc, Battery_Management_Section.SchDoc, Battery_Monitoring_Section.SchDoc, Connector_Section.SchDoc, Controller_Section.SchDoc, Grantiot.PrjPcb, Grantv3.PcbDoc, OLED_Section.SchDoc]
2022-03-16 PCB Routing #60 (incompleted)
    [Grantv3.PcbDoc]
2022-03-16 Extra PCB File Deleted (already in Chicken Feeder branch)
    [Grant..PcbDoc]
2022-03-16 Digikey BOM updated according to schematic changes and remaining mention in #62
    [Altium-Generated-Grantiot_BOM.xlsx, Altium-Generated-Interface-Board-BOM.xlsx, Digikey-Interface-Board-BOM.xlsx, Digikey_BOM_Grant.xlsx, Grantiot-Altium-Generated.xlsx]
2022-03-17 5 Boards digikey BOM for both PCB completed #62
    [(5 Board)Digikey_Main_Board-BOM.xlsx, (5 Boards)Digikey-Interface-Board-BOM.xlsx, Altium-Generated-Grantiot_BOM.xlsx, Digikey-Interface-Board-BOM.xlsx, Digikey_BOM_Grant.xlsx]
2022-03-17 #62 Formate Review Completed
    [(5 Board)Digikey_Main_Board-BOM.xlsx, (5 Boards)Digikey-Interface-Board-BOM.xlsx]
2022-03-17 Fresh PDF added (sent to client)
    [Audio_Amplifier_Section.SchDoc, Battery_Management_Section.SchDoc, Battery_Monitoring_Section.SchDoc, Connector_Section.SchDoc, Controller_Section.SchDoc, Grantiot.PrjPcb, OLED_Section.SchDoc, Peripheral_Section.SchDoc]
2022-03-19 Parts Placement acc to #61and Routing #60 (incomplete)
    [Grantv3.PcbDoc]
2022-03-21 Routing Completed #60 and deliverables generated #42
    [(5 Board)Digikey_Main_Board-BOM.xlsx, (5 Boards)Digikey-Interface-Board-BOM.xlsx, Altium-Generated-Grantiot_BOM.xlsx, Altium-Generated-Interface-Board-BOM.xlsx, BOM - Grant LCSC.xlsx, Battery_Monitoring_Section.SchDoc, Digikey_BOM_Grant.xlsx, Grantiot.PrjPcb]
2022-03-28 added test code for printing custom font with text highlighting
2022-03-29 #66 implemented excluding S1
    [Battery_Management_Section.SchDoc, Battery_Monitoring_Section.SchDoc, Connector_Section.SchDoc, Controller_Section.SchDoc, Grantiot.PrjPcb, Peripheral_Section.SchDoc, Power_Section.SchDoc, Top Sheet.SchDoc]
2022-03-30 #68 Completed
    [Grantiot.PrjPcb, Grantv3.PcbDoc]
2022-03-30 Main board BOM updated a/c #67
    [(5 Board)Digikey_Main_Board-BOM.xlsx, Altium-Generated-Grantiot_BOM.xlsx]
2022-03-30 #42 )Deliverables generated) acc to changes in #68
    [Grantiot.PrjPcb, Grantv3.DWG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]
2022-03-30 developing logic for button controlled dynamic screen in progress
2022-03-30 Minor changes in PCB during review of PCB. Refer to issue #31 for current update/progress.
    [Audio_Amplifier_Section.SchDoc, Connector_Section.SchDoc, Controller_Section.SchDoc, Grantiot.PrjPcb, Grantv3.PcbDoc, OLED_Section.SchDoc, Peripheral_Section.SchDoc, Power_Section.SchDoc]
2022-03-31 #42 Fresh deliverables generated after review #31
    [Grantiot.PrjPcb, Grantv3.DWG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]
2022-03-31 completed and successfully tested first timer screen
2022-03-31 added and tested 3 timer screens + welcome screen
2022-04-02 #71 Completed
    [Grant_..PcbLib, Grant_..SchLib]
2022-04-02 Fresh Deliverables created for both boards and #72 also resolved.
    [Audio_Amplifier_Section.SchDoc, Button_Section.SchDoc, Connector_Section.SchDoc, Controller_Section.SchDoc, Grantiot.PrjPcb, Grantv3.DWG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]
2022-04-02 added and tested rtc setting time, printing door status on Serial and playing song on settings
2022-04-04 #73 Completed
    [(5 Board)Digikey_Main_Board-BOM.xlsx, (5 Boards)Digikey-Interface-Board-BOM.xlsx, Altium-Generated-Grantiot_BOM.xlsx, Altium-Generated-Interface-Board-BOM.xlsx, BOM - Grant LCSC.xlsx, Digikey_BOM_Grant.xlsx, LCSC_BOM.xlsx, OLD_BOM - Grant LCSC.xlsx]
2022-04-04 Changes done acc #74 and deliverables generated #42
    [Grantiot.PrjPcb, Grantv3.DWG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]
2022-04-05 added test code for displaying battery icon (bitmap = 22 bytes)
2022-04-06 change open, current and open time in progress
2022-04-07 corrected change open time, close time and current time saving and displaying of time
2022-04-08 added scrolling functionality for device information submenu inside menu
2022-04-08 added submenu inside main menu for reboot and power off
2022-04-09 added actions for reboot and power off
2022-04-11 added battery icon on each screen
2022-04-11 added code to change battery icon dynamically based on battery sensing
2022-04-11 added code to show battery percent in text alongside battery
2022-04-13 removed bug of not displaying contents of timer when returning from last chance minutes selection
2022-04-13 added functionality of last chance timer and mins, remaining implementing logic
2022-04-28 added welcome and set current time screen
2022-04-29 stitched initial time screens with C++ STD List, tested with button clicks
2022-05-11 Correction in #87 completed.
    [Grantiot.PrjPcb, Power_Section.SchDoc, Top Sheet.SchDoc]
2022-05-12 Resolve the testing issues of RTC which was due to the MCP7490 library.
    [RTC_testing.ino]
2022-05-13 Sorted test codes of development board & custom board into their respective folder. And tested the Motor peripheral of our custom board and uploaded the test code.
2022-05-27 OLED peripheral I2C address code
    This code is working properly to get the I2C address of the OLED module.
2022-05-27 OLED display code
    The code is working after defining the Adafruit_SSD1306::begin(uint8_t vcs, uint8_t addr, bool reset, bool periphBegin) parameters properly.
    [OLED_Display.ino]
